myriadrf/LimeSDR-Micro/README.md

# LimeSDR Micro board M.2 (2280 B+M key) and mPCIe versions
NXP LA9310 Baseband processor + Lime Microsystems LMS7002M RF transceiver
