myriadrf/LimeSDR-Micro/hardware/M.2/1v2/PCB/LimeSDR-Micro_M.2_2280_1v2.PcbDoc.htm

Reporting Options

# File in Newer Format

Date | : | 2024-06-27
Time | : | 11:24:38
Filename | : | d:\LimePCBs\LimeSDR-Micro_M2\GIT\LimeSDR-Micro_M.2\hardware\1v0\PCB\LimeSDR-Micro_M.2_2280_1v0.PcbDoc

Version | Warning
Release 17.0 | CAUTION - Component parameters added.
Release 17.0 | CAUTION - Support of backdrilling
Release 17.1 | CAUTION - Support of waived violations
Release 17.1 | CAUTION - Support of object specific keepouts

This file was generated by a later version of the software
