myriadrf/LimeSDR-Micro/hardware/M.2/1v2/Project Outputs for LimeSDR-Micro_M.2_2280_1v2/ERC/LimeSDR-Micro_M.2_2280_1v2.html

Altium

# Electrical Rule Check Report

Date: | | 2026-03-31
Time: | | 09:28:13
Filename: | | d:\LimePCBs\LimeSDR-Micro\GIT\hardware\M.2\1v2\Project Outputs for LimeSDR-Micro_M.2_2280_1v2\ERC\LimeSDR-Micro_M.2_2280_1v2.html

Class | Document | Message

Warning

11_Power.SchDoc

GND contains IO Pin and Power Pin objects (Pin IC14-2,Pin IC18-4,Pin IC13-4,Pin IC2-4,Pin IC14-6,Pin IC4-7,Pin IC3-7,Pin IC6-B1,Pin IC6-B3,Pin IC6-B5,Pin IC6-B11,Pin IC6-B13,Pin IC6-B15,Pin IC6-C2,Pin IC6-C4,Pin IC6-C6,Pin IC6-C7,Pin IC6-C9,Pin IC6-C10,Pin IC6-C12,Pin IC6-C14,Pin IC6-D2,Pin IC6-D5,Pin IC6-D6,Pin IC6-D10,Pin IC6-D14,Pin IC6-E1,Pin IC6-E4,Pin IC6-E7,Pin IC6-E9,Pin IC6-E12,Pin IC6-E15,Pin IC4-EP,Pin IC3-EP,Pin IC6-F3,Pin IC6-F4,Pin IC6-F8,Pin IC6-F12,Pin IC6-G2,Pin IC6-G3,Pin IC6-G5,Pin IC6-G7,Pin IC6-G9,Pin IC6-G11,Pin IC6-H1,Pin IC6-H2,Pin IC6-H8,Pin IC6-H12,Pin IC6-H13,Pin IC6-H14,Pin IC6-H15,Pin IC6-J2,Pin IC6-J3,Pin IC6-J5,Pin IC6-J7,Pin IC6-J9,Pin IC6-J11,Pin IC6-J13,Pin IC6-K2,Pin IC6-K8,Pin IC6-K12,Pin IC6-L1,Pin IC6-L6,Pin IC6-L7,Pin IC6-L9,Pin IC6-L11,Pin IC6-M2,Pin X9-MOUNTING-HOLE,Pin IC6-N2,Pin IC6-N4,Pin IC6-N6,Pin X9-P1,Pin IC6-P1,Pin X9-P3,Pin IC6-P3,Pin IC6-P5,Pin X9-P21,Pin X9-P27,Pin X9-P33,Pin X9-P39,Pin X9-P45,Pin X9-P51,Pin X9-P57,Pin X9-P71,Pin X9-P73,Pin X9-P75,Pin IC13-PAD,Pin IC2-PAD)
Warning | 09_Misc.SchDoc | GNSS_FIX contains IO Pin and Output Pin objects (Pin IC14-21)
Warning | 10_Clock.SchDoc | LA_PPS_IN_LS contains IO Pin and Power Pin objects (Pin IC20-4,Pin IC6-K14)
Warning | 09_Misc.SchDoc | LA_PPS_OUT_LS contains IO Pin and Power Pin objects (Pin IC22-4,Pin IC6-M8)
Warning | 09_Misc.SchDoc | Net GNSS_ANT has no driving source (Pin ESD5-1,Pin IC11-3,Pin L1-1,Pin X5-1)
Warning | 09_Misc.SchDoc | Net GNSS_HW_R has no driving source (Pin C171-1,Pin IC11-7)
Warning | 09_Misc.SchDoc | Net GNSS_HW_S has no driving source (Pin C174-1,Pin IC11-8)
Warning | 09_Misc.SchDoc | Net LA_I2C_SCL has no driving source (Pin IC10-1,Pin IC10-4,Pin IC13-6,Pin IC14-8,Pin IC15-6,Pin IC18-5,Pin IC26-E5,Pin IC30-E5,Pin R26-1,Pin R115-2,Pin R204-2,Pin R222-2,Pin R225-2,Pin TP2-1,Pin VT1-D)
Warning | 05_LMS7002M_Misc.SchDoc | Net LMS_I2C_SCL has no driving source (Pin IC1-C27,Pin IC2-6,Pin R26-2,Pin R54-1)
Warning | 09_Misc.SchDoc | Net MCP_RESET has no driving source (Pin C178-1,Pin IC14-14,Pin R139-2)
Warning | 10_Clock.SchDoc | Net NetC185_2 has no driving source (Pin C185-2,Pin IC16-13)
Warning | 10_Clock.SchDoc | Net NetC186_2 has no driving source (Pin C186-2,Pin IC16-14)
Warning | 10_Clock.SchDoc | Net NetC192_2 has no driving source (Pin C192-2,Pin IC16-28)
Warning | 10_Clock.SchDoc | Net NetC193_2 has no driving source (Pin C193-2,Pin IC16-27)
Warning | 11_Power.SchDoc | Net NetC228_2 has no driving source (Pin C228-2,Pin FR45-2,Pin IC23-1,Pin IC23-6,Pin R194-1)
Warning | 11_Power.SchDoc | Net NetC238_2 has no driving source (Pin C238-2,Pin FR47-2,Pin IC27-1,Pin IC27-6,Pin R201-1)
Warning | 11_Power.SchDoc | Net NetC247_2 has no driving source (Pin C247-2,Pin FR48-2,Pin IC28-1,Pin IC28-6,Pin R207-1)
Warning | 11_Power.SchDoc | Net NetC254_2 has no driving source (Pin C254-2,Pin FR51-2,Pin IC29-1,Pin IC29-6,Pin R217-1)
Warning | 09_Misc.SchDoc | Net NetFR36_2 has no driving source (Pin FR36-2,Pin IC11-9)
Warning | 10_Clock.SchDoc | Net NetIC16_31 has no driving source (Pin IC16-31,Pin R156-2)
Warning | 10_Clock.SchDoc | Net NetIC18_2 has no driving source (Pin IC18-2,Pin R163-2,Pin R164-2)
Warning | 11_Power.SchDoc | Net NetIC23_5 has no driving source (Pin IC23-5,Pin R196-2,Pin R199-1)
Warning | 11_Power.SchDoc | Net NetIC27_5 has no driving source (Pin IC27-5,Pin R202-2,Pin R203-1)
Warning | 11_Power.SchDoc | Net NetIC28_5 has no driving source (Pin IC28-5,Pin R214-2,Pin R216-1)
Warning | 11_Power.SchDoc | Net NetIC29_5 has no driving source (Pin IC29-5,Pin R218-2,Pin R219-1)
Warning | 11_Power.SchDoc | Net NetIC31_4 has no driving source (Pin IC31-4,Pin R223-2,Pin R224-1)

Back to top
