myriadrf/LimeSDR-Micro/hardware/mPCIe/1v3/LimeSDR-Micro_mPCIe_1v3_DB_DFMr1/ERC/LimeSDR-Micro_mPCIe_1v3.html

Altium

# Electrical Rule Check Report

Date: | | 2026-01-09
Time: | | 19:05:35
Filename: | | D:\Aleksandr\Desktop\LimeSDR-Micro-main\LimeSDR-Micro-main\hardware\mPCIe\1v3\Project Outputs for LimeSDR-Micro_mPCIe_1v3\ERC\LimeSDR-Micro_mPCIe_1v3.html

Class | Document | Message

Warning

09_Misc.SchDoc

GND contains IO Pin and Power Pin objects (Pin IC15-3,Pin IC19-4,Pin IC14-4,Pin IC2-4,Pin IC15-6,Pin IC4-7,Pin IC3-7,Pin IC6-B1,Pin IC6-B3,Pin IC6-B5,Pin IC6-B11,Pin IC6-B13,Pin IC6-B15,Pin IC6-C2,Pin IC6-C4,Pin IC6-C6,Pin IC6-C7,Pin IC6-C9,Pin IC6-C10,Pin IC6-C12,Pin IC6-C14,Pin IC6-D2,Pin IC6-D5,Pin IC6-D6,Pin IC6-D10,Pin IC6-D14,Pin IC6-E1,Pin IC6-E4,Pin IC6-E7,Pin IC6-E9,Pin IC6-E12,Pin IC6-E15,Pin IC4-EP,Pin IC3-EP,Pin IC6-F3,Pin IC6-F4,Pin IC6-F8,Pin IC6-F12,Pin IC6-G2,Pin IC6-G3,Pin IC6-G5,Pin IC6-G7,Pin IC6-G9,Pin IC6-G11,Pin IC6-H1,Pin IC6-H2,Pin IC6-H8,Pin IC6-H12,Pin IC6-H13,Pin IC6-H14,Pin IC6-H15,Pin IC6-J2,Pin IC6-J3,Pin IC6-J5,Pin IC6-J7,Pin IC6-J9,Pin IC6-J11,Pin IC6-J13,Pin IC6-K2,Pin IC6-K8,Pin IC6-K12,Pin IC6-L1,Pin IC6-L6,Pin IC6-L7,Pin IC6-L9,Pin IC6-L11,Pin IC6-M2,Pin IC6-N2,Pin IC6-N4,Pin IC6-N6,Pin IC6-P1,Pin IC6-P3,Pin IC6-P5,Pin IC14-PAD,Pin IC2-PAD)
Warning | 09_Misc.SchDoc | GNSS_FIX contains IO Pin and Output Pin objects (Pin IC15-21)
Warning | 09_Misc.SchDoc | Net GNSS_ANT has no driving source (Pin ESD4-1,Pin IC11-3,Pin L1-1,Pin X5-1)
Warning | 09_Misc.SchDoc | Net GNSS_HW_R has no driving source (Pin C169-1,Pin IC11-7)
Warning | 09_Misc.SchDoc | Net GNSS_HW_S has no driving source (Pin C174-1,Pin IC11-8)
Warning | 10_Clock.SchDoc | Net LA_I2C_SCL has no driving source (Pin IC9-1,Pin IC9-4,Pin IC14-6,Pin IC15-8,Pin IC16-6,Pin IC19-5,Pin IC25-E5,Pin IC29-E5,Pin R26-1,Pin R132-2,Pin R140-2,Pin R175-2,Pin R197-2,Pin R215-2,Pin TP7-1,Pin VT1-D)
Warning | 05_LMS7002M_Misc.SchDoc | Net LMS_I2C_SCL has no driving source (Pin IC1-C27,Pin IC2-6,Pin R26-2,Pin R54-1)
Warning | 09_Misc.SchDoc | Net MCP_RESET has no driving source (Pin C178-1,Pin IC15-14,Pin R130-2)
Warning | 10_Clock.SchDoc | Net NetC185_2 has no driving source (Pin C185-2,Pin IC17-13)
Warning | 10_Clock.SchDoc | Net NetC186_2 has no driving source (Pin C186-2,Pin IC17-14)
Warning | 10_Clock.SchDoc | Net NetC192_2 has no driving source (Pin C192-2,Pin IC17-28)
Warning | 10_Clock.SchDoc | Net NetC193_2 has no driving source (Pin C193-2,Pin IC17-27)
Warning | 11_Power.SchDoc | Net NetC224_2 has no driving source (Pin C224-2,Pin FR44-2,Pin IC22-1,Pin IC22-6,Pin R187-1)
Warning | 11_Power.SchDoc | Net NetC234_2 has no driving source (Pin C234-2,Pin FR46-2,Pin IC26-1,Pin IC26-6,Pin R194-1)
Warning | 11_Power.SchDoc | Net NetC243_2 has no driving source (Pin C243-2,Pin FR47-2,Pin IC27-1,Pin IC27-6,Pin R200-1)
Warning | 11_Power.SchDoc | Net NetC250_2 has no driving source (Pin C250-2,Pin FR50-2,Pin IC28-1,Pin IC28-6,Pin R210-1)
Warning | 09_Misc.SchDoc | Net NetFR35_2 has no driving source (Pin FR35-2,Pin IC11-9)
Warning | 10_Clock.SchDoc | Net NetIC17_31 has no driving source (Pin IC17-31,Pin R152-2)
Warning | 10_Clock.SchDoc | Net NetIC19_2 has no driving source (Pin IC19-2,Pin R158-2,Pin R159-2)
Warning | 11_Power.SchDoc | Net NetIC22_5 has no driving source (Pin IC22-5,Pin R189-2,Pin R192-1)
Warning | 11_Power.SchDoc | Net NetIC26_5 has no driving source (Pin IC26-5,Pin R195-2,Pin R196-1)
Warning | 11_Power.SchDoc | Net NetIC27_5 has no driving source (Pin IC27-5,Pin R207-2,Pin R209-1)
Warning | 11_Power.SchDoc | Net NetIC28_5 has no driving source (Pin IC28-5,Pin R211-2,Pin R212-1)
Warning | 11_Power.SchDoc | Net NetIC30_4 has no driving source (Pin IC30-4,Pin R216-2,Pin R217-1)

Back to top
