myriadrf/LimeSDR-Micro/hardware/M.2/1v1/LimeSDR-Micro_M.2_2280_1v1_DB_DFMr0/DRC/LimeSDR-Micro_M.2_2280_1v1.html

Altium

# Design Rule Verification Report

Date: | | 2025-12-19
Time: | | 09:36:21
Elapsed Time: | | 00:00:29
Filename: | | d:\LimePCBs\LimeSDR-Micro\GIT\hardware\M.2\1v1\PCB\LimeSDR-Micro_M.2_2280_1v1.PcbDoc

Warnings: | | 0
Rule Violations: | | 0

## Summary

Warnings | Count
Total | 0

Rule Violations | Count
Clearance Constraint (Gap=0.1mm) (All),(All) | 0
Short-Circuit Constraint (Allowed=No) (All),(All) | 0
Un-Routed Net Constraint ( (All) ) | 0
Modified Polygon (Allow modified: No), (Allow shelved: No) | 0
Width Constraint (Min=0.1mm) (Max=5mm) (Preferred=0.2mm) (All) | 0
Width Constraint (Min=0.1mm) (Max=7mm) (Preferred=0.2mm) (All) | 0
Routing Layers(All) | 0
Routing Via (MinHoleWidth=0.15mm) (MaxHoleWidth=4.5mm) (PreferredHoleWidth=0.2mm) (MinWidth=0.3mm) (MaxWidth=5mm) (PreferedWidth=0.4mm) (All) | 0
Differential Pairs Uncoupled Length using the Gap Constraints (Min=0.1mm) (Max=0.2mm) (Prefered=0.1mm) and Width Constraints (Min=0.1mm) (Max=0.4mm) (Prefered=0.1mm) (InNet('FX3_XTAL_N') or InNet('FX3_XTAL_P')) | 0
Differential Pairs Uncoupled Length using the Gap Constraints (Min=0.1mm) (Max=0.14mm) (Prefered=0.1mm) and Width Constraints (Min=0.1mm) (Max=0.2mm) (Prefered=0.1mm) (InNetClass('TX_RF')) | 0
Differential Pairs Uncoupled Length using the Gap Constraints (Min=0.1mm) (Max=0.3mm) (Prefered=0.1mm) and Width Constraints (Min=0.1mm) (Max=0.3mm) (Prefered=0.1mm) (InNetClass('RX_RF')) | 0
Differential Pairs Uncoupled Length using the Gap Constraints (Min=0.1mm) (Max=0.3mm) (Prefered=0.1mm) and Width Constraints (Min=0.1mm) (Max=0.5mm) (Prefered=0.2mm) (All) | 0
Differential Pairs Uncoupled Length using the Gap Constraints (Min=0.1mm) (Max=0.3mm) (Prefered=0.14mm) and Width Constraints (Min=0.2mm) (Max=0.2mm) (Prefered=0.2mm) (InNetClass('FX3_DATA')) | 0
Power Plane Connect Rule(Relief Connect )(Expansion=0.508mm) (Conductor Width=0.254mm) (Air Gap=0.254mm) (Entries=4) (All) | 0
Hole Size Constraint (Min=0.15mm) (Max=10mm) (All) | 0
Pads and Vias to follow the Drill pairs settings | 0
Hole To Hole Clearance (Gap=0.15mm) (All),(All) | 0
Minimum Solder Mask Sliver (Gap=0.05mm) (All),(All) | 0
Net Antennae (Tolerance=0mm) (All) | 0
Matched Lengths(Tolerance=7mm) (InNetClass('LMS_PORT1')) | 0
Matched Lengths(Tolerance=5mm) (InNetClass('FT_FIFO')) | 0
Matched Lengths(Tolerance=7.5mm) (InNetClass('LMS_PORT2')) | 0
Component Clearance Constraint ( Horizontal Gap = -2mm, Vertical Gap = Infinite ) (HasFootprint('RAKON_RPT7050A')),(HasFootprint('RAKON_TXCO')) | 0
Component Clearance Constraint ( Horizontal Gap = 0.01mm, Vertical Gap = 0.254mm ) (All),(All) | 0
Component Clearance Constraint ( Horizontal Gap = -10mm, Vertical Gap = Infinite ) (InComponent('MECH*') or InComponent('J3')),(All) | 0
Component Clearance Constraint ( Horizontal Gap = -1mm, Vertical Gap = Infinite ) (InComponent('IC7')),(InComponent('R75') or InComponent('R74') or InComponent('R84')or InComponent('C131')) | 0
Component Clearance Constraint ( Horizontal Gap = -1mm, Vertical Gap = Infinite ) (HasFootprint('PCIE_M.2_2280_B+M_KEY')),(All) | 0
Height Constraint (Min=0mm) (Max=20mm) (Prefered=1.5mm) (OnTop) | 0
Height Constraint (Min=0mm) (Max=10mm) (Prefered=1.35mm) (OnBottom) | 0
Total | 0
