myriadrf/LimeSDR-Micro/hardware/M.2/1v0/LimeSDR-Micro_M.2_2280_1v0_DB_DFMr3/ERC/LimeSDR-Micro_M.2_2280_1v0.html

Altium

# Electrical Rule Check Report

Date: | | 2024-11-27
Time: | | 14:28:39
Filename: | | d:\LimePCBs\LimeSDR-Micro_M2\GIT\LimeSDR-Micro_M.2\hardware\1v0\Project Outputs for LimeSDR-Micro_M.2_2280_1v0\ERC\LimeSDR-Micro_M.2_2280_1v0.html

Class | Document | Message

Warning

11_Power.SchDoc

GND contains IO Pin and Power Pin objects (Pin IC14-2,Pin IC14-3,Pin IC18-4,Pin IC13-4,Pin IC2-4,Pin IC14-6,Pin IC4-7,Pin IC3-7,Pin IC6-B1,Pin IC6-B3,Pin IC6-B5,Pin IC6-B11,Pin IC6-B13,Pin IC6-B15,Pin IC6-C2,Pin IC6-C4,Pin IC6-C6,Pin IC6-C7,Pin IC6-C9,Pin IC6-C10,Pin IC6-C12,Pin IC6-C14,Pin IC6-D2,Pin IC6-D5,Pin IC6-D6,Pin IC6-D10,Pin IC6-D14,Pin IC6-E1,Pin IC6-E4,Pin IC6-E7,Pin IC6-E9,Pin IC6-E12,Pin IC6-E15,Pin IC4-EP,Pin IC3-EP,Pin IC6-F3,Pin IC6-F4,Pin IC6-F8,Pin IC6-F12,Pin IC6-G2,Pin IC6-G3,Pin IC6-G5,Pin IC6-G7,Pin IC6-G9,Pin IC6-G11,Pin IC6-H1,Pin IC6-H2,Pin IC6-H8,Pin IC6-H12,Pin IC6-H13,Pin IC6-H14,Pin IC6-H15,Pin IC6-J2,Pin IC6-J3,Pin IC6-J5,Pin IC6-J7,Pin IC6-J9,Pin IC6-J11,Pin IC6-J13,Pin IC6-K2,Pin IC6-K8,Pin IC6-K12,Pin IC6-L1,Pin IC6-L6,Pin IC6-L7,Pin IC6-L9,Pin IC6-L11,Pin IC6-M2,Pin X9-MOUNTING-HOLE,Pin IC6-N2,Pin IC6-N4,Pin IC6-N6,Pin X9-P1,Pin IC6-P1,Pin X9-P3,Pin IC6-P3,Pin IC6-P5,Pin X9-P21,Pin X9-P27,Pin X9-P33,Pin X9-P39,Pin X9-P45,Pin X9-P51,Pin X9-P57,Pin X9-P71,Pin X9-P73,Pin X9-P75,Pin IC13-PAD,Pin IC2-PAD)
Warning | 09_Misc.SchDoc | GNSS_FIX contains IO Pin and Output Pin objects (Pin IC14-21)
Warning | 10_Clock.SchDoc | LA_PPS_IN_LS contains IO Pin and Power Pin objects (Pin IC19-4,Pin IC6-K14)
Warning | 09_Misc.SchDoc | LA_PPS_OUT_LS contains IO Pin and Power Pin objects (Pin IC21-4,Pin IC6-M8)
Warning | 09_Misc.SchDoc | Net GNSS_ANT has no driving source (Pin ESD5-1,Pin IC11-3,Pin L1-1,Pin X5-1)
Warning | 09_Misc.SchDoc | Net GNSS_HW_R has no driving source (Pin C171-1,Pin IC11-7)
Warning | 09_Misc.SchDoc | Net GNSS_HW_S has no driving source (Pin C174-1,Pin IC11-8)
Warning | 09_Misc.SchDoc | Net LA_I2C_SCL has no driving source (Pin IC10-1,Pin IC10-4,Pin IC13-6,Pin IC14-8,Pin IC18-5,Pin IC25-E5,Pin IC29-E5,Pin R26-1,Pin R143-2,Pin R203-2,Pin R221-2,Pin TP4-1,Pin VT1-D)
Warning | 05_LMS7002M_Misc.SchDoc | Net LMS_I2C_SCL has no driving source (Pin IC1-C27,Pin IC2-6,Pin R26-2,Pin R54-1)
Warning | 09_Misc.SchDoc | Net MCP_RESET has no driving source (Pin C178-1,Pin IC14-14,Pin R135-2)
Warning | 11_Power.SchDoc | Net NetC225_2 has no driving source (Pin C225-2,Pin FR45-2,Pin IC22-1,Pin IC22-6,Pin R193-1)
Warning | 11_Power.SchDoc | Net NetC235_2 has no driving source (Pin C235-2,Pin FR47-2,Pin IC26-1,Pin IC26-6,Pin R200-1)
Warning | 11_Power.SchDoc | Net NetC244_2 has no driving source (Pin C244-2,Pin FR48-2,Pin IC27-1,Pin IC27-6,Pin R206-1)
Warning | 11_Power.SchDoc | Net NetC251_2 has no driving source (Pin C251-2,Pin FR51-2,Pin IC28-1,Pin IC28-6,Pin R216-1)
Warning | 09_Misc.SchDoc | Net NetFR36_2 has no driving source (Pin FR36-2,Pin IC11-9)
Warning | 10_Clock.SchDoc | Net NetIC18_2 has no driving source (Pin IC18-2,Pin R164-2,Pin R165-2)
Warning | 11_Power.SchDoc | Net NetIC22_5 has no driving source (Pin IC22-5,Pin R195-2,Pin R198-1)
Warning | 11_Power.SchDoc | Net NetIC26_5 has no driving source (Pin IC26-5,Pin R201-2,Pin R202-1)
Warning | 11_Power.SchDoc | Net NetIC27_5 has no driving source (Pin IC27-5,Pin R213-2,Pin R215-1)
Warning | 11_Power.SchDoc | Net NetIC28_5 has no driving source (Pin IC28-5,Pin R217-2,Pin R218-1)
Warning | 11_Power.SchDoc | Net NetIC30_4 has no driving source (Pin IC30-4,Pin R222-2,Pin R223-1)

Back to top
