myriadrf/LimeSDR-Micro/hardware/mPCIe/1v2/Project Outputs for LimeSDR-Micro_1v2/ERC/LimeSDR-Micro_1v2.html

Altium

# Electrical Rule Check Report

Date: | | 2024-11-27
Time: | | 17:11:42
Filename: | | d:\LimePCBs\LimeSDR-Micro\GIT\hardware\1v2\Project Outputs for LimeSDR-Micro_1v2\ERC\LimeSDR-Micro_1v2.html

Class | Document | Message

Warning

09_Misc.SchDoc

GND contains IO Pin and Power Pin objects (Pin IC15-2,Pin IC15-3,Pin IC19-4,Pin IC14-4,Pin IC2-4,Pin IC15-6,Pin IC4-7,Pin IC3-7,Pin IC6-B1,Pin IC6-B3,Pin IC6-B5,Pin IC6-B11,Pin IC6-B13,Pin IC6-B15,Pin IC6-C2,Pin IC6-C4,Pin IC6-C6,Pin IC6-C7,Pin IC6-C9,Pin IC6-C10,Pin IC6-C12,Pin IC6-C14,Pin IC6-D2,Pin IC6-D5,Pin IC6-D6,Pin IC6-D10,Pin IC6-D14,Pin IC6-E1,Pin IC6-E4,Pin IC6-E7,Pin IC6-E9,Pin IC6-E12,Pin IC6-E15,Pin IC4-EP,Pin IC3-EP,Pin IC6-F3,Pin IC6-F4,Pin IC6-F8,Pin IC6-F12,Pin IC6-G2,Pin IC6-G3,Pin IC6-G5,Pin IC6-G7,Pin IC6-G9,Pin IC6-G11,Pin IC6-H1,Pin IC6-H2,Pin IC6-H8,Pin IC6-H12,Pin IC6-H13,Pin IC6-H14,Pin IC6-H15,Pin IC6-J2,Pin IC6-J3,Pin IC6-J5,Pin IC6-J7,Pin IC6-J9,Pin IC6-J11,Pin IC6-J13,Pin IC6-K2,Pin IC6-K8,Pin IC6-K12,Pin IC6-L1,Pin IC6-L6,Pin IC6-L7,Pin IC6-L9,Pin IC6-L11,Pin IC6-M2,Pin IC6-N2,Pin IC6-N4,Pin IC6-N6,Pin IC6-P1,Pin IC6-P3,Pin IC6-P5,Pin IC14-PAD,Pin IC2-PAD)
Warning | 09_Misc.SchDoc | GNSS_FIX contains IO Pin and Output Pin objects (Pin IC15-21)
Warning | 09_Misc.SchDoc | Net GNSS_ANT has no driving source (Pin ESD5-1,Pin IC11-3,Pin L1-1,Pin X5-1)
Warning | 09_Misc.SchDoc | Net GNSS_HW_R has no driving source (Pin C171-1,Pin IC11-7)
Warning | 09_Misc.SchDoc | Net GNSS_HW_S has no driving source (Pin C176-1,Pin IC11-8)
Warning | 09_Misc.SchDoc | Net LA_I2C_SCL has no driving source (Pin IC9-1,Pin IC9-4,Pin IC14-6,Pin IC15-8,Pin IC19-5,Pin IC24-E5,Pin IC28-E5,Pin R26-1,Pin R138-2,Pin R140-2,Pin R194-2,Pin R212-2,Pin VT1-D)
Warning | 05_LMS7002M_Misc.SchDoc | Net LMS_I2C_SCL has no driving source (Pin IC1-C27,Pin IC2-6,Pin R26-2,Pin R54-1)
Warning | 09_Misc.SchDoc | Net MCP_RESET has no driving source (Pin C180-1,Pin IC15-14,Pin R130-2)
Warning | 11_Power.SchDoc | Net NetC223_2 has no driving source (Pin C223-2,Pin FR45-2,Pin IC21-1,Pin IC21-6,Pin R184-1)
Warning | 11_Power.SchDoc | Net NetC233_2 has no driving source (Pin C233-2,Pin FR47-2,Pin IC25-1,Pin IC25-6,Pin R191-1)
Warning | 11_Power.SchDoc | Net NetC242_2 has no driving source (Pin C242-2,Pin FR48-2,Pin IC26-1,Pin IC26-6,Pin R197-1)
Warning | 11_Power.SchDoc | Net NetC249_2 has no driving source (Pin C249-2,Pin FR51-2,Pin IC27-1,Pin IC27-6,Pin R207-1)
Warning | 09_Misc.SchDoc | Net NetFR36_2 has no driving source (Pin FR36-2,Pin IC11-9)
Warning | 10_Clock.SchDoc | Net NetIC19_2 has no driving source (Pin IC19-2,Pin R161-2,Pin R162-2)
Warning | 11_Power.SchDoc | Net NetIC21_5 has no driving source (Pin IC21-5,Pin R186-2,Pin R189-1)
Warning | 11_Power.SchDoc | Net NetIC25_5 has no driving source (Pin IC25-5,Pin R192-2,Pin R193-1)
Warning | 11_Power.SchDoc | Net NetIC26_5 has no driving source (Pin IC26-5,Pin R204-2,Pin R206-1)
Warning | 11_Power.SchDoc | Net NetIC27_5 has no driving source (Pin IC27-5,Pin R208-2,Pin R209-1)
Warning | 11_Power.SchDoc | Net NetIC29_4 has no driving source (Pin IC29-4,Pin R213-2,Pin R214-1)

Back to top
