myriadrf/LimeSDR-Micro/hardware/mPCIe/1v1/Project Outputs for LimeSDR-Micro_1v1/ERC/LimeSDR-Micro_1v1.html

Altium

# Electrical Rule Check Report

Date: | | 2024-06-27
Time: | | 14:33:22
Filename: | | d:\LimePCBs\LimeSDR-Micro\GIT\hardware\1v1\Project Outputs for LimeSDR-Micro_1v1\ERC\LimeSDR-Micro_1v1.html

Class | Document | Message

Warning

09_Misc.SchDoc

GND contains IO Pin and Power Pin objects (Pin IC15-2,Pin IC15-3,Pin IC21-4,Pin IC14-4,Pin IC2-4,Pin IC15-6,Pin IC4-7,Pin IC3-7,Pin IC6-B1,Pin IC6-B3,Pin IC6-B5,Pin IC6-B11,Pin IC6-B13,Pin IC6-B15,Pin IC6-C2,Pin IC6-C4,Pin IC6-C6,Pin IC6-C7,Pin IC6-C9,Pin IC6-C10,Pin IC6-C12,Pin IC6-C14,Pin IC6-D2,Pin IC6-D5,Pin IC6-D6,Pin IC6-D10,Pin IC6-D14,Pin IC6-E1,Pin IC6-E4,Pin IC6-E7,Pin IC6-E9,Pin IC6-E12,Pin IC6-E15,Pin IC4-EP,Pin IC3-EP,Pin IC6-F3,Pin IC6-F4,Pin IC6-F8,Pin IC6-F12,Pin IC6-G2,Pin IC6-G3,Pin IC6-G5,Pin IC6-G7,Pin IC6-G9,Pin IC6-G11,Pin IC6-H1,Pin IC6-H2,Pin IC6-H8,Pin IC6-H12,Pin IC6-H13,Pin IC6-H14,Pin IC6-H15,Pin IC6-J2,Pin IC6-J3,Pin IC6-J5,Pin IC6-J7,Pin IC6-J9,Pin IC6-J11,Pin IC6-J13,Pin IC6-K2,Pin IC6-K8,Pin IC6-K12,Pin IC6-L1,Pin IC6-L6,Pin IC6-L7,Pin IC6-L9,Pin IC6-L11,Pin IC6-M2,Pin IC6-N2,Pin IC6-N4,Pin IC6-N6,Pin IC6-P1,Pin IC6-P3,Pin IC6-P5,Pin IC14-PAD,Pin IC2-PAD)
Warning | 09_Misc.SchDoc | GNSS_FIX contains IO Pin and Output Pin objects (Pin IC15-21)
Warning | 09_Misc.SchDoc | Net GNSS_ANT has no driving source (Pin ESD5-1,Pin IC11-3,Pin L1-1,Pin X5-1)
Warning | 09_Misc.SchDoc | Net GNSS_HW_R has no driving source (Pin C171-1,Pin IC11-7)
Warning | 09_Misc.SchDoc | Net GNSS_HW_S has no driving source (Pin C176-1,Pin IC11-8)
Warning | 09_Misc.SchDoc | Net LA_I2C_SCL has no driving source (Pin IC9-1,Pin IC9-4,Pin IC14-6,Pin IC15-8,Pin IC21-5,Pin IC26-E5,Pin IC30-E5,Pin R26-1,Pin R140-2,Pin R142-2,Pin R197-2,Pin R211-2,Pin VT1-D,Pin X6-1)
Warning | 05_LMS7002M_Misc.SchDoc | Net LMS_I2C_SCL has no driving source (Pin IC1-C27,Pin IC2-6,Pin R26-2,Pin R54-1)
Warning | 09_Misc.SchDoc | Net MCP_RESET has no driving source (Pin C180-1,Pin IC15-14,Pin R128-2)
Warning | 11_Power.SchDoc | Net NetC216_2 has no driving source (Pin C216-2,Pin FR42-2,Pin IC24-1,Pin IC24-6,Pin R188-1)
Warning | 11_Power.SchDoc | Net NetC225_2 has no driving source (Pin C225-2,Pin FR44-2,Pin IC27-1,Pin IC27-6,Pin R194-1)
Warning | 11_Power.SchDoc | Net NetC234_2 has no driving source (Pin C234-2,Pin FR45-2,Pin IC28-1,Pin IC28-6,Pin R200-1)
Warning | 11_Power.SchDoc | Net NetC243_2 has no driving source (Pin C243-2,Pin FR50-2,Pin IC29-1,Pin IC29-6,Pin R204-1)
Warning | 09_Misc.SchDoc | Net NetFR36_2 has no driving source (Pin FR36-2,Pin IC11-9)
Warning | 10_Clock.SchDoc | Net NetIC21_2 has no driving source (Pin IC21-2,Pin R160-2,Pin R161-2)
Warning | 11_Power.SchDoc | Net NetIC24_5 has no driving source (Pin IC24-5,Pin R189-2,Pin R192-1)
Warning | 11_Power.SchDoc | Net NetIC27_5 has no driving source (Pin IC27-5,Pin R195-2,Pin R196-1)
Warning | 11_Power.SchDoc | Net NetIC28_5 has no driving source (Pin IC28-5,Pin R201-2,Pin R203-1)
Warning | 11_Power.SchDoc | Net NetIC29_5 has no driving source (Pin IC29-5,Pin R206-2,Pin R208-1)
Warning | 11_Power.SchDoc | Net NetIC31_4 has no driving source (Pin IC31-4,Pin R212-2,Pin R213-1)

Back to top
