myriadrf/LimeSDR-Micro/hardware/M.2/1v2/Project Outputs for LimeSDR-Micro_M.2_2280_1v2/BOM/LimeSDR-Micro_M.2_2280_1v2_BOMr0.xls

Item # | Comment | Quantity | Designator | Footprint | Manufacturer | Manufacturer Part Number 1 | Supplier 1 | Supplier Part Number 1 | Part Description
1 | 4.7pF, 25V | 14 | C1, C2, C3, C4, C5, C6, C9, C11, C14, C16, C19, C21, C24, C26 | CAP01005 | Murata | GRM0225C1E4R7BA03L | Digi-Key | 490-13585-1-ND | CAP CER 4.7PF 25V C0G/NP0 01005
2 | 22pF, 50V | 9 | C7, C169, C170, C171, C174, C222, C223, C224, C225 | CAP0201 | Murata | GRM0335C1H220JA01D | Digi-Key | 490-6123-1-ND | 22 pF ±5% 50V Ceramic Capacitor C0G, NP0 0201 (0603 Metric)
3 | 1uF, 6.3V | 60 | C28, C52, C54, C55, C56, C57, C58, C59, C61, C63, C65, C66, C67, C68, C70, C71, C72, C73, C74, C75, C76, C77, C78, C79, C80, C81, C82, C84, C85, C86, C87, C88, C89, C91, C93, C95, C97, C99, C100, C101, C102, C103, C104, C105, C106, C107, C108, C109, C110, C111, C115, C128, C150, C181, C187, C195, C198, C252, C265, C266 | CAP0201 | TDK Corporation | JMK063ABJ105MP-F | Digi-Key | 587-5864-2-ND | 1µF ±20% 6.3V X5R Ceramic Capacitor -55°C ~ 85°C Surface Mount, MLCC 0201 (0603 Metric) 0.024" L x 0.012" W (0.60mm x 0.30mm)
4 | 100pF, 50V | 20 | C29, C30, C33, C34, C133, C175, C182, C188, C189, C199, C200, C207, C208, C209, C211, C212, C213, C214, C215, C221 | CAP0201 | TDK | C0603C0G1H101J030BA | Digi-Key | 445-1786-1-ND | 100 pF ±5% 50V Ceramic Capacitor C0G, NP0 0201 (0603 Metric)
5 | 100nF, 6.3V | 44 | C31, C32, C35, C36, C45, C50, C51, C126, C132, C134, C151, C163, C164, C165, C166, C168, C172, C173, C177, C178, C179, C180, C183, C184, C185, C186, C190, C191, C192, C193, C194, C201, C202, C204, C205, C210, C216, C217, C218, C226, C227, C232, C244, C262 | CAP0201 | Samsung | CL03A104MP3NNNC | Digi-Key | 1276-1321-1-ND | 0.1 µF ±20% 10V Ceramic Capacitor X5R 0201 (0603 Metric)
6 | 1nF, 25V | 23 | C37, C38, C43, C46, C47, C48, C49, C53, C60, C62, C64, C69, C83, C90, C92, C94, C96, C98, C167, C203, C206, C219, C220 | CAP0201 | TDK Corporation | C0603X7R1E102K030BA | Digi-Key | 445-7275-1-ND | 1000pF ±10% 25V X7R Ceramic Capacitor -55°C ~ 125°C Surface Mount, MLCC 0201 (0603 Metric) 0.024" L x 0.012" W (0.60mm x 0.30mm)
7 | 510pF, 50V | 3 | C39, C40, C41 | CAP0402 | Murata Electronics North America | GRM1555C1H511JA01D | Digi-Key | 490-3237-1-ND | 510pF ±5% 50V C0G, NP0 Ceramic Capacitor -55°C ~ 125°C Surface Mount, MLCC 0402 (1005 Metric) 0.039" L x 0.020" W (1.00mm x 0.50mm)
8 | 220nF, 10V | 7 | C112, C113, C114, C116, C118, C125, C129 | CAP0201 | Murata | GRM033R61A224ME90D | Digi-Key | 490-9984-1-ND | 0.22 µF ±20% 10V Ceramic Capacitor X5R 0201 (0603 Metric)
9 | 1uF, 6.3V | 5 | C117, C135, C144, C148, C156 | CAP0603_FEEDTHROUGH | TDK | YFF18PH0J105MT000N | Digi-Key | 445-3029-1-ND | 1 µF Feed Through Capacitor 6.3V 4 A 12mOhm 0603 (1608 Metric), 4 PC Pad
10 | 47uF, 6.3V | 9 | C119, C236, C241, C245, C246, C256, C259, C263, C264 | CAP0603 | Murata | GRM188R60J476ME15D | Digi-Key | 490-13247-1-ND | 47 µF ±20% 6.3V Ceramic Capacitor X5R 0603 (1608 Metric)
11 | 4.7uF, 6.3V | 19 | C120, C122, C123, C130, C131, C138, C139, C140, C141, C142, C143, C146, C147, C154, C155, C159, C160, C161, C162 | CAP0201 | Murata | GRM035R60J475ME15J | Digi-Key | 490-GRM035R60J475ME15JCT-ND | 4.7 µF ±20% 6.3V Ceramic Capacitor X5R 0201 (0603 Metric)
12 | 2.2uF, 6.3V | 5 | C121, C136, C145, C152, C157 | CAP0201 | Murata | GRM033R60J225ME47D | Digi-Key | 490-13225-1-ND | CAP CER 2.2UF 6.3V X5R 0201
13 | 3.3nF, 16V | 1 | C124 | CAP0201 | Murata | GRM033R71C332KA88D | Digikey | 490-3191-1-ND | 3300 pF ±10% 16V Ceramic Capacitor X7R 0201 (0603 Metric)
14 | 10uF, 10V | 5 | C127, C137, C149, C153, C158 | CAP0402 | Murata | GRM155R61A106ME11D | Digi-Key | 490-GRM155R61A106ME11DCT-ND | 10 µF ±20% 10V Ceramic Capacitor X5R 0402 (1005 Metric)
15 | 4.7uF, 6.3V | 10 | C176, C228, C229, C238, C239, C247, C248, C250, C254, C255 | CAP0402 | Murata Electronics North America | GRM155R60J475ME87D | Digi-Key | 490-5408-1-ND | 4.7µF ±20% 6.3V X5R Ceramic Capacitor -55°C ~ 85°C Surface Mount, MLCC 0402 (1005 Metric) 0.039" L x 0.020" W (1.00mm x 0.50mm)
16 | 1uF, 10V | 1 | C230 | CAP0402 | TDK | C1005X5R1E105K050BC | Digi-Key | 445-9066-1-ND | 1µF ±10% 10V X5R Ceramic Capacitor -55°C ~ 85°C Surface Mount, MLCC 0402 (1005 Metric) 0.039" L x 0.020" W (1.00mm x 0.50mm)
17 | 10uF, 10V | 10 | C231, C235, C237, C240, C242, C251, C253, C257, C258, C261 | CAP0603 | Murata | GRM188R61A106ME69D | Digi-Key | 490-10475-1-ND | 10 µF ±20% 10V Ceramic Capacitor X5R 0603 (1608 Metric)
18 | RB521S-30L2-TP | 3 | D1, D2, D3 | RB521S-30L2-TP_DFN1006 | MCC | RB521S-30L2-TP | Digi-Key | RB521S-30L2-TPMSCT-ND | DIODE SCHOTTKY 30V 100MA 2TDFN
19 | ESD8472 | 9 | ESD1, ESD2, ESD3, ESD5, ESD6, ESD7, ESD8, ESD9, ESD10 | ESD8472_X3DFN2 | ON Semiconductor | ESD8472MUT5G | Digi-Key | ESD8472MUT5GOSCT-ND | TVS DIODE 5.3VWM 14VC X3DFN2
20 | Fiducial | 8 | F1, F2, F3, F4, F5, F6, F7, F8 | Fiducial
21 | Fiducial | 2 | FL1, FL2 | Fiducial_local
22 | 600R, 0.27A | 41 | FR2, FR3, FR4, FR5, FR6, FR7, FR8, FR9, FR10, FR11, FR12, FR13, FR14, FR15, FR16, FR17, FR18, FR19, FR20, FR21, FR22, FR23, FR24, FR25, FR26, FR27, FR28, FR29, FR30, FR31, FR32, FR33, FR34, FR35, FR36, FR37, FR39, FR40, FR42, FR43, FR44 | RES0201 | Taiyo Yuden | BK0603TS601-T | Digi-Key | 587-3277-1-ND | FERRITE BEAD 600 OHM 0201 1LN
23 | 220R, 0.9A | 8 | FR38, FR41, FR45, FR47, FR48, FR49, FR50, FR51 | RES0402 | TDK Corporation | MPZ1005S221ET000 | Digi-Key | 445-9329-2-ND | FERRITE BEAD 220 OHM 0402 1LN
24 | 600R, 2A | 1 | FR46 | RES0805 | TDK Corporation | MPZ2012S601AT000 | Digi-Key | 445-2206-2-ND | FERRITE BEAD 600 OHM 0805 1LN
25 | LMS7002M | 1 | IC1 | LMS7002M_v5_LESS_SILK | Lime Microsystems | LMS7002M | Lime Microsystems | LMS7002M | IC FPRF Transceiver LMS7002M; 261 pin aQFN
26 | SKY13414-485LF | 2 | IC3, IC4 | SKY13414-485LF_RF_SW_QFN14 | Skyworks Solutions | SKY13414-485LF | Digi-Key | 863-1582-1-ND | RF Switch IC General Purpose SP4T 3 GHz 50Ohm 14-QFN (2x2)
27 | SKY13330-397LF | 1 | IC5 | SKY13330-397LF_RF_SW_QFN12 | Skyworks Solutions | SKY13330-397LF | Digi-Key | 863-1643-1-ND | RF Switch IC W-CDMA SPDT 6 GHz 50Ohm 12-QFN (2x2)
28 | LA9310X7S11AA | 1 | IC6 | LA9310X7S11AA | NXP Semiconductors | LA9310X7S11AA | NXP Semiconductors | LA9310X7S11AA | LFBGA157, low profile, fine-pitch ball grid array package, 157 terminals, 0.5 mm pitch, 8 mm x 8 mm x 1.25 mm body.
29 | SN65LVDS1 | 1 | IC7 | SOT23-5_NO_SILK | TEXAS INSTRUMENTS | SN65LVDS1DBVR | Newark | 76C0715 | DIFFERENTIAL LINE DRIVER/RECEIVER SIGNAL SOT23-5
30 | SN74AVC4T774 | 3 | IC8, IC9, IC12 | SN74AVC4T774_v1 | Texas Instruments | SN74AVC4T774RSVR | Digi-Key | 296-24741-6-ND | Voltage Level Translator Bidirectional 1 Circuit 4 Channel 380Mbps 16-UQFN (2.6x1.8)
31 | TMP1075NDRLR | 1 | IC10 | TMP1075NDRLR_temperature_sensor_SOT563 | Texas Instruments | TMP1075NDRLR | Digi-Key | 296-TMP1075NDRLRCT-ND | Temperature Sensor Digital, Local -40°C ~ 125°C 12 b SOT-563
32 | GNSS M10578-A3 | 1 | IC11 | M10578-A3_v2 | Antenova | M10578-A3 | Digi-Key | 627-1074-1-ND | RADIONOVA RF Receiver GPS 1.575GHz -165dBm Module
33 | M24512 | 1 | IC13 | M24128-DFMC6TG | STMicroelectronics | M24512-DFMC6TG | Digi-Key | 497-15745-1-ND | IC EEPROM 512KBIT I2C 8UFDFPN
34 | MCP23017-E/ML | 1 | IC14 | MCP23017-E/ML_QFN28 | Microchip | MCP23017-E/ML | Digi-Key | MCP23017-E/ML-ND | I/O Expander 16 I²C 1.7 MHz 28-QFN (6x6)
35 | LMK00101 | 1 | IC16 | LMK00101_WQFN32 | Texas Instruments | LMK00101SQE/NOPB | Digi-Key | 296-39036-1-ND | Clock Fanout Buffer (Distribution), Multiplexer, Translator IC 200MHz 32-WFQFN Exposed Pad
36 | 74LVC1G3157FZ4 | 3 | IC17, IC19, IC24 | 74LVC1G3157FZ4_SPDT_SW_DFN1410-6 | Diodes | 74LVC1G3157FZ4-7 | Digi-Key | 74LVC1G3157FZ4-7DICT-ND | 1 Circuit IC Switch 2:1 10Ohm X2-DFN1410-6
37 | AD5693BCPZ-RL7 | 1 | IC18 | AD5693RACPZ-1RL7_DAC_8LFCSP | Analog Devices | AD5693BCPZ-RL7 | Digikey | 505-AD5693BCPZ-RL7CT-ND | 16 Bit Digital to Analog Converter 1 8-LFCSP-UD (2x2)
38 | SN74AVC1T45DRLR | 2 | IC20, IC22 | SN74AVC1T45DRLR_SOT-5X3 | Texas Instruments | SN74AVC1T45DRLR | Digi-Key | 296-21022-1-ND | Voltage Level Translator Bidirectional 1 Circuit 1 Channel 500Mbps SOT-5X3
39 | ADF4002 | 1 | IC21 | ADF4002 | Analog Devices Inc | ADF4002BCPZ-RL7 | Digi-Key | ADF4002BCPZ-RL7CT-ND | IC PLL FREQUENCY SYNTH 20-LFCSP
40 | LD39100PUR | 3 | IC23, IC27, IC28 | LD39100PUR | STMicroelectronics | LD39100PUR | Digi-Key | 497-11013-1-ND | Linear Voltage Regulator IC Positive Adjustable Output 0.8 V ~ 4.5 V 1A 6-DFN (3x3)
41 | AS431 | 1 | IC25 | SOT23-3_v3 | Diodes | AS431ANTR-G1 | Digikey | AS431ANTR-G1DICT-ND | Shunt Voltage Reference IC Adjustable 2.5V 36 VV ±0.5% 100 mA SOT-23-3
42 | LP8758A2E3YFFR | 2 | IC26, IC30 | LP8758A1E0YFFR_QUAD_DC-DC_35DSBGA | Texas Instruments | LP8758A2E3YFFR | Digi-Key | 296-LP8758A2E3YFFRCT-ND | Buck Switching Regulator IC Positive Programmable 0.5V 4 Output 4A 35-UFBGA, DSBGA, Switching Voltage Regulators Four-phase, four 4A output DC-DC step-down converters 35-DSBGA -40 to 85
43 | AP7330 | 1 | IC31 | AP7330-W5-7_SOT25 | Diodes | AP7330-W5-7 | Digi-Key | AP7330-W5-7DICT-ND | Linear Voltage Regulator IC Positive Adjustable 1 Output 300mA SOT-25
44 | MHF4 | 9 | J2, J3, J4, J5, J6, X1, X2, X4, X5 | IPEX_MHF4_conn | TE Connectivity / Linx Technologies | CONMHF4-SMD-G-T | Digikey | 343-CONMHF4-SMD-G-TCT-ND | IPEX MHF4 Connector Jack, Male Pin 50 Ohms Surface Mount Solder
45 | 47nH | 1 | L1 | RES0402 | COILCRAFT | 0402HP-47NXJLU | Farnell | 2285856 | INDUCTOR, RF, 47NH, 5%, 2.4GHZ, SMD; Product Range:0402HP Series; Inductance:47nH; Inductance Tolerance:± 5%; High Frequency Inductor Case:0402 [1005 Metric]; Self Resonant Frequency Min:2.4GHz; DC Resistance Max:0.58ohm; DC Current Rating:420mA
46 | 0.47uH, 4A | 8 | L2, L3, L4, L5, L6, L7, L8, L9 | IND0806 | TDK | VLS201610HBX-R47M-1 | Digi-Key | 445-172395-1-ND | 470 nH Shielded Drum Core, Wirewound Inductor 2.81 A 41mOhm Max 0806 (2016 Metric)
47 | LED_green | 2 | LED1, LED2 | LED0201 | Kingbright | APG0603CGC-TT | Digi-Key | 754-2021-1-ND | Green 571nm LED Indication - Discrete 1.97V 2-SMD, 0201
48 | BMI-S-202-C | 1 | MECH1 | BMI-S-202-C_RF_SHIELD_COVER | Laird | BMI-S-202-C | Digi-Key | 903-1014-ND | RF Shield Cover 0.668" (16.96mm) X 0.668" (16.96mm) Vent Holes in Pattern Snap Fit
49 | BMI-S-202-F | 1 | MECH2 | BMI-S-202-F_RF_SHIELD_FRAME_v3 | Laird | BMI-S-202-F | Digi-Key | 903-1051-1-ND | RF Shield Frame 0.650" (16.50mm) X 0.650" (16.50mm) Surface Mount
50 | 10 nH, 5% | 4 | MN1, MN2, MN33, MN34 | RES0402 | Murata | LQW15AN10NJ00D | Digi-Key | 490-1146-6-ND | RF Inductors - SMD 10 NH 5%
51 | 10 pF, 50V | 6 | MN3, MN6, MN23, MN24, MN29, MN30 | CAP0402 | Walsin Technologies | 0402N100D500CT | Digi-Key | 1292-0402N100D500CT-ND | 10 pF ±0.5pF 50V Ceramic Capacitor C0G, NP0 0402 (1005 Metric)
52 | 100uH | 2 | MN7, MN8 | RES0805 | TDK Corporation | MLF2012C101KT000 | Digi-Key | 445-1071-1-ND | FIXED IND 100UH 2MA 3.1 OHM SMD
53 | 0R | 7 | MN9, MN10, R15, R65, R69, R211, R212 | RES0402 | Yageo | RC0402JR-070RL | Digi-Key | 311-0.0JRTR-ND | RES SMD 0.0OHM JUMPER 1/16W 0402
54 | 100nF, 16V | 2 | MN11, MN14 | CAP0402 | Murata Electronics | GRM155R71C104KA88D | Mouser | 81-GRM155R71C104KA88 | 0.10µF ±10% 16V X7R Ceramic Capacitor -55°C ~ 125°C Surface Mount, MLCC 0402 (1005 Metric) 0.039" L x 0.020" W (1.00mm x 0.50mm)
55 | 2pF, 50V | 1 | MN13 | CAP0402 | AVX | 04025U2R0BAT2A | Farnell | 2332536 | SMD Multilayer Ceramic Capacitor, U Series, 2 pF, ± 0.1pF, C0G / NP0, 50 V, 0402 [1005 Metric]
56 | 470pF, 50V | 4 | MN15, MN16, MN21, MN22 | CAP0402 | TDK Corporation | C1005C0G1H471J050BA | Digi-Key | 445-2656-6-ND | 470pF ±5% 50V Ceramic Capacitor C0G, NP0 0402 (1005 Metric)
57 | 100pF, 50V | 4 | MN31, MN32, MN37, MN38 | CAP0402 | Yageo | CC0402JRNPO9BN101 | Digi-Key | 311-1024-1-ND | 100pF ±5% 50V C0G, NP0 Ceramic Capacitor -55°C ~ 125°C Surface Mount, MLCC 0402 (1005 Metric) 0.039" L x 0.020" W (1.00mm x 0.50mm)
58 | 0.8pF | 2 | MN35, MN36 | CAP0402 | Murata Electronics North America | GRM1555C1HR80BA01D | Digi-Key | 490-6269-1-ND | 0.80pF ±0.1pF 50V C0G, NP0 Ceramic Capacitor -55°C ~ 125°C Surface Mount, MLCC 0402 (1005 Metric) 0.039" L x 0.020" W (1.00mm x 0.50mm)
59 | 243R, 1% | 4 | R1, R5, R14, R19 | RES01005 | Yageo | RC0100FR-07243RL | Digi-Key | YAG6284CT-ND | RES 243 OHM 1% 1/32W 01005
60 | 220R, 1% | 12 | R2, R4, R16, R18, R27, R33, R36, R41, R43, R48, R50, R57 | RES01005 | Yageo | RC0100FR-07220RL | Digi-Key | YAG6275CT-ND | 220 Ohms ±1% 0.03W, 1/32W Chip Resistor 01005 (0402 Metric) Moisture Resistant Thick Film
61 | 82R, 1% | 2 | R3, R17 | RES01005 | Cyntec | PFR02S-820-FNH | DigiKey | 2037-PFR02S-820-FNHCT-ND | RES SMD 82 OHM 1% 1/32W 01005
62 | 100R, 1% | 3 | R6, R9, R161 | RES0201 | Yageo | RC0201FR-07100RL | Digi-Key | 311-100MCT-ND | 100 Ohms ±1% 0.05W, 1/20W Chip Resistor 0201 (0603 Metric) Moisture Resistant Thick Film
63 | 0R | 29 | R7, R24, R68, R76, R84, R95, R114, R129, R138, R140, R141, R146, R153, R154, R156, R157, R160, R163, R168, R174, R176, R187, R192, R198, R213, R217, R225, R226, R229 | RES0201 | Yageo | RC0201JR-070RL | Digi-Key | 311-0.0NCT-ND | 0 Ohms Jumper Chip Resistor 0201 (0603 Metric) Moisture Resistant Thick Film
64 | 10k, 1% | 28 | R8, R10, R11, R12, R25, R35, R72, R73, R89, R115, R116, R117, R118, R119, R120, R122, R123, R124, R125, R128, R139, R159, R184, R186, R195, R199, R203, R216 | RES0201 | Yageo | RC0201FR-0710KL | Digi-Key | 311-10.0KMCT-ND | 10 kOhms ±1% 0.05W, 1/20W Chip Resistor 0201 (0603 Metric) Moisture Resistant Thick Film
65 | 47R, 1% | 17 | R20, R21, R22, R23, R79, R91, R92, R93, R94, R150, R152, R172, R178, R181, R188, R190, R191 | RES0201 | Yageo | RC0201FR-0747RL | Digi-Key | YAG2694CT-ND | 47 Ohms ±1% 0.05W, 1/20W Chip Resistor 0201 (0603 Metric) Moisture Resistant Thick Film
66 | 0R | 16 | R28, R34, R37, R42, R44, R49, R51, R58, R105, R106, R107, R108, R109, R110, R111, R112 | RES01005 | Panasonic | ERJ-XGN0R00Y | Digi-Key | P0.0AWCT-ND | RES SMD 0 OHM JUMP 1/32W 01005
67 | 1k, 1% | 8 | R29, R32, R38, R40, R45, R47, R52, R56 | RES01005 | Cyntec | PFR02S-102-FNH | Digi-Key | 2037-PFR02S-102-FNHCT-ND | RES SMD 1K OHM 1% 1/32W 01005
68 | 3k3, 1% | 7 | R53, R54, R130, R135, R136, R220, R223 | RES0201 | Yageo | RC0201FR-073K3L | Digi-Key | YAG2285CT-ND | 3.3 kOhms ±1% 0.05W, 1/20W Chip Resistor 0201 (0603 Metric) Moisture Resistant Thick Film
69 | 1k, 1% | 5 | R59, R60, R61, R87, R177 | RES0201 | Yageo | RC0201FR-071KL | Digi-Key | 311-1KMDKR-ND | 1 kOhms ±1% 0.05W, 1/20W Chip Resistor 0201 (0603 Metric) Moisture Resistant Thick Film
70 | 4.7k, 1% | 4 | R62, R63, R64, R224 | RES0201 | Yageo | RC0201FR-074K7L | Digi-Key | 311-4.70KMCT-ND | 4.7 kOhms ±1% 0.05W, 1/20W Chip Resistor 0201 (0603 Metric) Moisture Resistant Thick Film
71 | 10R, 1% | 6 | R66, R67, R70, R71, R90, R175 | RES0201 | Panasonic Electronic Components | ERJ-1GEF10R0C | Digi-Key | P10.0ABCT-ND | RES SMD 10 OHM 1% 1/20W 0201
72 | 0R33, 1% | 1 | R75 | RES0201 | Ohmite | KDV02FR330ET | Digi-Key | 273-KDV02FR330ETCT-ND | 330 mOhms ±1% 0.1W, 1/10W Chip Resistor 0201 (0603 Metric) Current Sense Metal Film
73 | 698R, 1% | 1 | R80 | RES0201 | Yageo | RC0201FR-07698RL | Digi-Key | YAG2775CT-ND | 698 Ohms ±1% 0.05W, 1/20W Chip Resistor 0201 (0603 Metric) Moisture Resistant Thick Film
74 | 200R, 1% | 1 | R81 | RES0201 | Yageo | AC0201FR-07200RL | Digi-Key | YAG5171CT-ND | RES SMD 200 OHM 1% 1/20W 0201
75 | 6.8R, 1% | 2 | R82, R86 | RES0201 | Yageo | RC0201FR-076R8L | Digi-Key | 13-RC0201FR-076R8LCT-ND | RES 6.8 OHM 1% 1/20W 0201
76 | 5R1, 1% | 1 | R83 | RES0201 | Yageo | RC0201FR-075R1L | Digi-Key | 13-RC0201FR-075R1LCT-ND | 5.1 Ohms ±1% 0.05W, 1/20W Chip Resistor 0201 (0603 Metric) Moisture Resistant Thick Film
77 | 47R, 1% | 8 | R96, R97, R98, R99, R100, R101, R102, R103 | RES01005 | Yageo | RC0100FR-0747RL | Digi-Key | YAG6360CT-ND | RES 47 OHM 1% 1/32W 01005
78 | 2.67k, 1% | 1 | R104 | RES0201 | Stackpole Electronics | RMCF0201FT2K67 | Digi-Key | RMCF0201FT2K67CT-ND | RES 2.67K OHM 1% 1/20W 0201
79 | 15R, 1% | 1 | R113 | RES0201 | Yageo | RC0201FR-0715RL | Digi-Key | 311-15.0MCT-ND | 15 Ohms ±1% 0.05W, 1/20W Chip Resistor 0201 (0603 Metric) Moisture Resistant Thick Film
80 | 330R, 1% | 5 | R143, R145, R148, R185, R197 | RES0201 | Vishay Dale | CRCW0201330RFKED | Digi-Key | 541-330AABCT-ND | 330 Ohms ±1% 0.05W, 1/20W Chip Resistor 0201 (0603 Metric) Thick Film
81 | 100k, 1% | 4 | R147, R149, R206, R221 | RES0201 | Yageo | RC0201FR-07100KL | Digi-Key | 311-100KMCT-ND | 100 kOhms ±1% 0.05W, 1/20W Chip Resistor 0201 (0603 Metric) Moisture Resistant Thick Film
82 | 470, 1% | 1 | R180 | RES0201 | Yageo | RC0201FR-07470RL | Digi-Key | YAG2689CT-ND | 470 Ohms ±1% 0.05W, 1/20W Chip Resistor 0201 (0603 Metric) Moisture Resistant Thick Film
83 | 5.6k, 1% | 1 | R196 | RES0201 | Yageo | RC0201FR-075K6L | Digi-Key | YAG2346CT-ND | 5.6 kOhms ±1% 0.05W, 1/20W Chip Resistor 0201 (0603 Metric) Moisture Resistant Thick Film
84 | 7.5k, 1% | 1 | R202 | RES0201 | Stackpole Electronics | RMCF0201FT7K50 | Digi-Key | RMCF0201FT7K50CT-ND | 7.5 kOhms ±1% 0.05W, 1/20W Chip Resistor 0201 (0603 Metric) Thick Film
85 | 47k, 1% | 1 | R205 | RES0201 | Yageo | RC0201FR-0747KL | Digi-Key | 311-47KMCT-ND | 47 kOhms ±1% 0.05W, 1/20W Chip Resistor 0201 (0603 Metric) Moisture Resistant Thick Film
86 | 12.7k, 1% | 1 | R214 | RES0201 | Yageo | RC0201FR-0712K7L | Digi-Key | 311-12.7KMCT-ND | 12.7 kOhms ±1% 0.05W, 1/20W Chip Resistor 0201 (0603 Metric) Moisture Resistant Thick Film
87 | 3600BL14M050 | 3 | T1, T5, T6 | 3600BL14M050_balun_0603 | Johanson | 3600BL14M050T | Digi-Key | 712-1048-1-ND | Signal Conditioning 3.6GHz 1:1 BALUN
88 | TC1-1-13M-45+ | 3 | T2, T7, T8 | TC1-1-13MA+_JA4220-AL_ | Minicircuits | TC1-1-13M-45+ | Minicircuits | TC1-1-13M-45+ | RF balun; 1:1 ratio; 3 dB bandwidth: 0.3 MHz to 3.5 GHz; 3.8mm x 3.8mm
89 | B0322J5050AHF | 2 | T3, T4 | Anaren_0805_balun_B0322J5050AHF | Anaren | B0322J5050AHF | Mouser | 620-B0322J5050AHF | Signal Conditioning 300-2200MHz 50 Ohm IL=1.6dB
90 | DMG1012T | 2 | VT1, VT2 | SOT523 | Diodes Incorporated | DMG1012TQ-7 | Digi-Key | DMG1012TQ-7DICT-ND | N-Channel 20V 630mA (Ta) 280mW (Ta) Surface Mount SOT-523
91 | 5025981593 | 2 | X6, X7 | 5025981593_FPC_connector | Molex | 5025981593 | Digi-Key | 900-5025981593CT-ND | 15 Position FPC Connector Contacts, Top and Bottom 0.012" (0.30mm) Surface Mount, Right Angle
92 | 8-pin FPC connector | 1 | X8 | 503480-0800_8PIN_FPC_CONN | Molex | 503480-0800 | Digi-Key | WM1388CT-ND | 8 Position FFC, FPC Connector Contacts, Top and Bottom 0.020" (0.50mm) Surface Mount, Right Angle
93 | E6245LF 30.72 MHz | 1 | XO1 | RAKON_RPT7050A | Rakon | E6245LF | Rakon | E6245LF | TCXO 30.72MHz, E6245LF
