myriadrf/LimeSDR-Micro/hardware/mPCIe/1v4/Project Outputs for LimeSDR-Micro_mPCIe_1v4/LimeSDR-Micro_mPCIe_1v4_Schematic_(Default)_r0.PDF

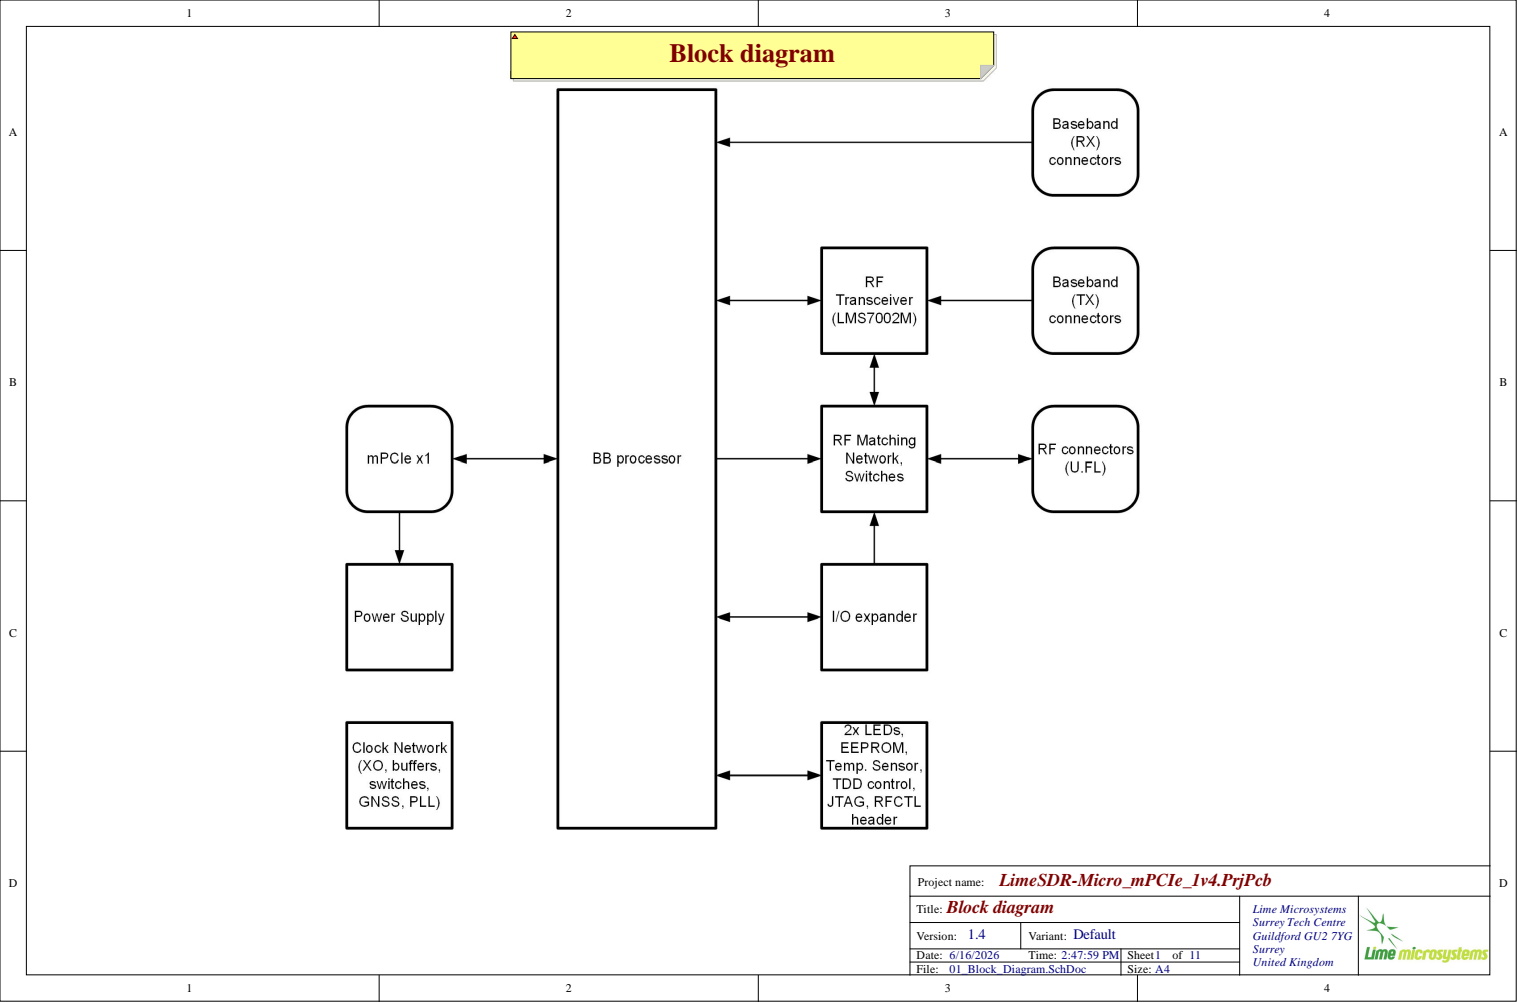
[picture p1: page 1]

Block diagram Title: | Lime Microsystems Surrey Tech Centre Guildford GU2 7YG Surrey

Version: 1.4 | Variant: Default

Date: 6/16/2026 Time: 2:47:59 PM | Sheet of | United Kingdom 11
File: 01_Block_Diagram.SchDoc | Size: A4

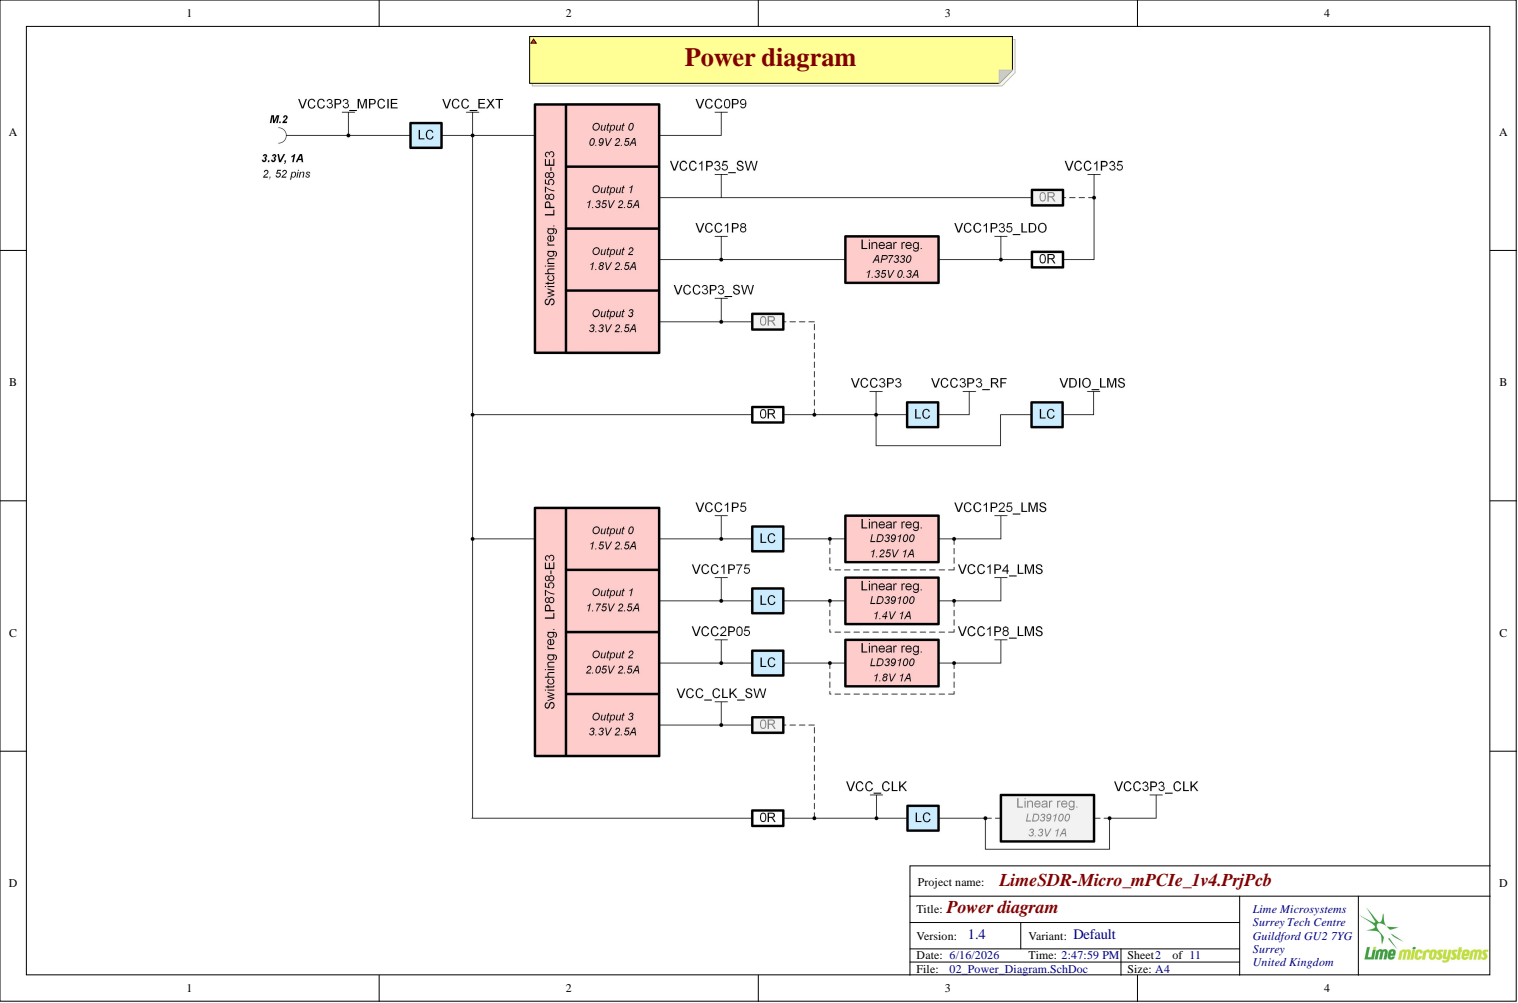
[picture p2: page 2]

6/16/2026 2:47:59 PM
02_Power_Diagram.SchDoc

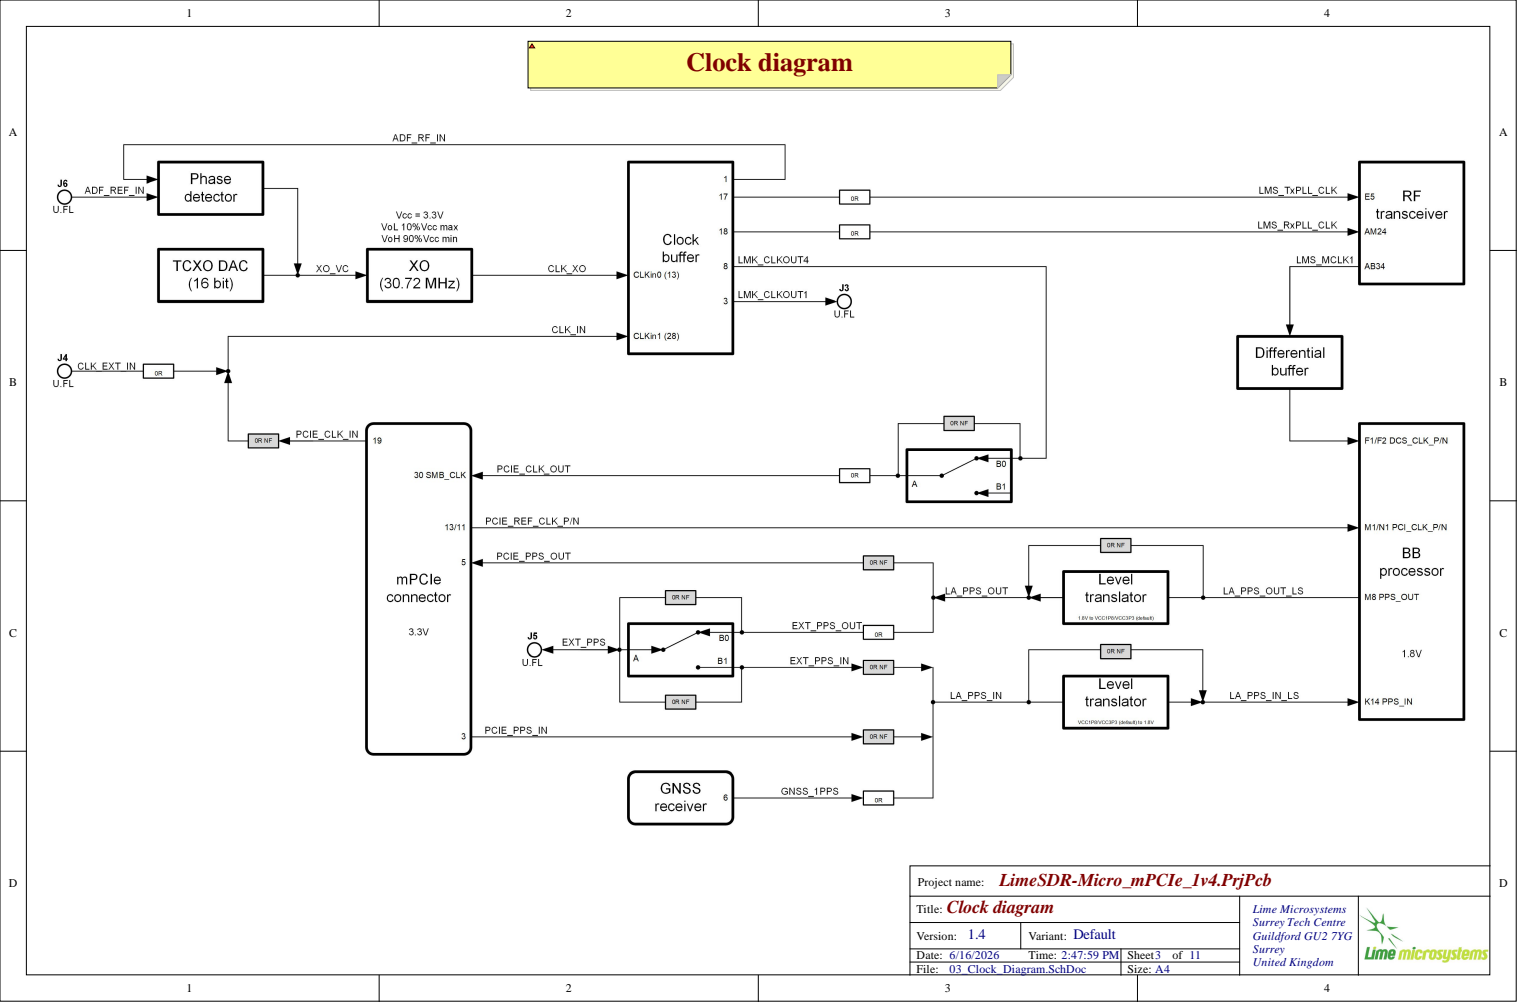
[picture p3: page 3]

6/16/2026 2:47:59 PM
03_Clock_Diagram.SchDoc

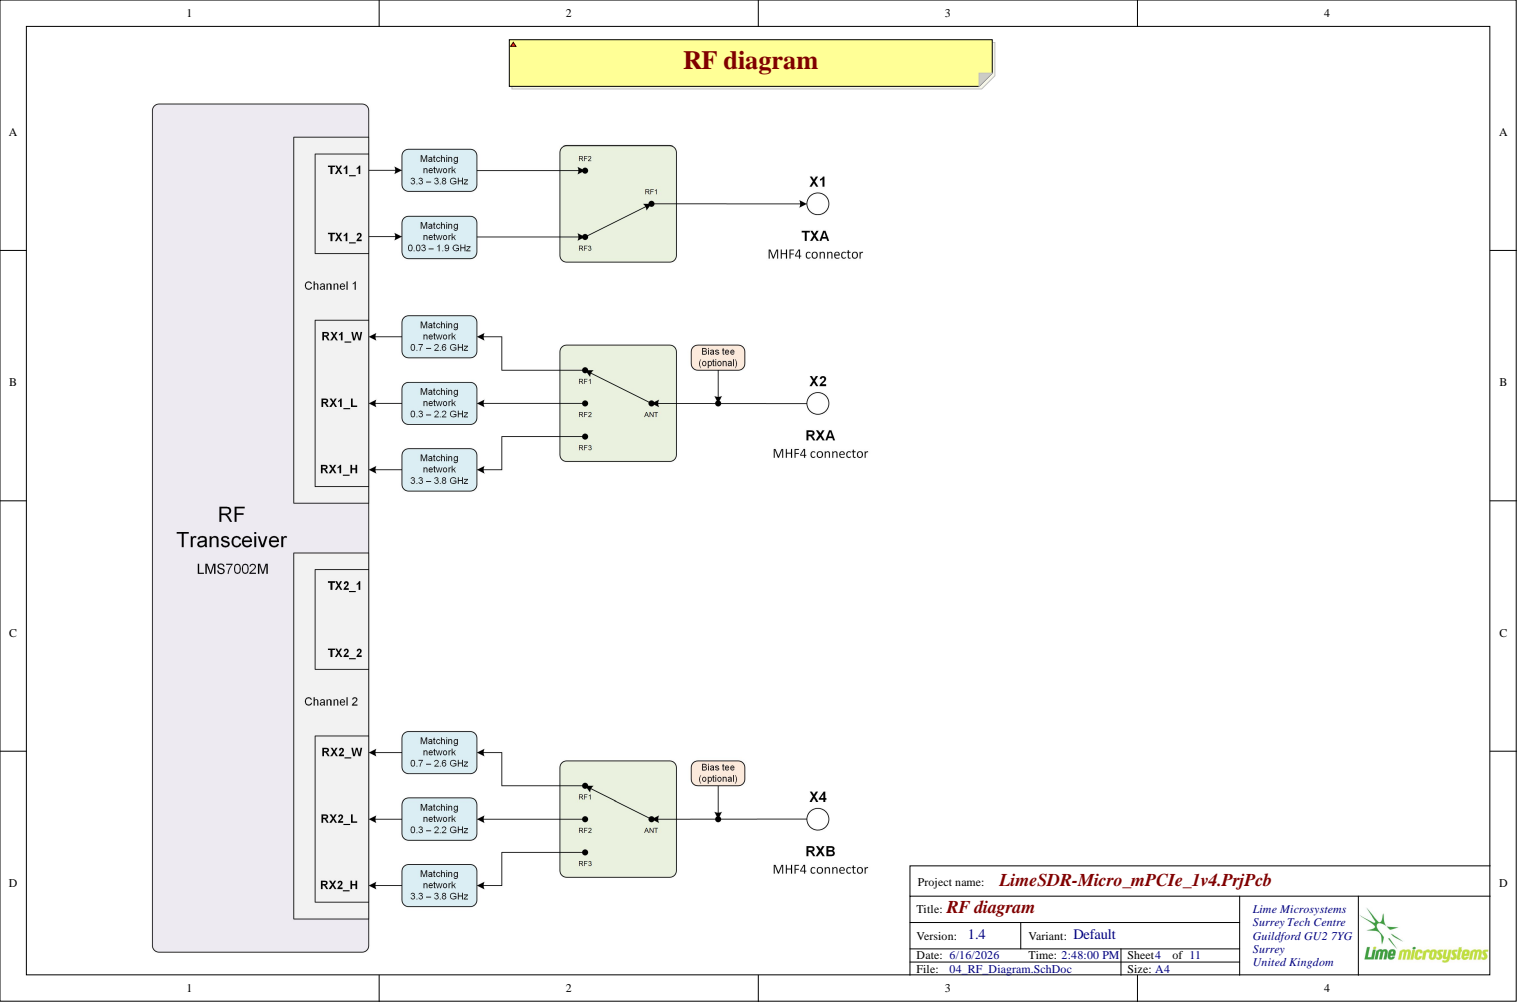
[picture p4: page 4]

6/16/2026 2:48:00 PM
04_RF_Diagram.SchDoc

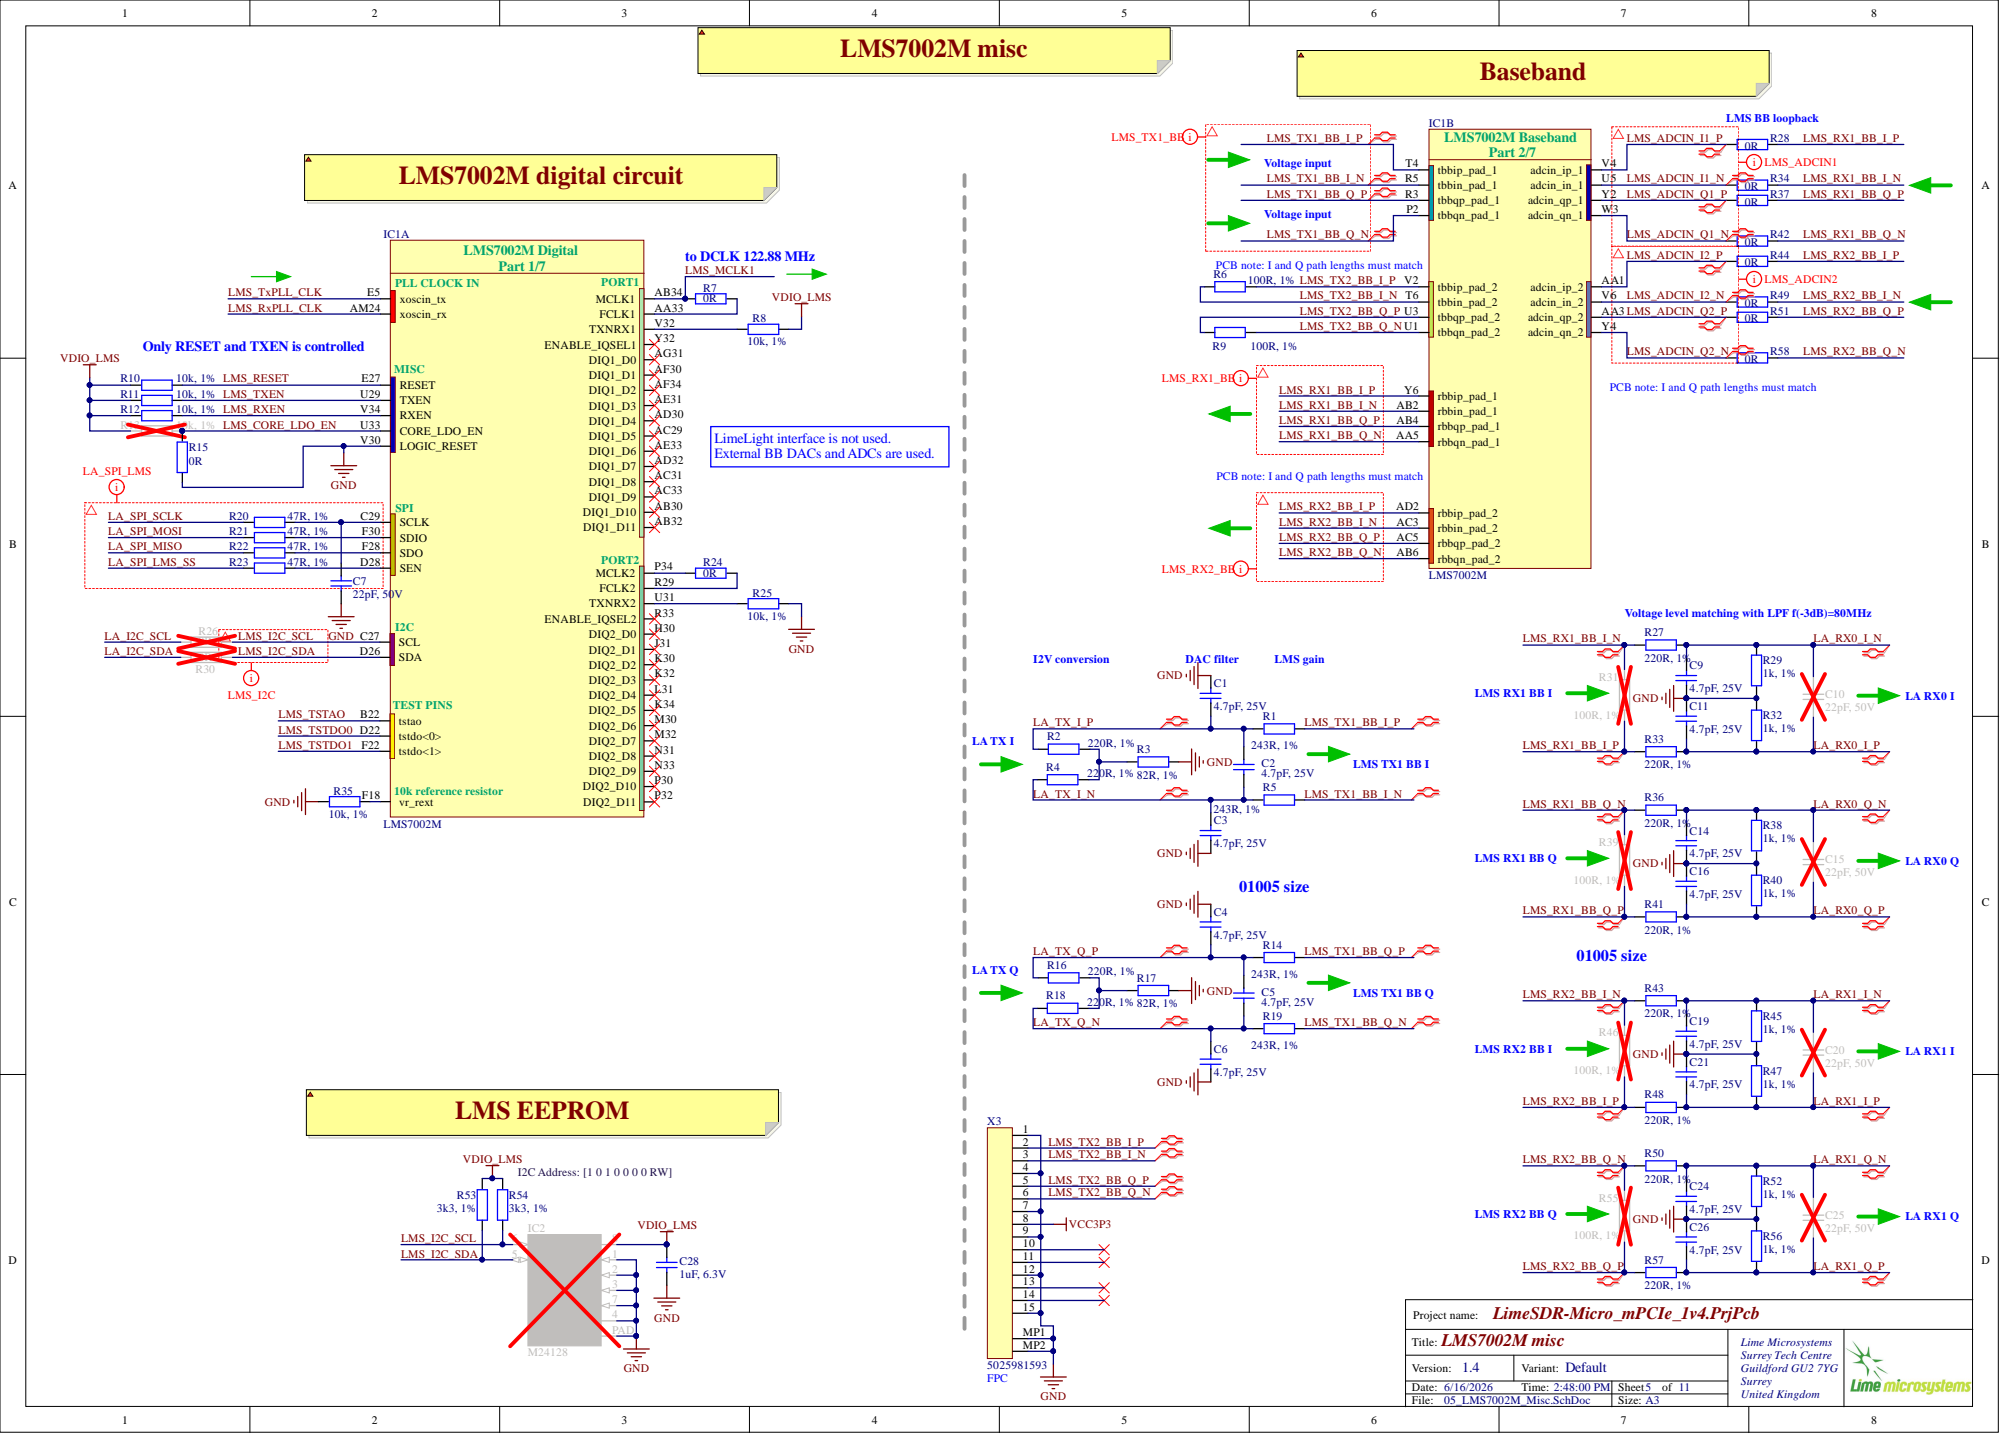
[picture p5: page 5]

MP1
MP2

LMS70 02 M misc T t le: | Li me M icro sys tem s S u r rey Tech Cen t re G u i l dfo rd G U2 7YG S u r rey Un ted Ki n g d o m

Vers o n : 1.4 | Varian t : D efa ult

/ / T ime: : : 0 PM | Sheet o f

Fi le: _ LMS7 2M_Mi sc.Sch D o c | Size: A

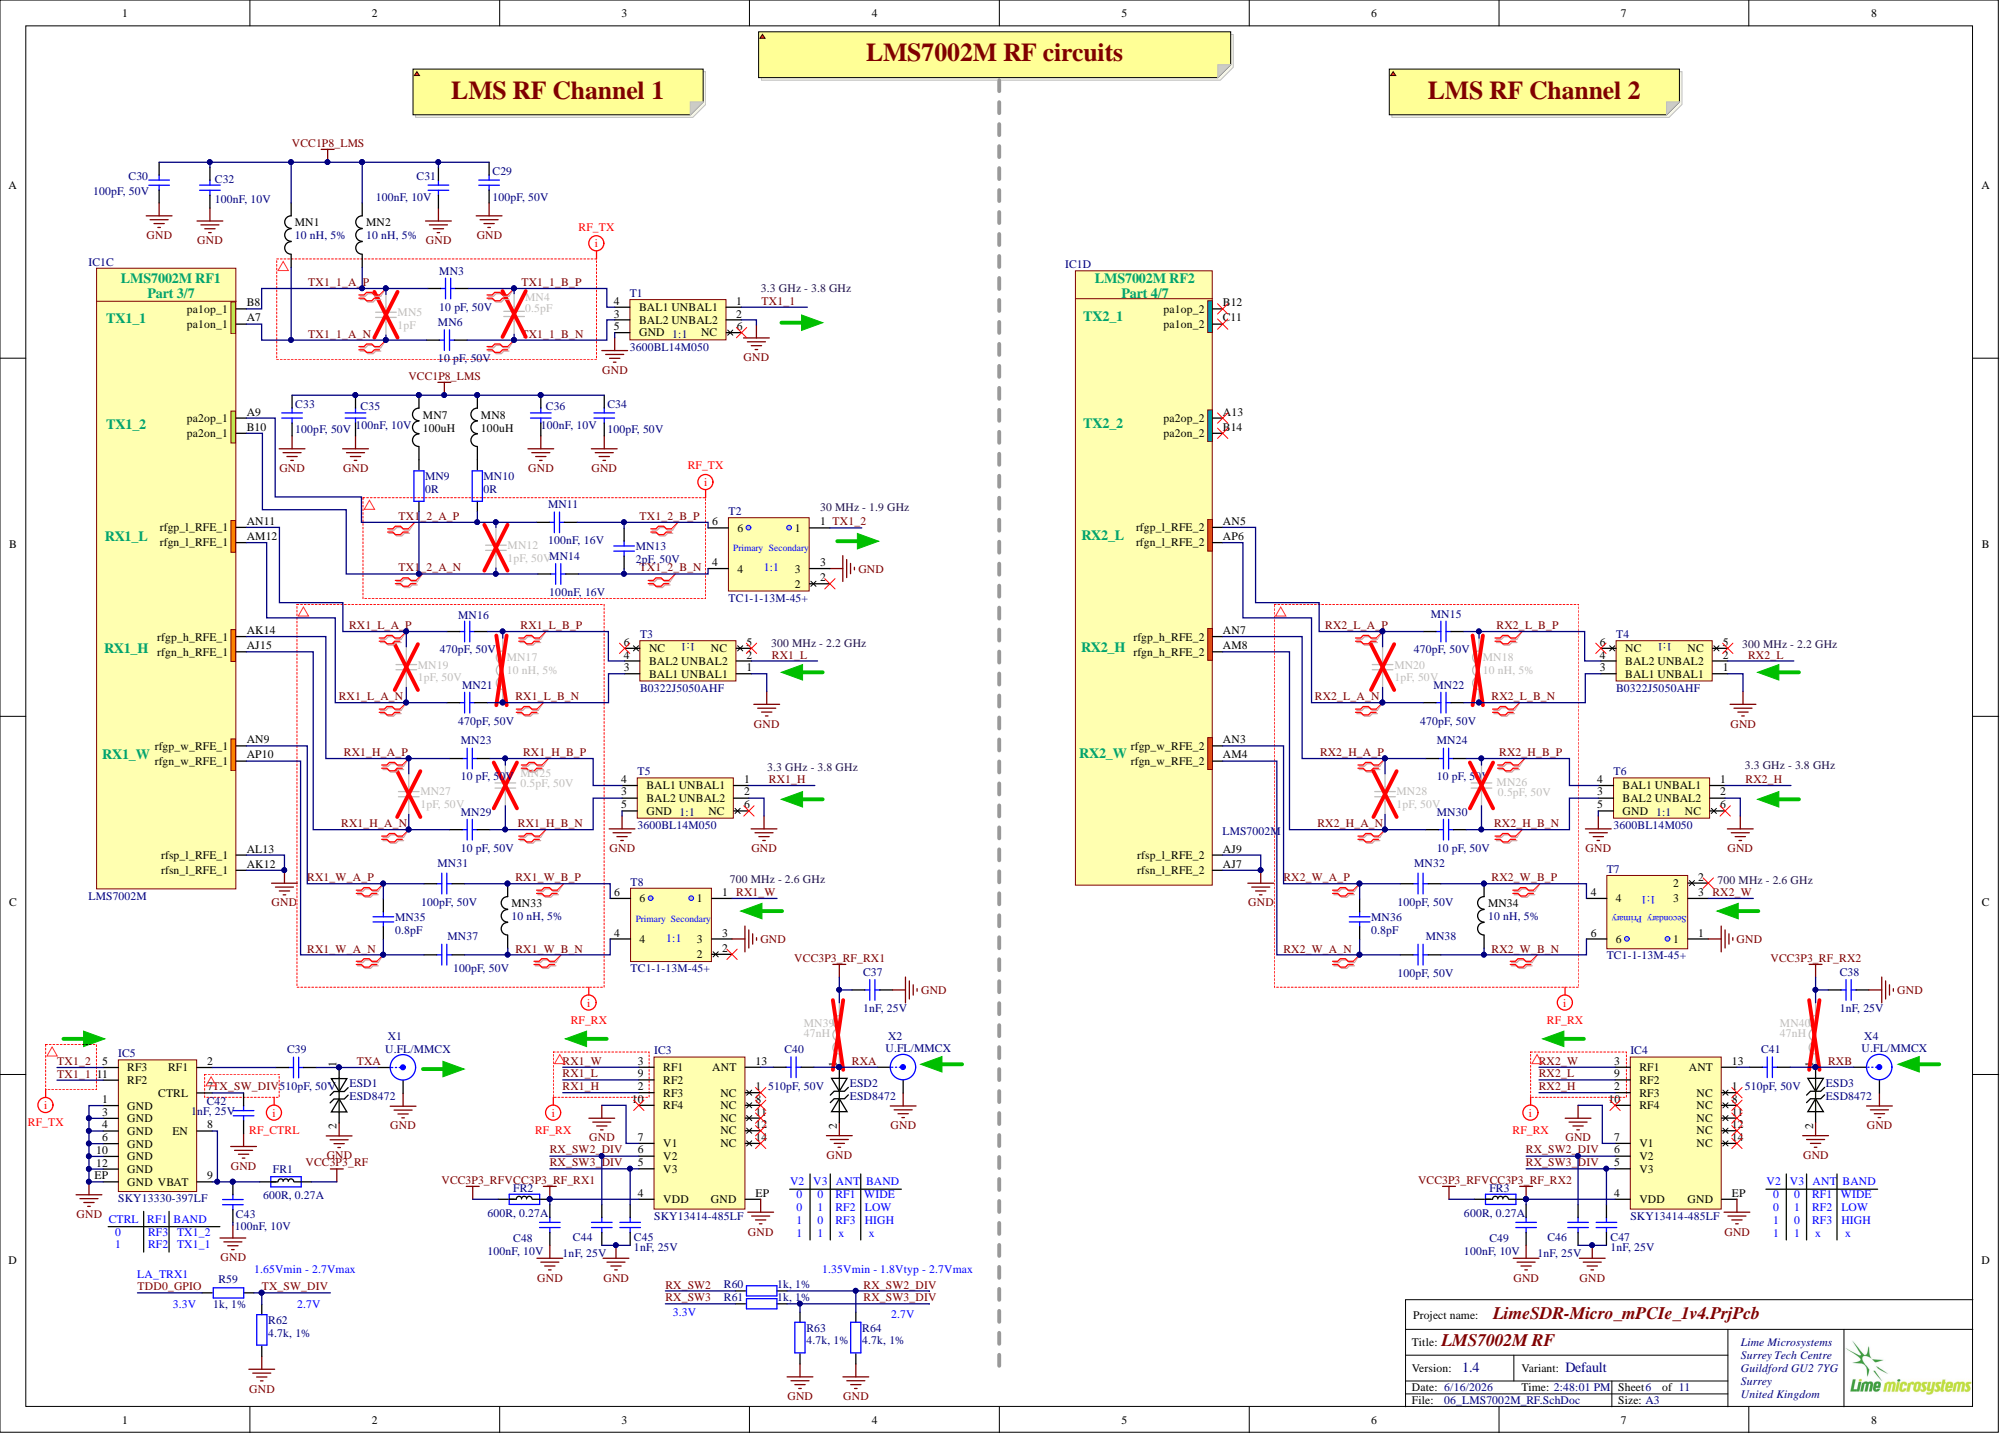
[picture p6: page 6]

6/16/2026 2:48:01 PM
06_LMS7002M_RF.SchDoc

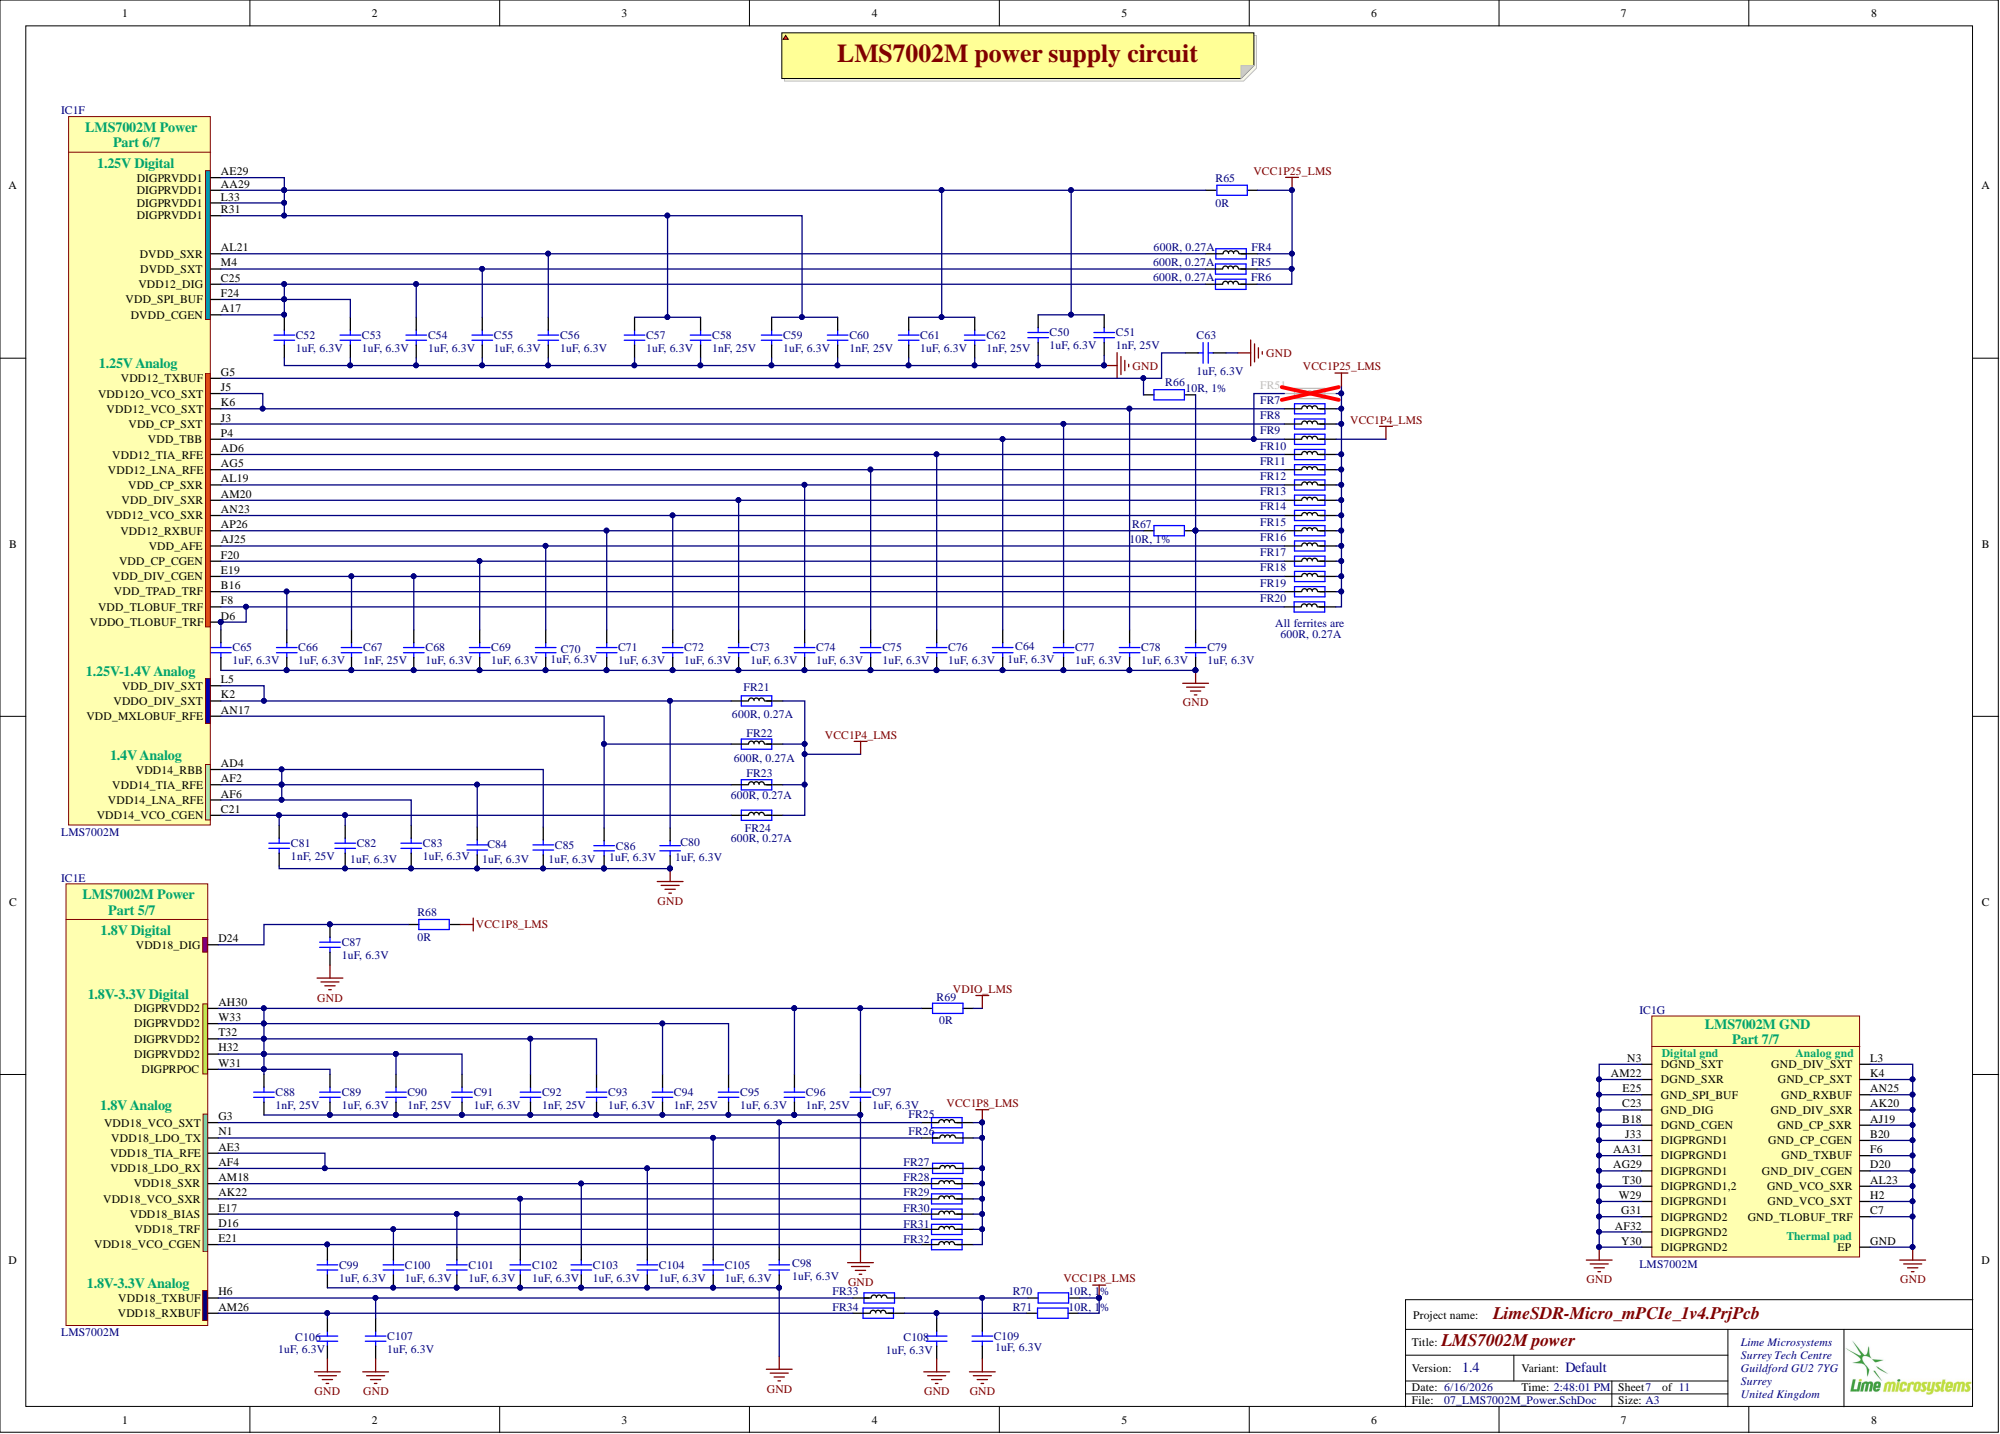
[picture p7: page 7]

A A 2 9
L 3 3

A 1 7

A D 6 | | FR1 0
A G 5 | | | FR1 1
A L 1 9 | | | | FR1 2
AM2 0 | | | | | FR1 3
A N 2 3 | | | | | | FR1 4
AP2 6 | | | | | | | FR1 5
A J 2 5 | | | | | | | 1 0R, 1 | FR1 6
0 | | | | | | | | | FR1 7
E 1 9 | | | | | | | | | | FR1 8
6 | | | | | | | | | | | FR1 9

K 2
A N 1 7 | 6 0 0R, 0.2 7 A FR2 2

A D 4
AF2
AF6 | 6 7 A

W 3 3
T 3 2
H 3 2
W 3 1

LMS70 02 M p ower T t le: | Li me M icro sys tem s S u r rey Tech Cen t re G u l dfo rd G U2 7YG S u r rey Un ted Ki n g d o m

Vers o n : 1.4 | Varian t : D efa ult

/ / T ime: : : 1 PM | Sheet o f

Fi le: _ LMS7 2M_Po wer.Sch D o c | Size: A

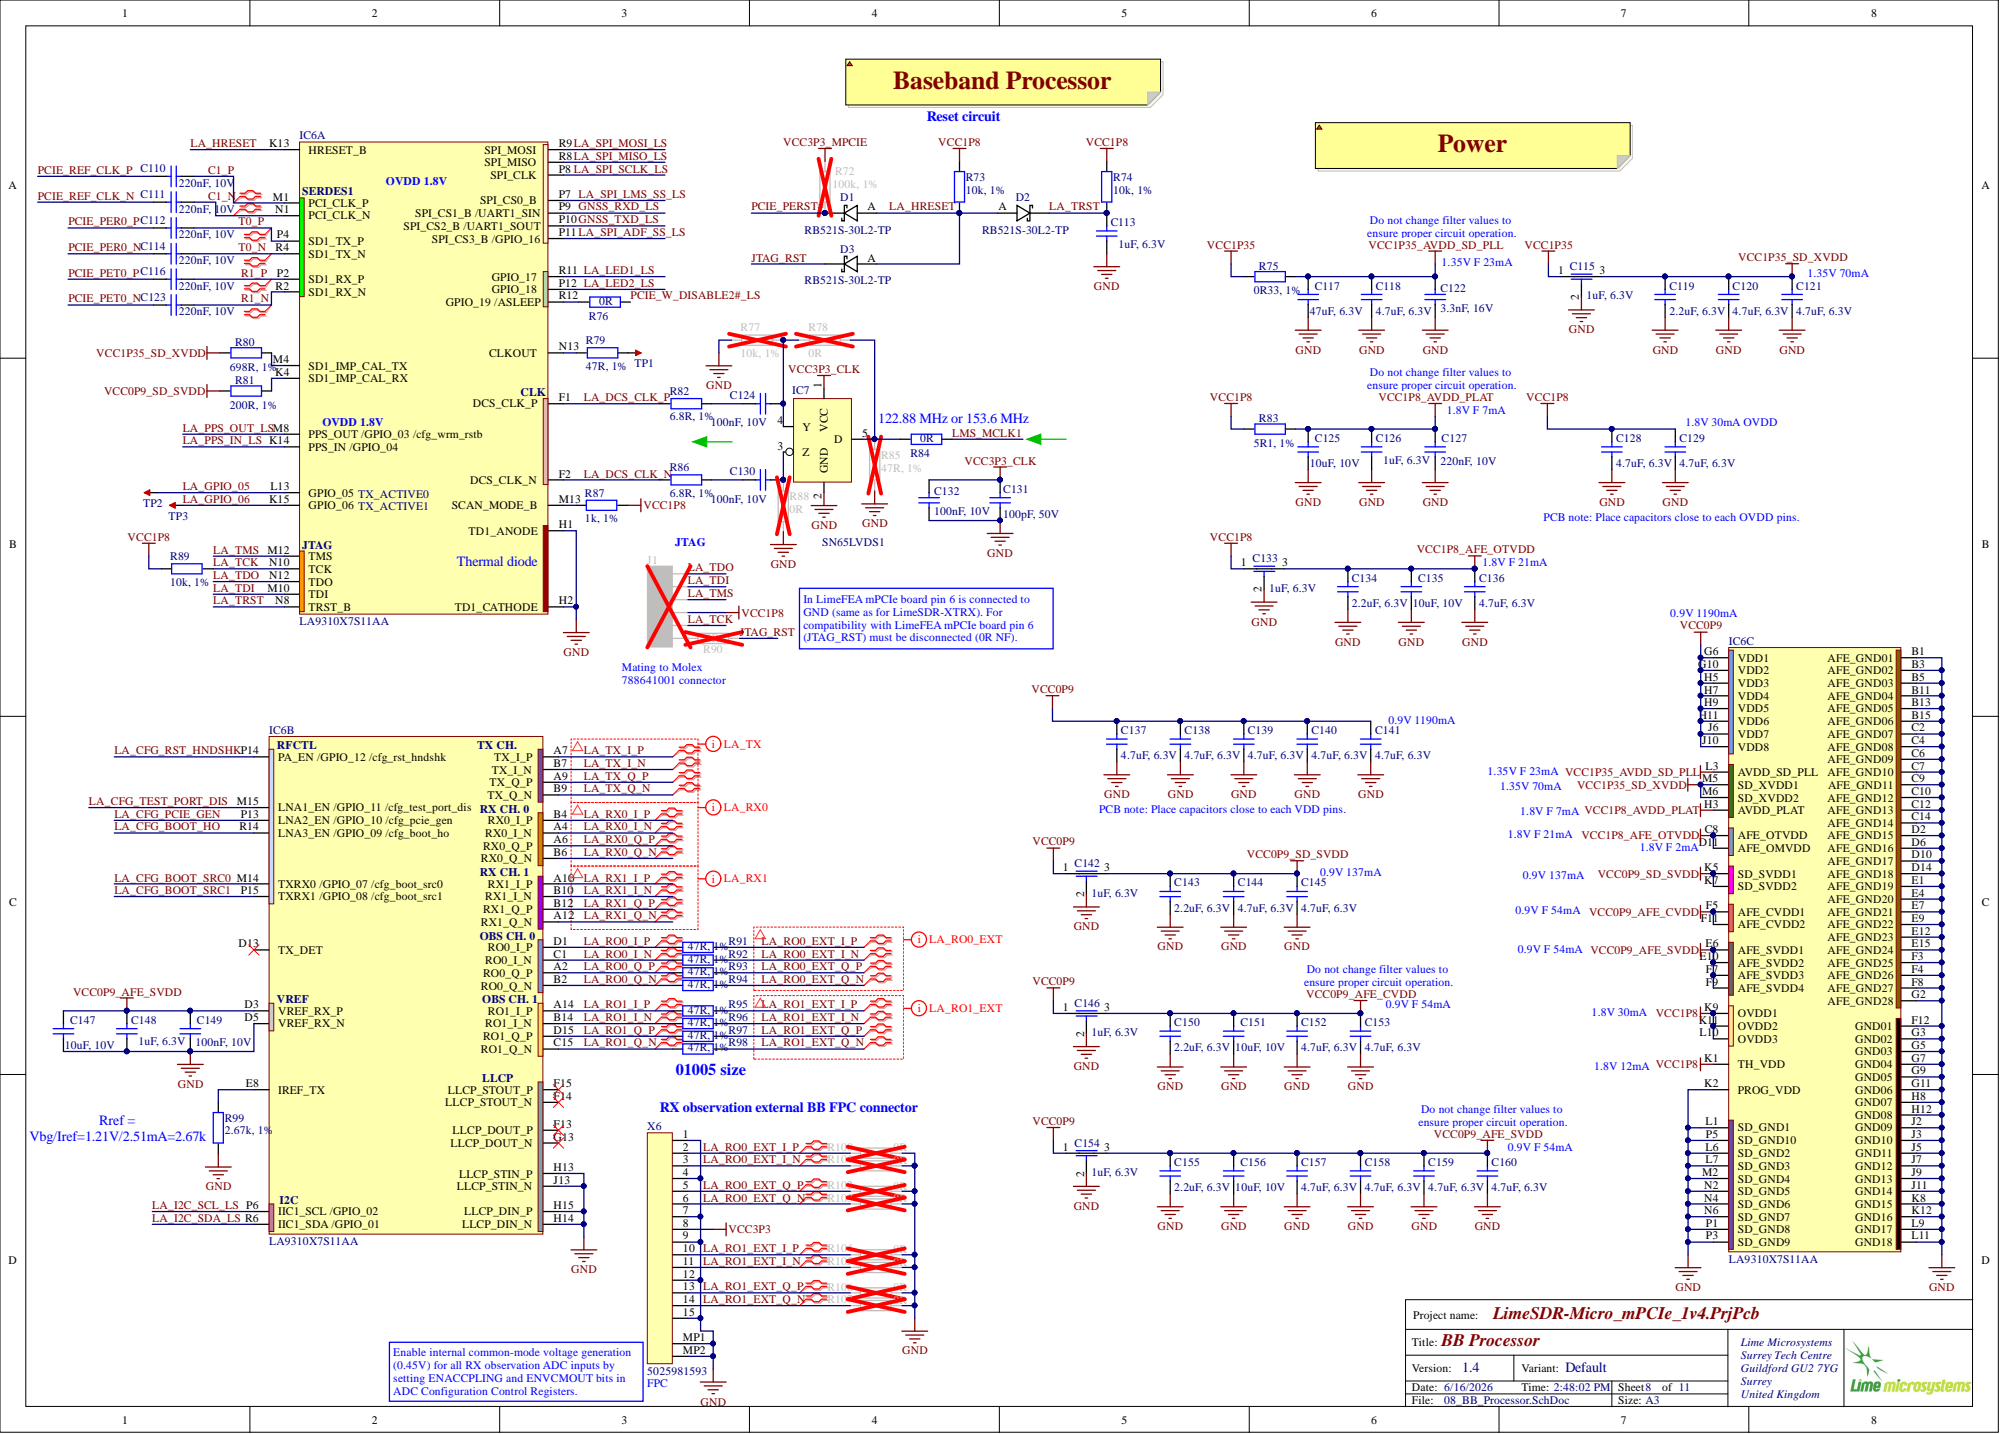
[picture p8: page 8]

H 7 | 1
H 9 | 3
H 1 1 | 5

L A _RO 0 _I_ N | %R9 2 | L A _RO 0 _ E X T _I_ N
L A _RO 0 _ Q _ P | %R9 3 | L A _RO 0 _ E X T _ Q _ P

1 1 | L A _RO 1 _ E X T _I_ N R1 0 5 | 0 | R
1 2 | | | R

BB Processo r T t le: | Li me M icro sys tem s S u r rey Tech Cen t re G u l dfo rd G U2 7YG S u r rey Un ted Ki n g d o m

Vers o n : 1.4 | Varian t : D efa ult

/ / T ime: : : 2 PM | Sheet o f

Fi le: _BB_Proces s o r.Sch D o c | Size: A

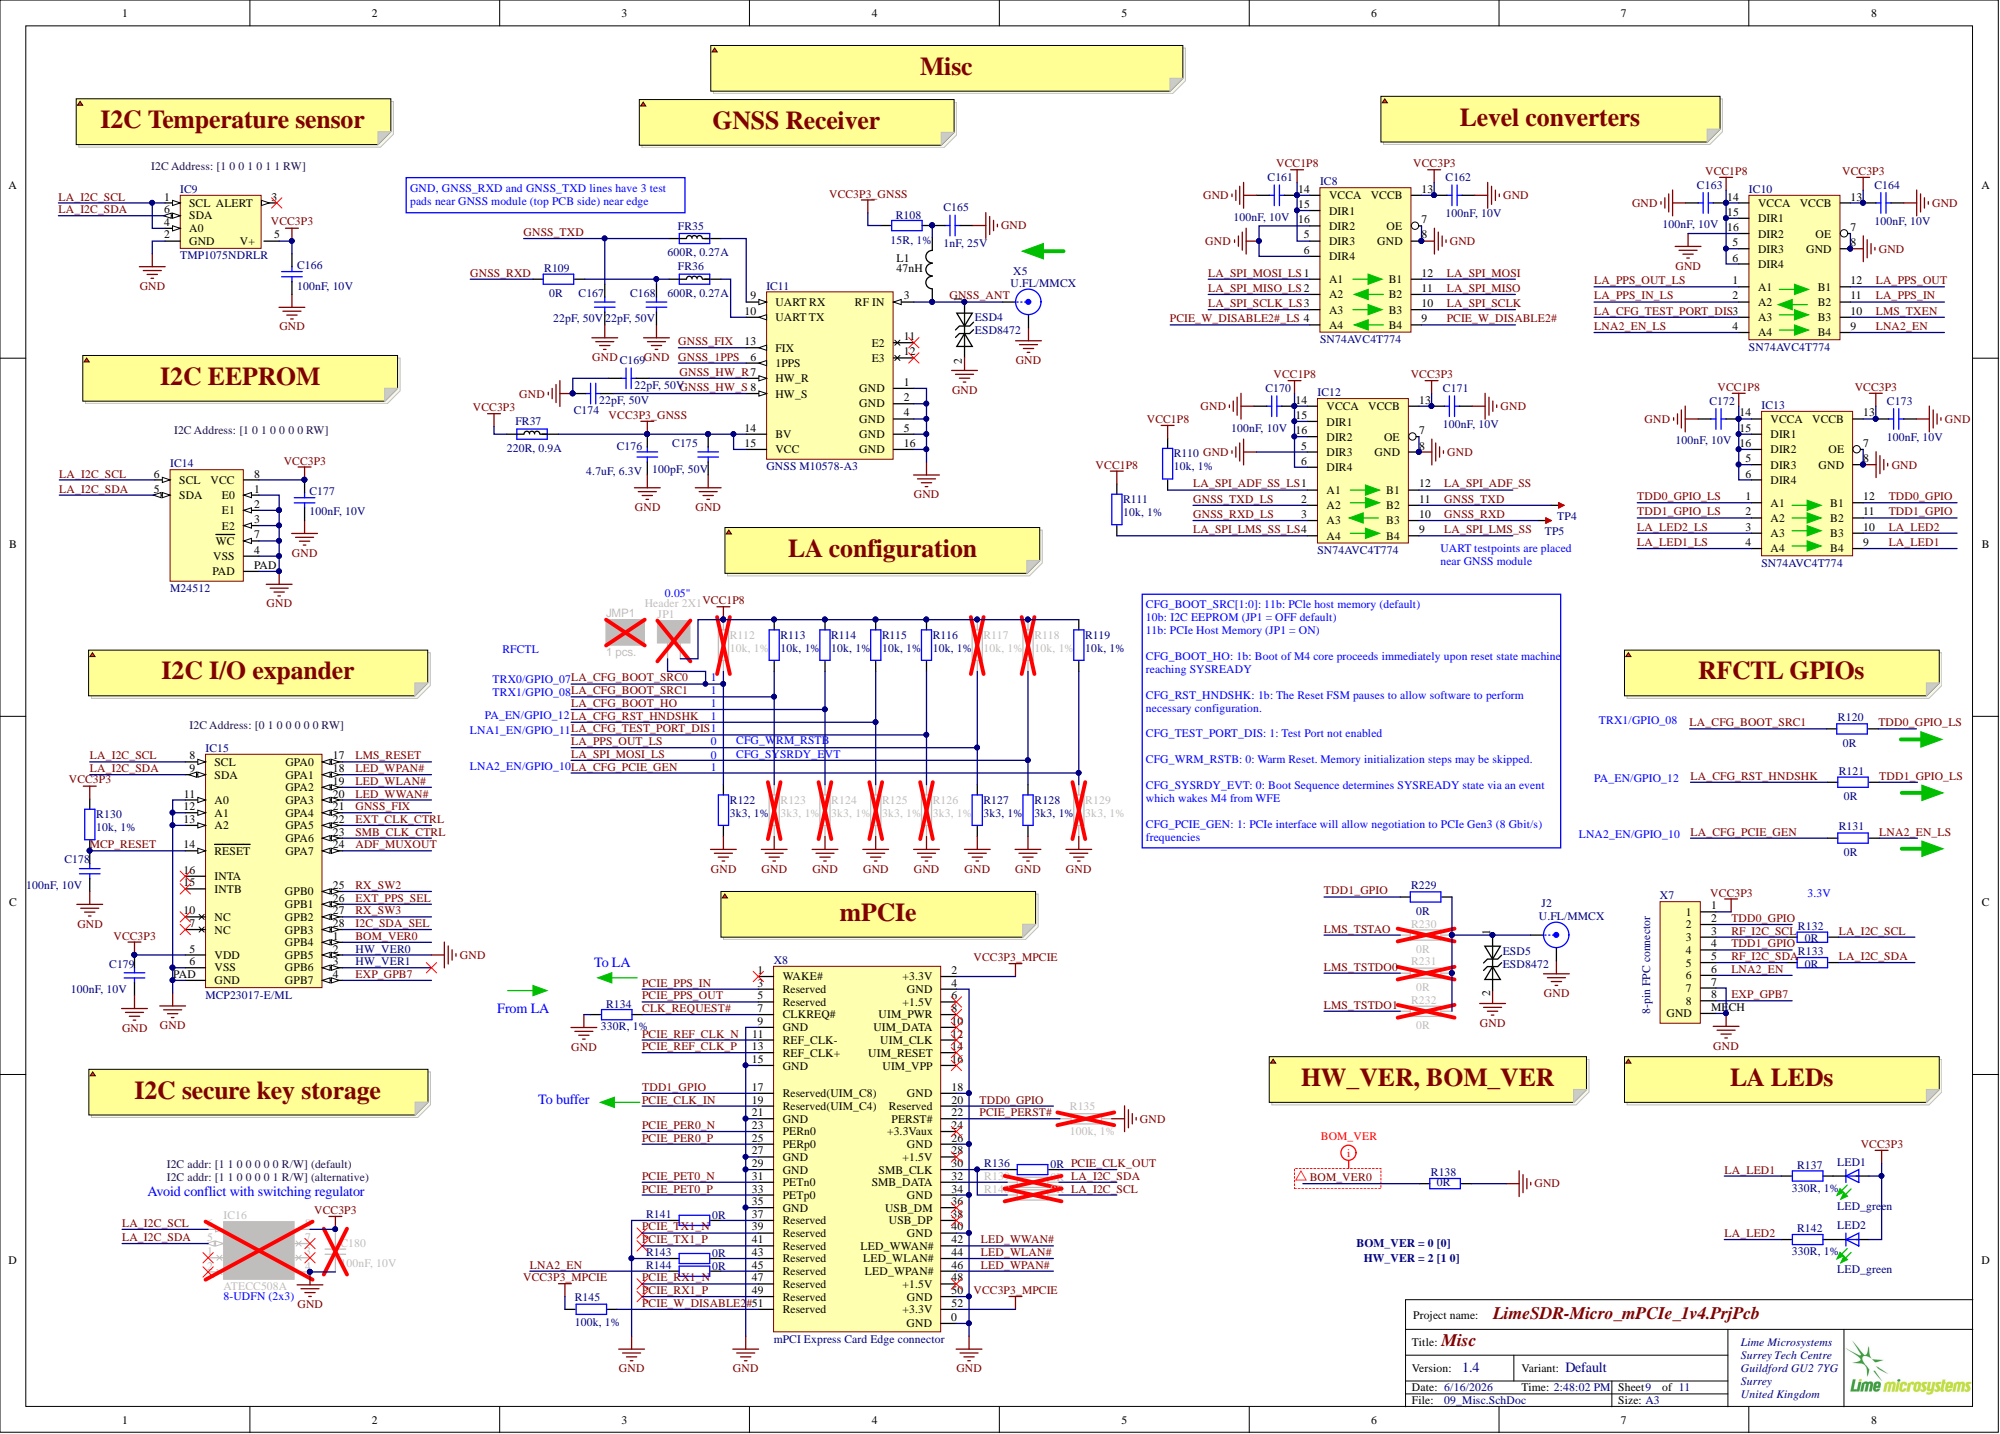
[picture p9: page 9]

GND, GNSS_RXD and GNSS_TXD lines have 3 test
pads near GNSS module (top PCB side) near edge

DIR1 15
DIR2 16
DIR3 5

UART testpoints are placed
near GNSS module

CFG_BOOT_SRC[1:0]: 11b: PCle host memory (default)
10b: I2C EEPROM (JP1 = OFF default)
11b: PCIe Host Memory (JP1 = ON)

CFG_BOOT_HO: 1b: Boot of M4 core proceeds immediately upon reset state machine
reaching SYSREADY

CFG_RST_HNDSHK: 1b: The Reset FSM pauses to allow software to perform
necessary configuration.

CFG_TEST_PORT_DIS: 1: Test Port not enabled

CFG_WRM_RSTB: 0: Warm Reset. Memory initialization steps may be skipped.

CFG_SYSRDY_EVT: 0: Boot Sequence determines SYSREADY state via an event
which wakes M4 from WFE

A1 12
A2 13

CFG_PCIE_GEN: 1: PCIe interface will allow negotiation to PCIe Gen3 (8 Gbit/s)
frequencies

RESET 14

INTB 15 INTA 16

I2C addr: [1 1 0 0 0 0 0 R/W] (default)
I2C addr: [1 1 0 0 0 0 1 R/W] (alternative)
Avoid conflict with switching regulator

mPCI Express Card Edge connector

6/16/2026 2:48:02 PM
09_Misc.SchDoc

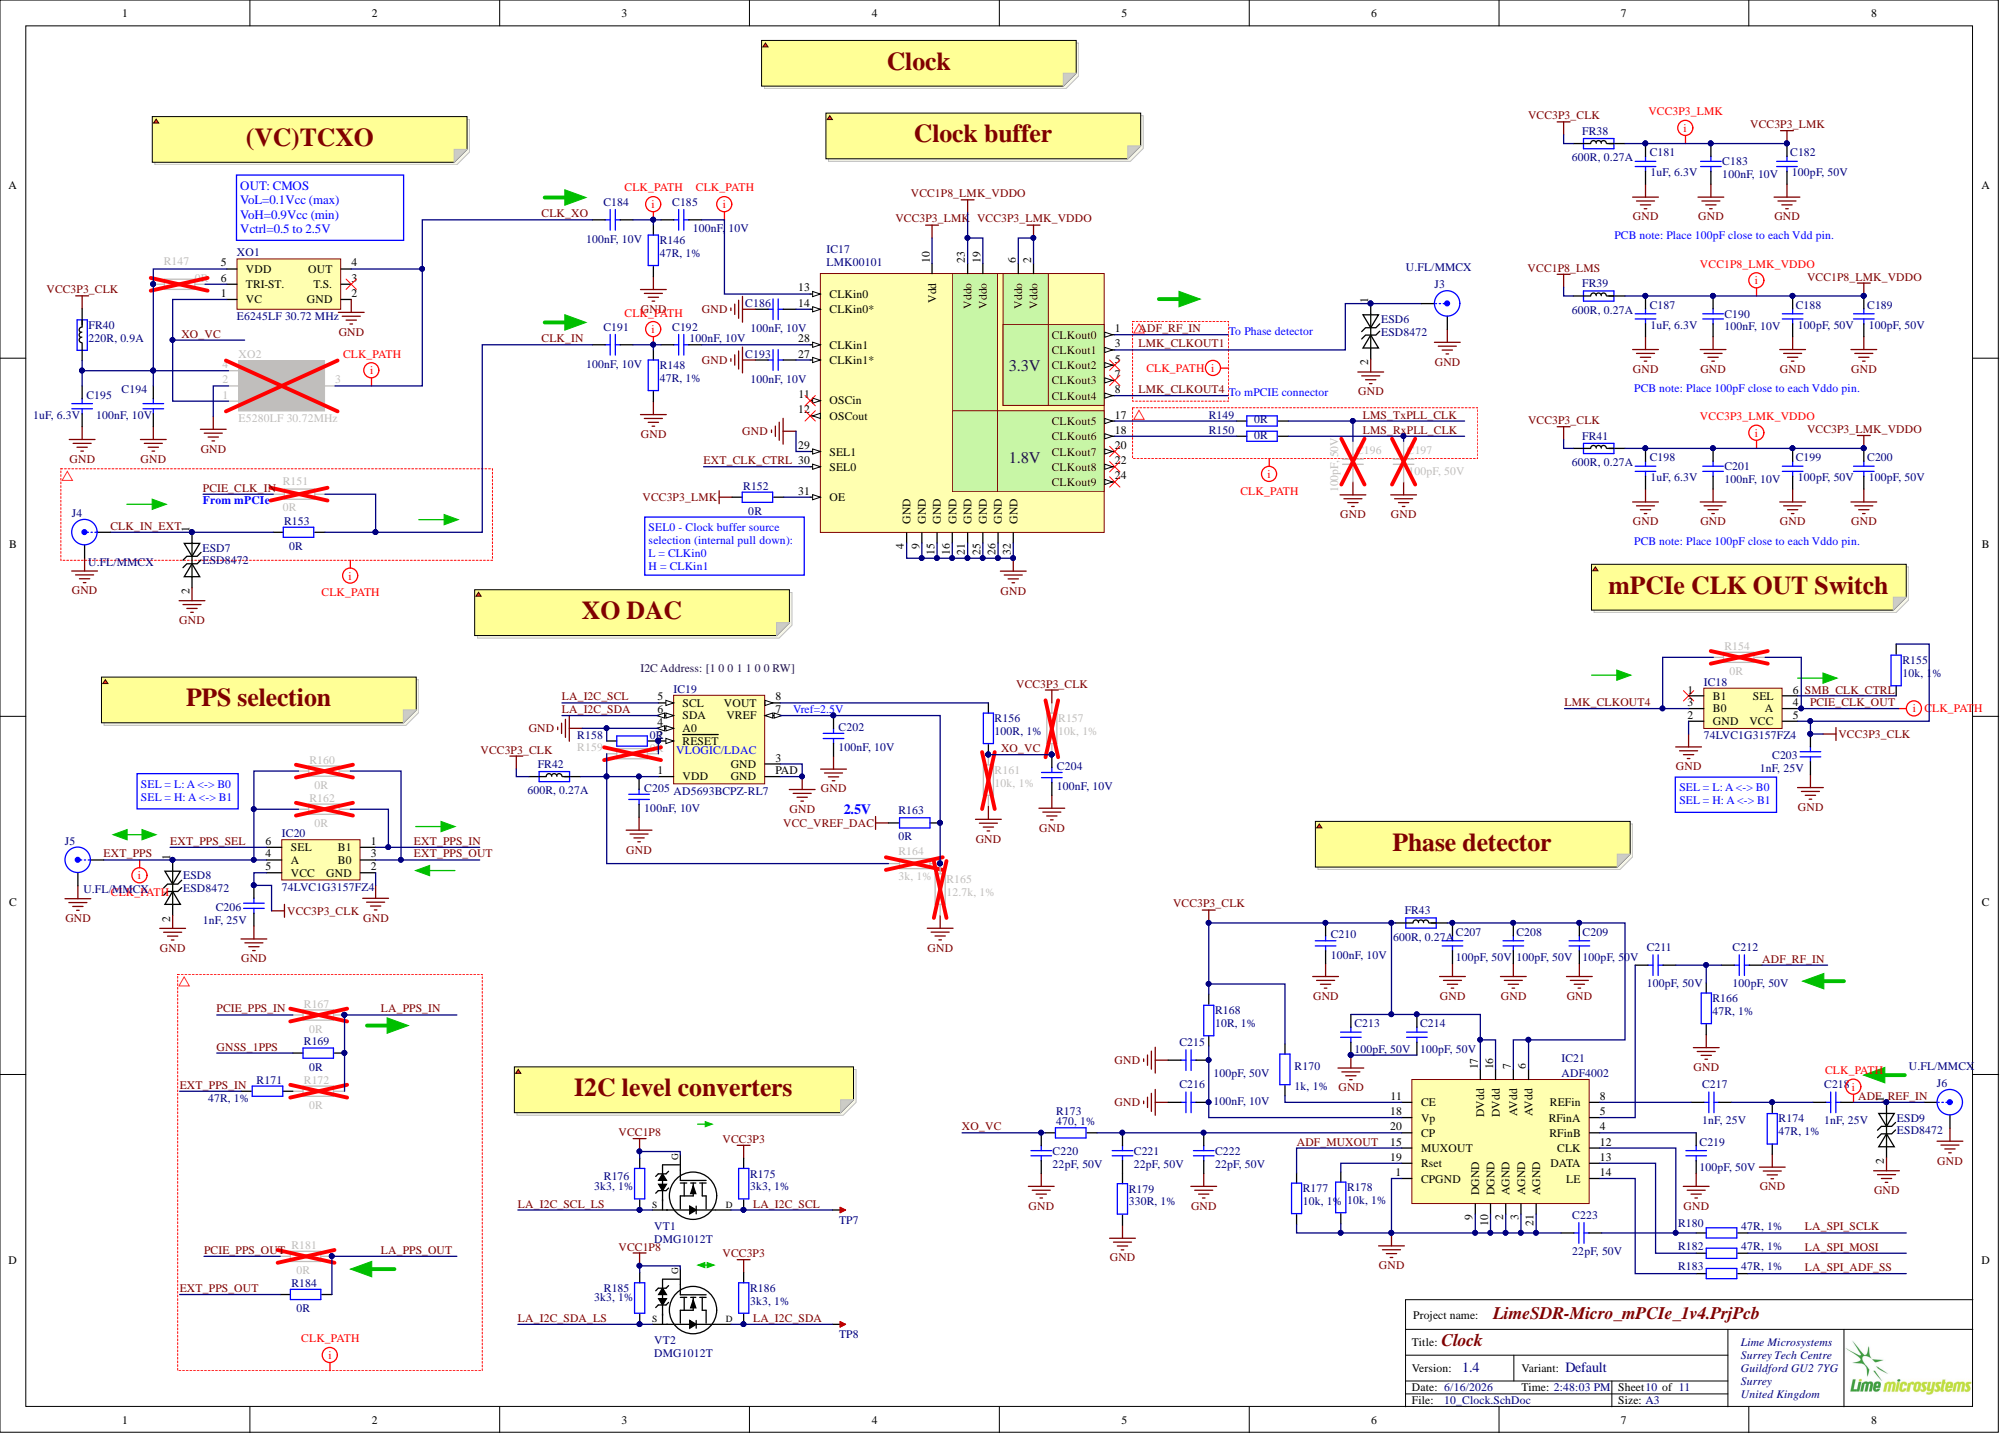
[picture p10: page 10]

PCB note: Place 100pF close to each Vdd pin.

C193 | CLKin1* 27

LMK_CLKOUT1

3.3V | CLKout2 CLKout3

5 7 | CLK_PATH i

PCB note: Place 100pF close to each Vddo pin.

mPCIe CLK OUT Switch

AVdd 6 AVdd 7 DVdd 16 DVdd 17

6/16/2026 2:48:03 PM
10_Clock.SchDoc

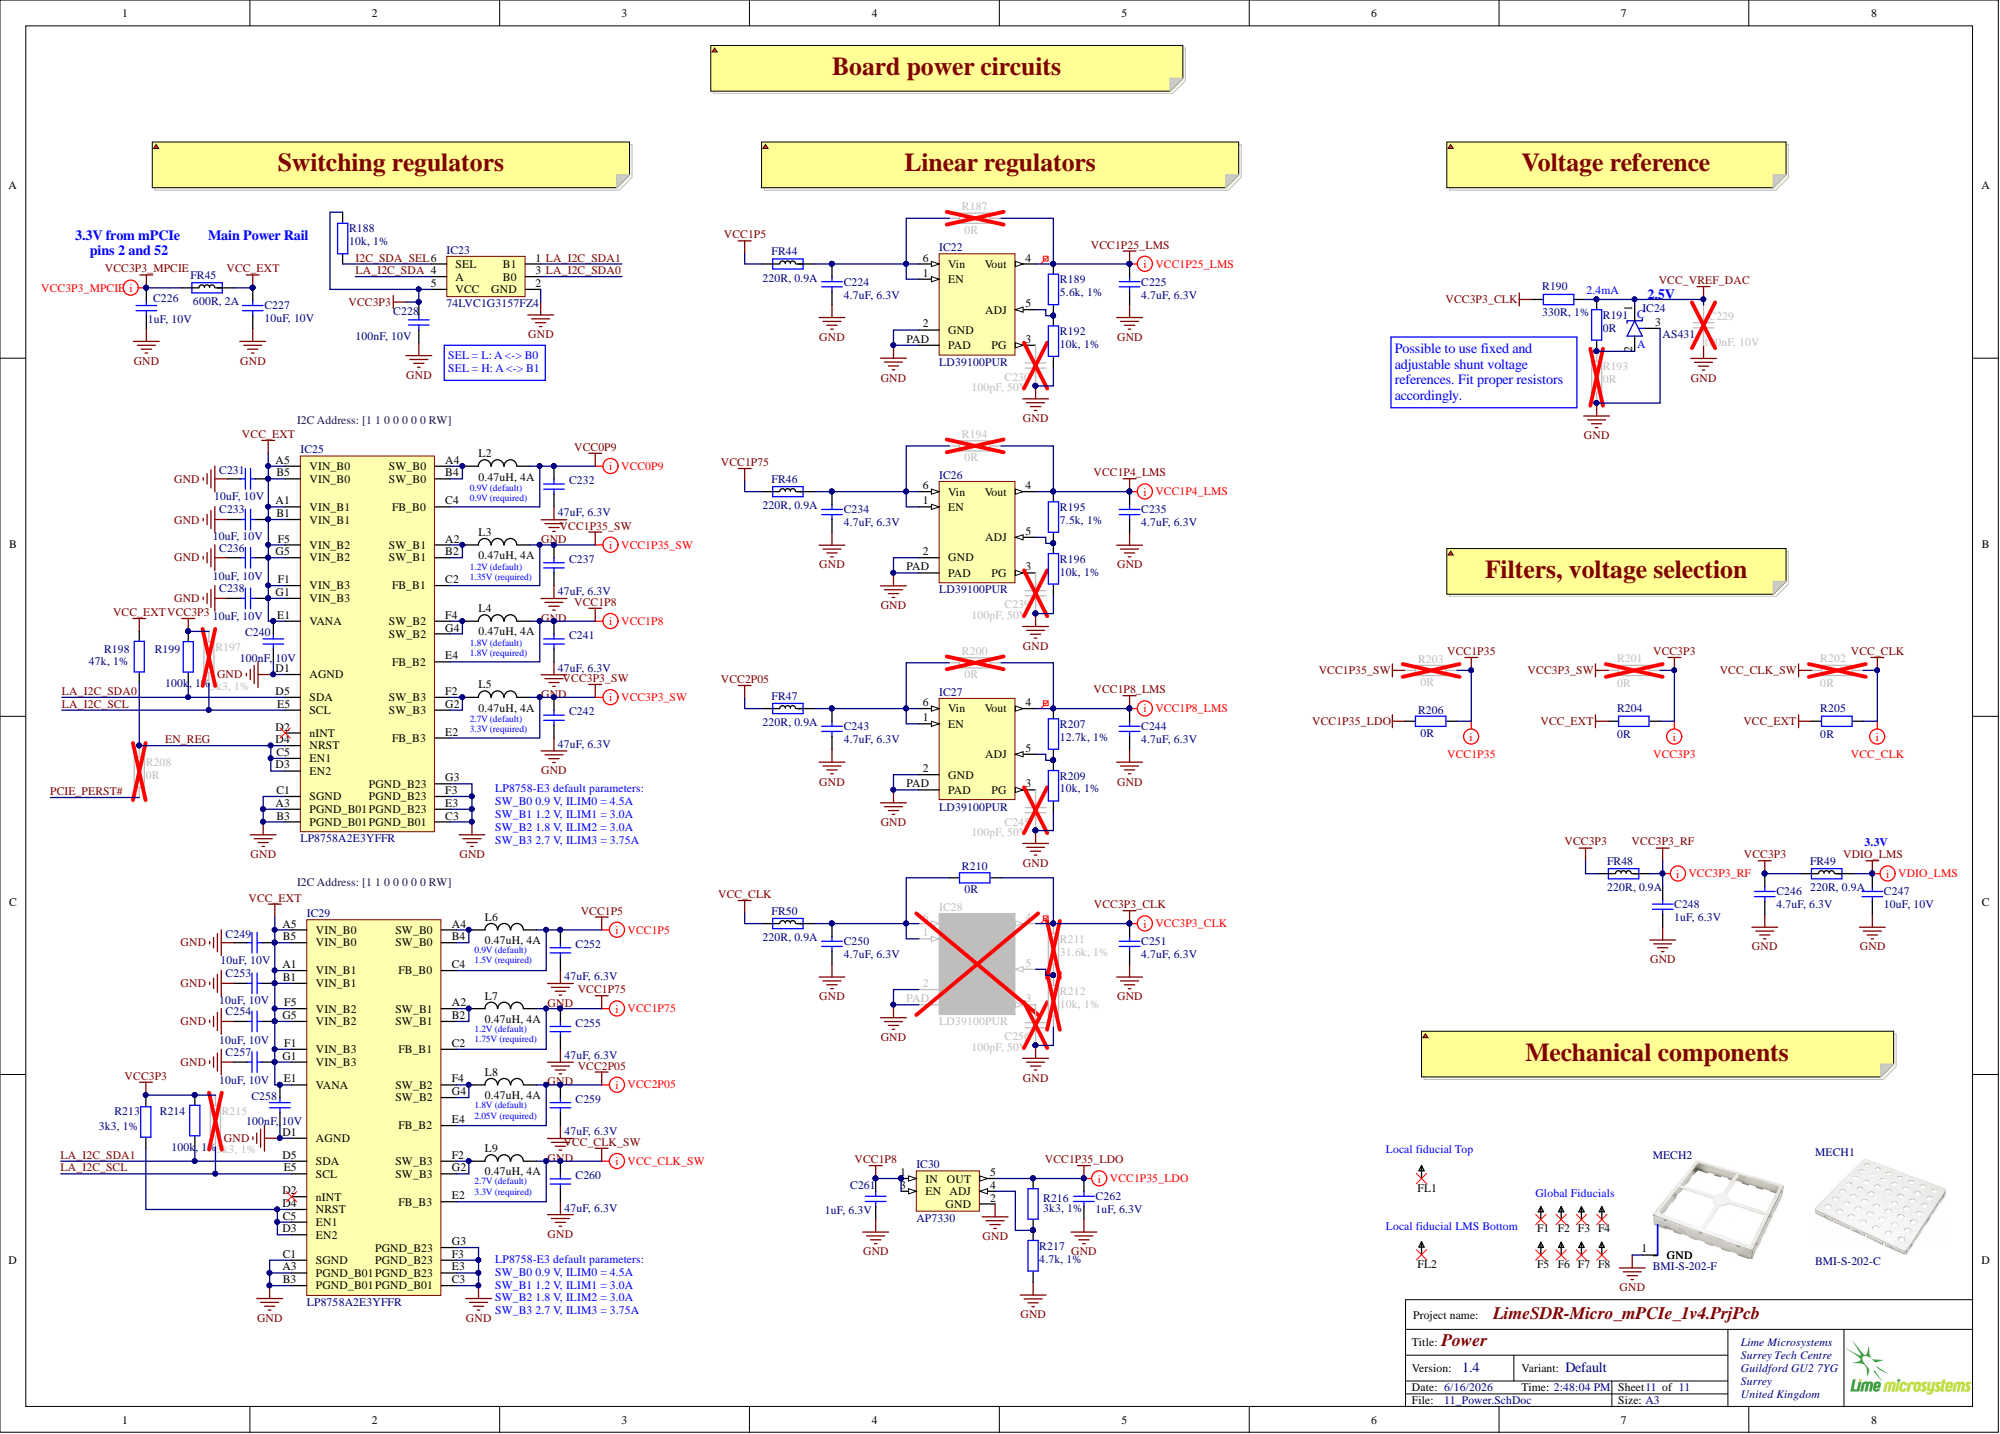
[picture p11: page 11]

ossible to use fix
djustable sh

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

Vers o n : 1.4 | Varian t : D efa ult

T ime: : : 4 PM | Sheet o f

Fi le: _Po wer.Sch D o c | Size: A
