myriadrf/LimeSDR-Micro/hardware/M.2/1v2/Project Outputs for LimeSDR-Micro_M.2_2280_1v2/LimeSDR-Micro_M.2_2280_1v2_Assembly_Drawings_r0.PDF

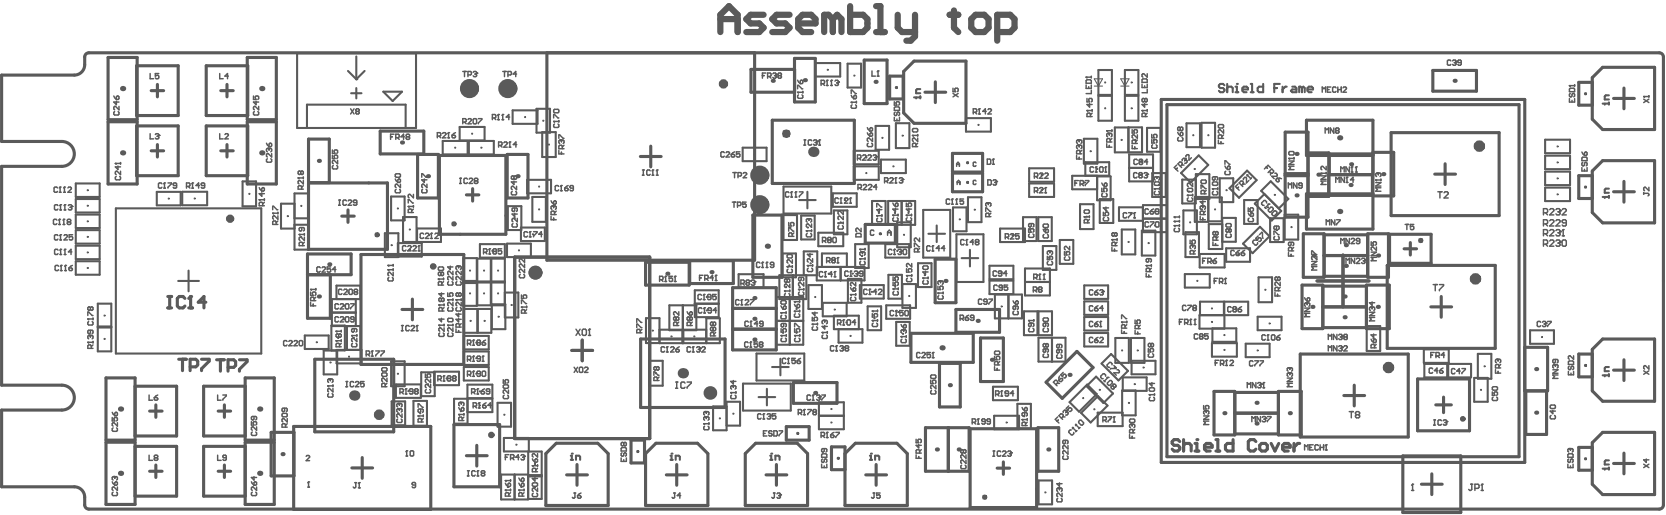
[picture p12: page 1]

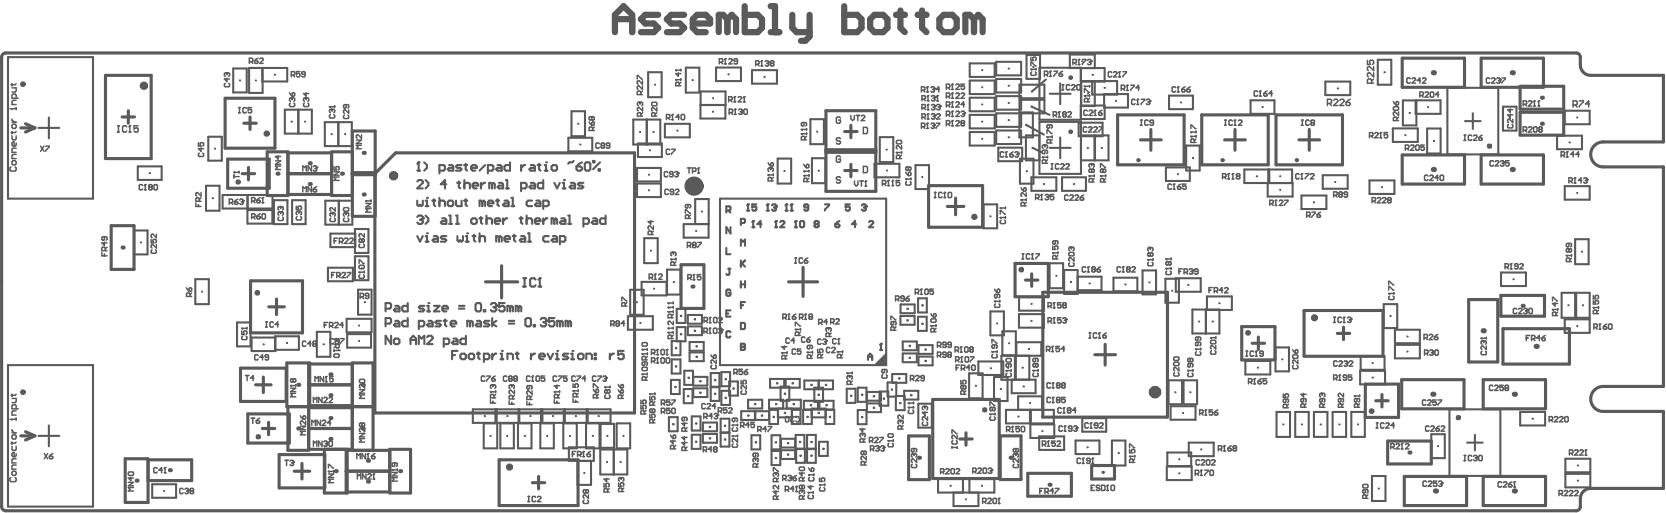
[picture p13: page 2]
