myriadrf/LimeSDR-Micro/hardware/mPCIe/1v3/LimeSDR-Micro_mPCIe_1v3_DB_DFMr1/LimeSDR-Micro_mPCIe_1v3_Assembly_Drawings_r1.PDF

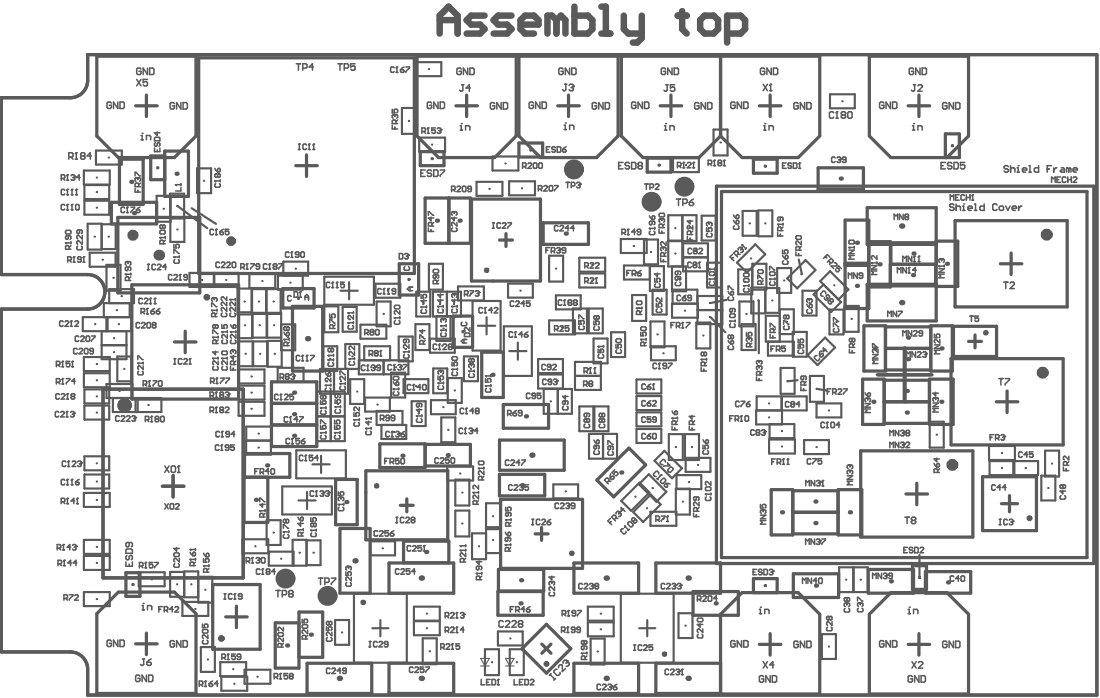
[picture p14: page 1]

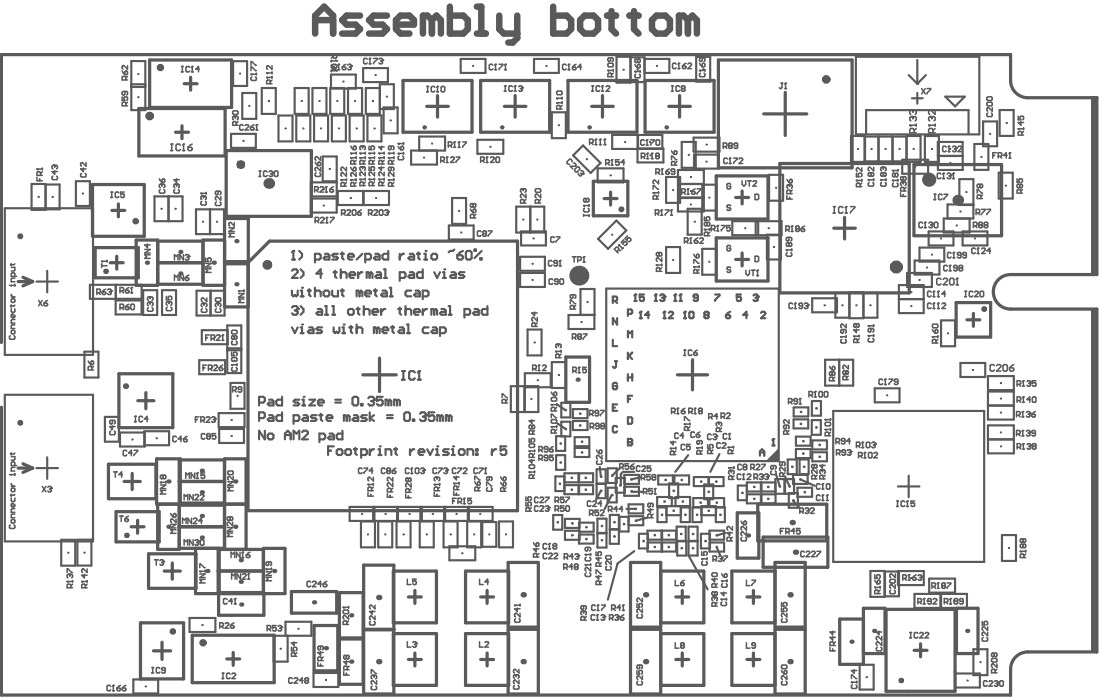
[picture p15: page 2]
