myriadrf/LimeSDR-Micro/hardware/M.2/1v0/LimeSDR-Micro_M.2_2280_1v0_DB_DFMr3/LimeSDR-Micro_M.2_2280_1v0_Assembly_Drawings_r3.PDF

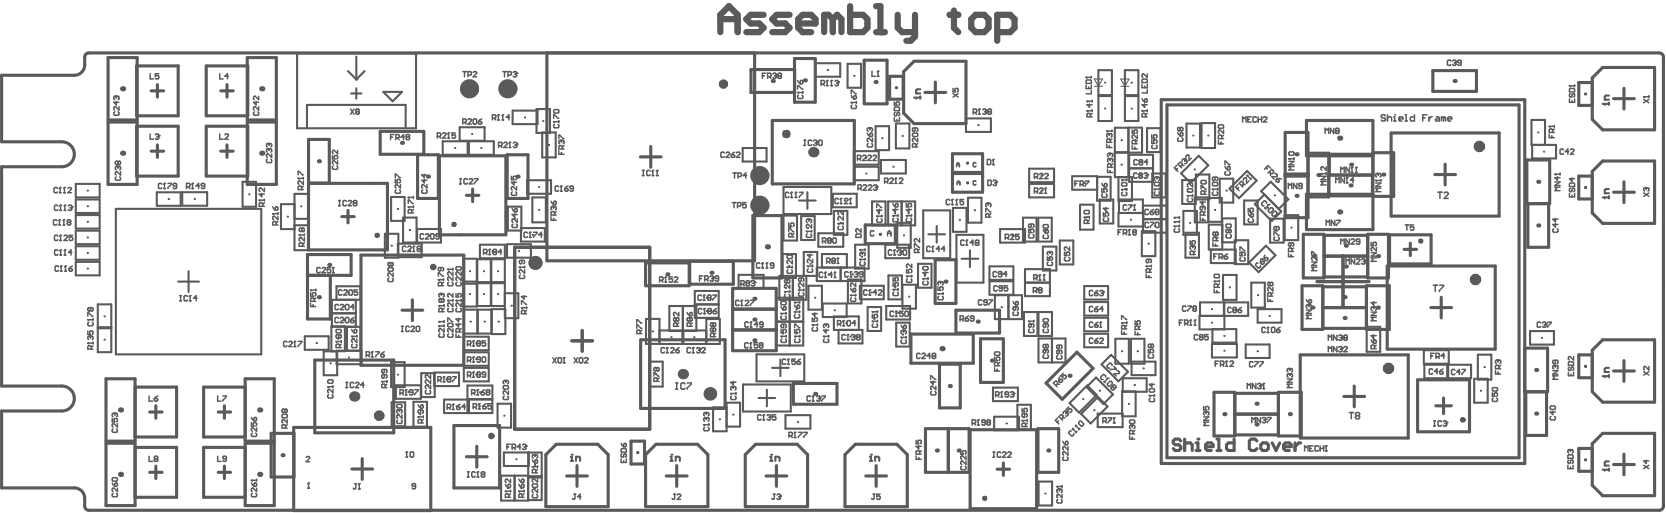
[picture p16: page 1]

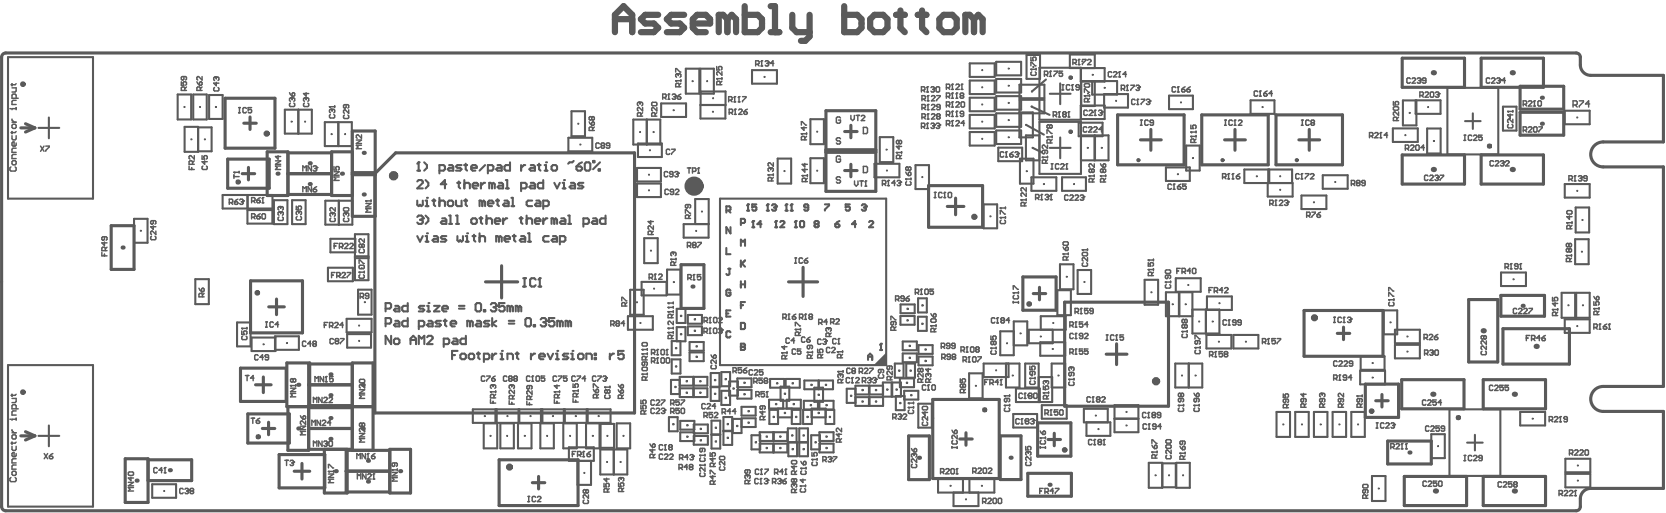
[picture p17: page 2]
