myriadrf/LimeSDR-Micro/hardware/mPCIe/1v2/Project Outputs for LimeSDR-Micro_1v2/LimeSDR-Micro_1v2_Assembly_Drawings_r0.PDF

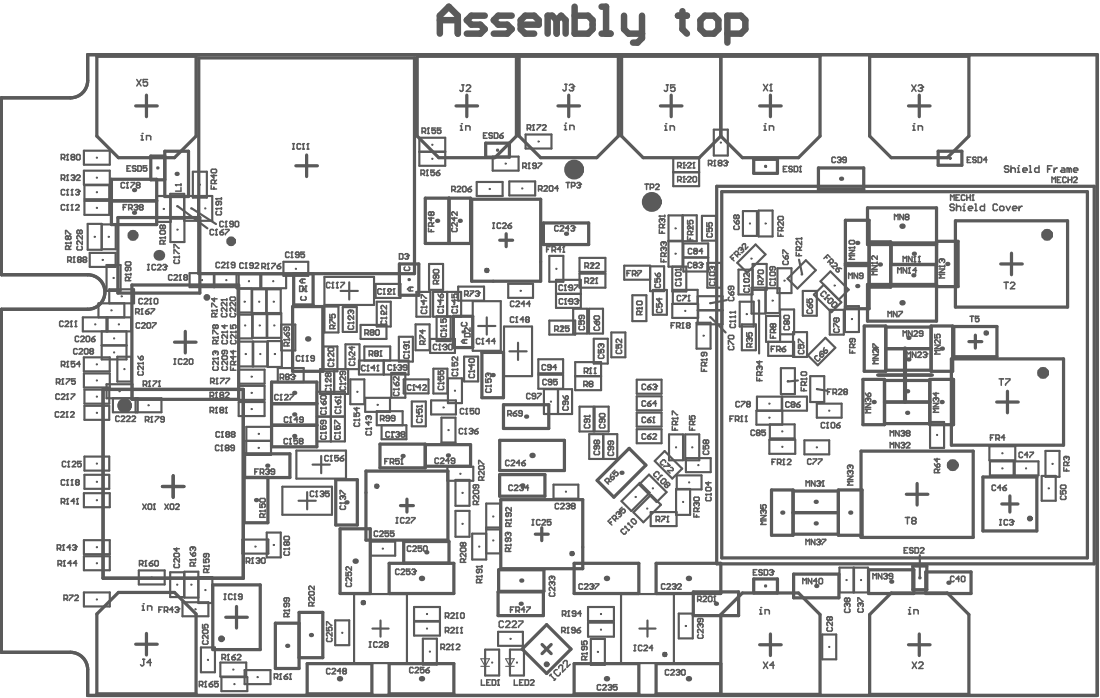
[picture p18: page 1]

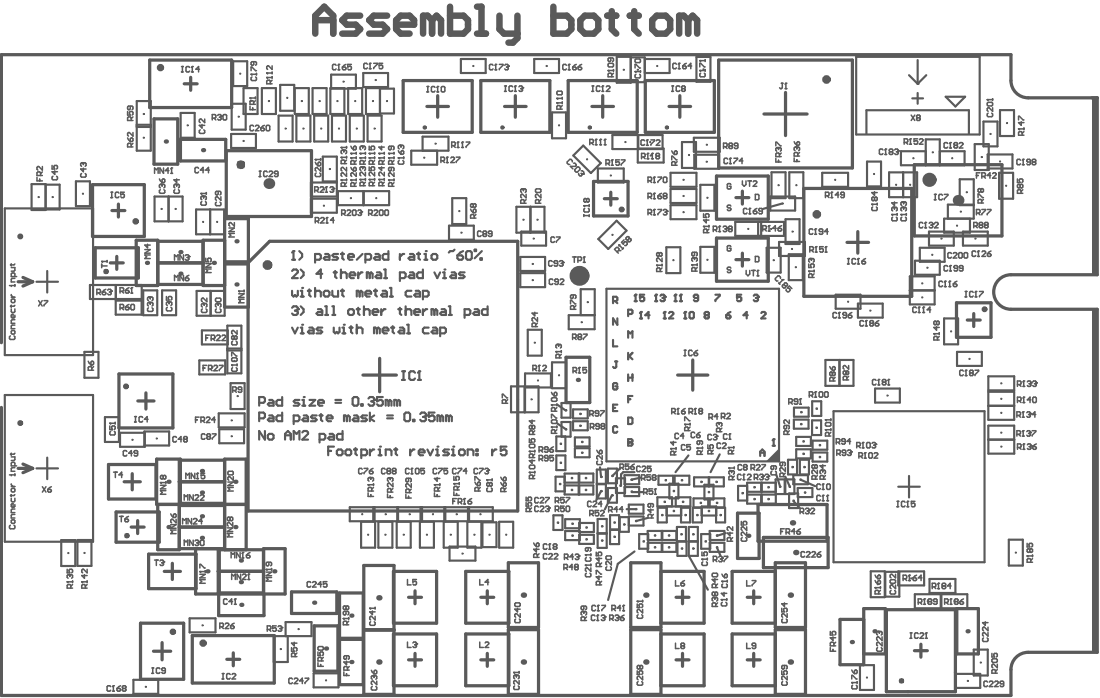
[picture p19: page 2]
