myriadrf/LimeSDR-Micro/hardware/mPCIe/1v1/Project Outputs for LimeSDR-Micro_1v1/LimeSDR-Micro_1v1_Assembly_Drawings_r0.PDF

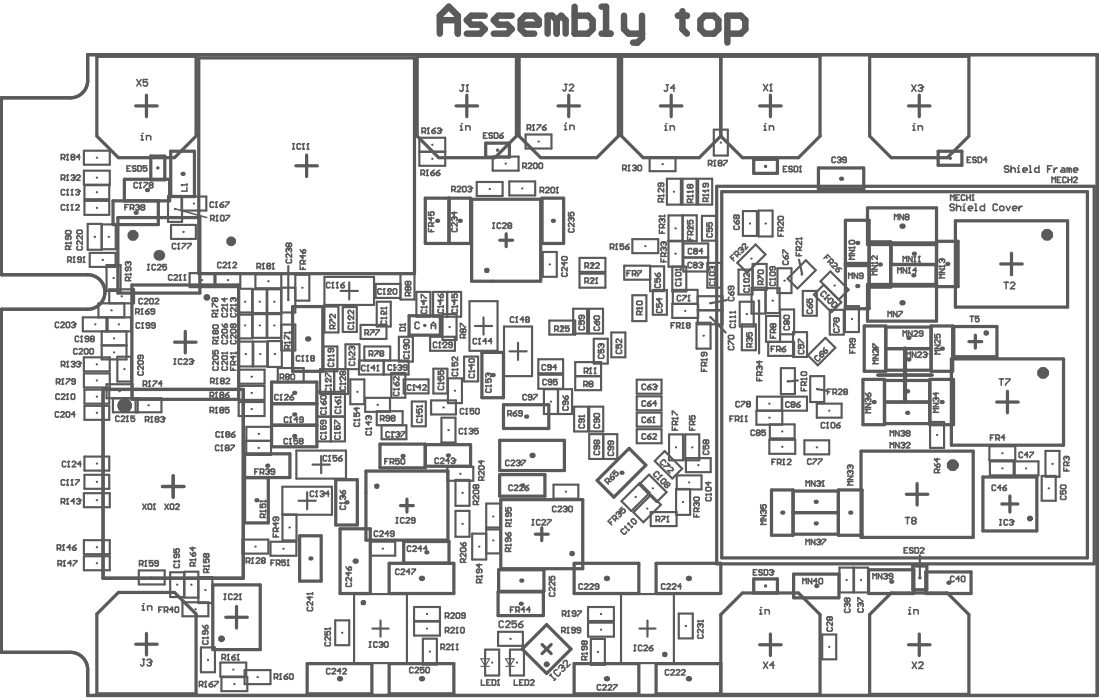
[picture p20: page 1]

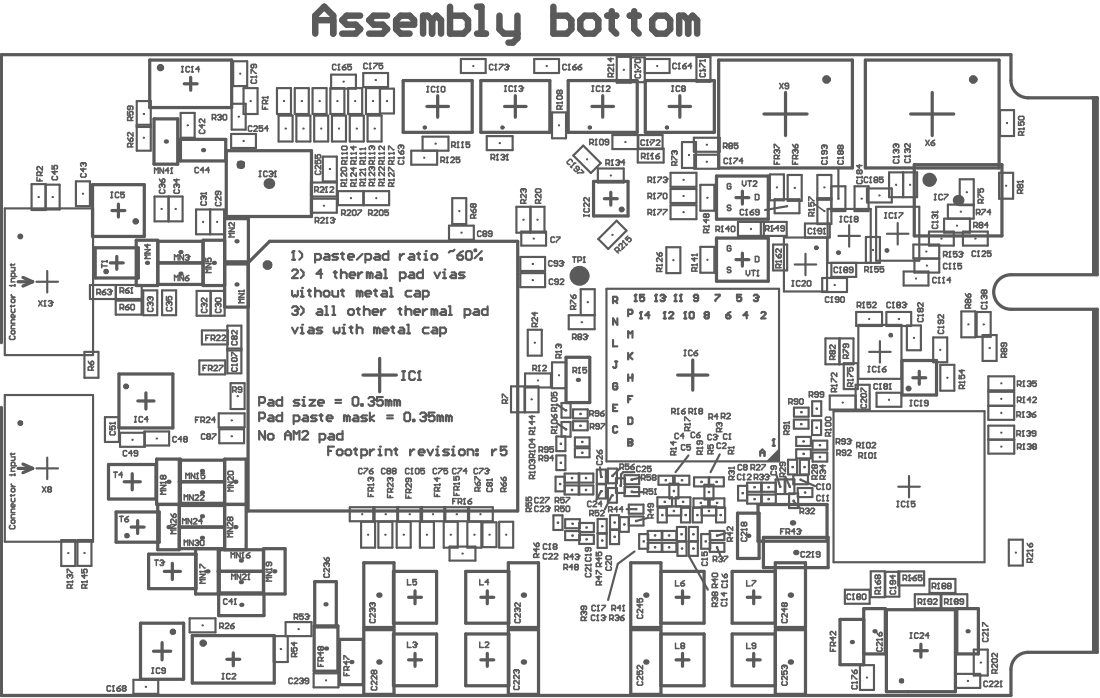
[picture p21: page 2]
