myriadrf/LimeSDR-Micro/hardware/mPCIe/1v1/Project Outputs for LimeSDR-Micro_1v1/LimeSDR-Micro_1v1_PCB3D_flat_r0.PDF

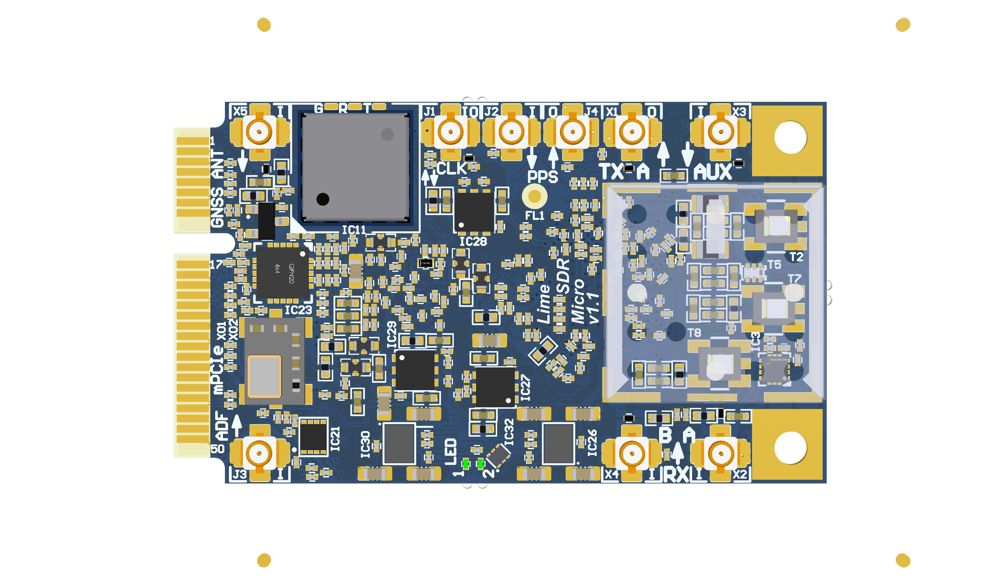
[picture p22: page 1]

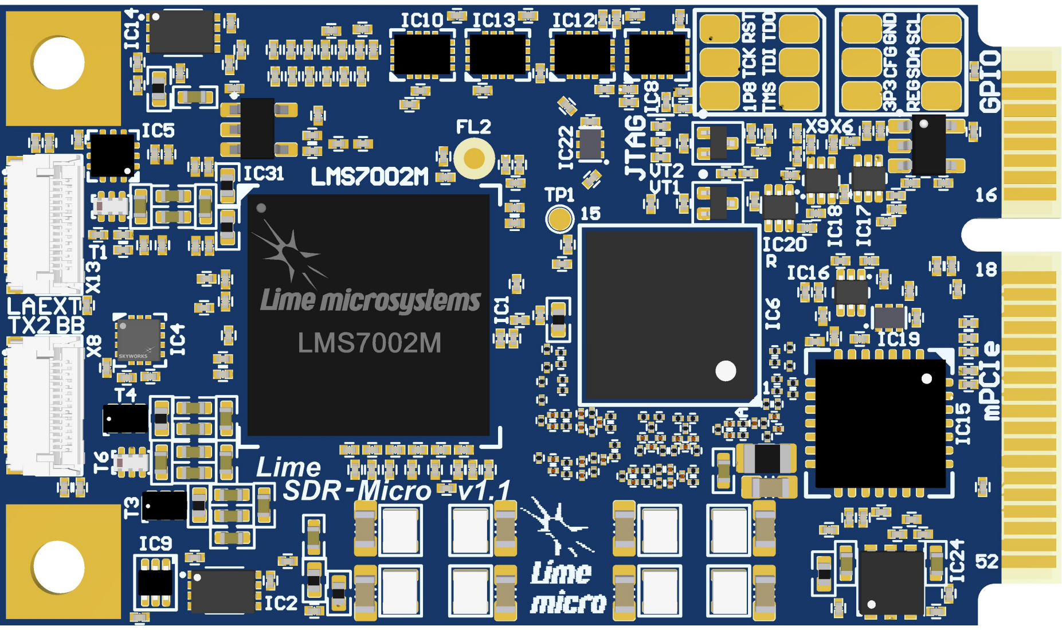
[picture p23: page 2]
