myriadrf/LimeSDR-Micro/hardware/mPCIe/1v0/LimeSDR-Micro_1v0_DB_DFMr1/LimeSDR-Micro_1v0_Assembly_Drawings_r1.PDF

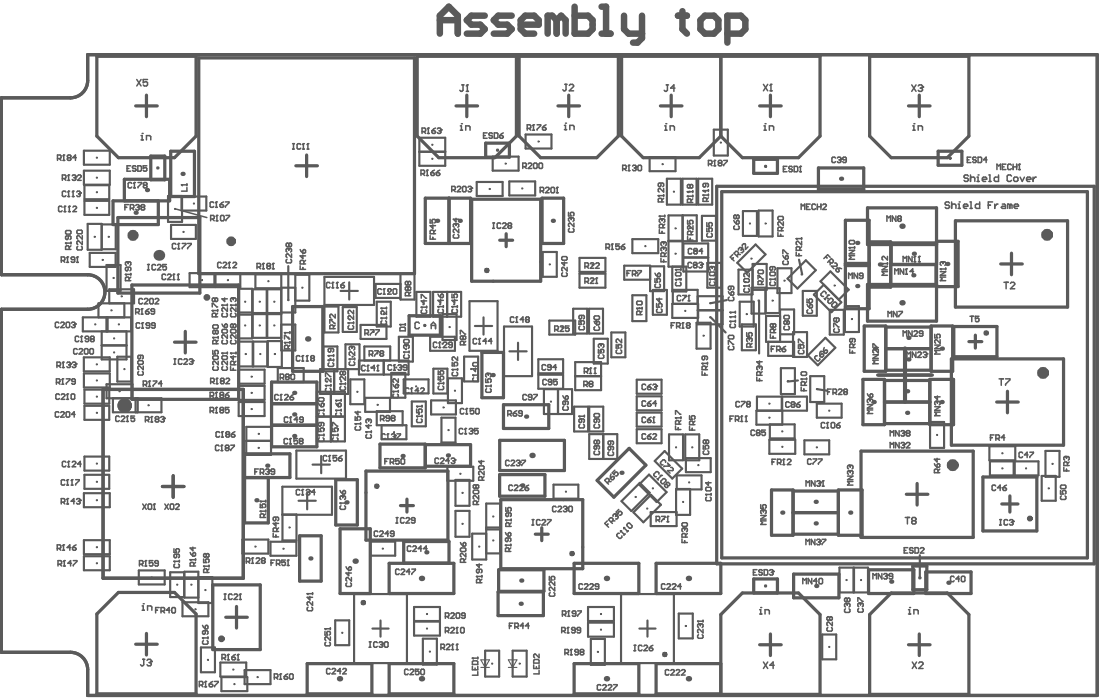
[picture p24: page 1]

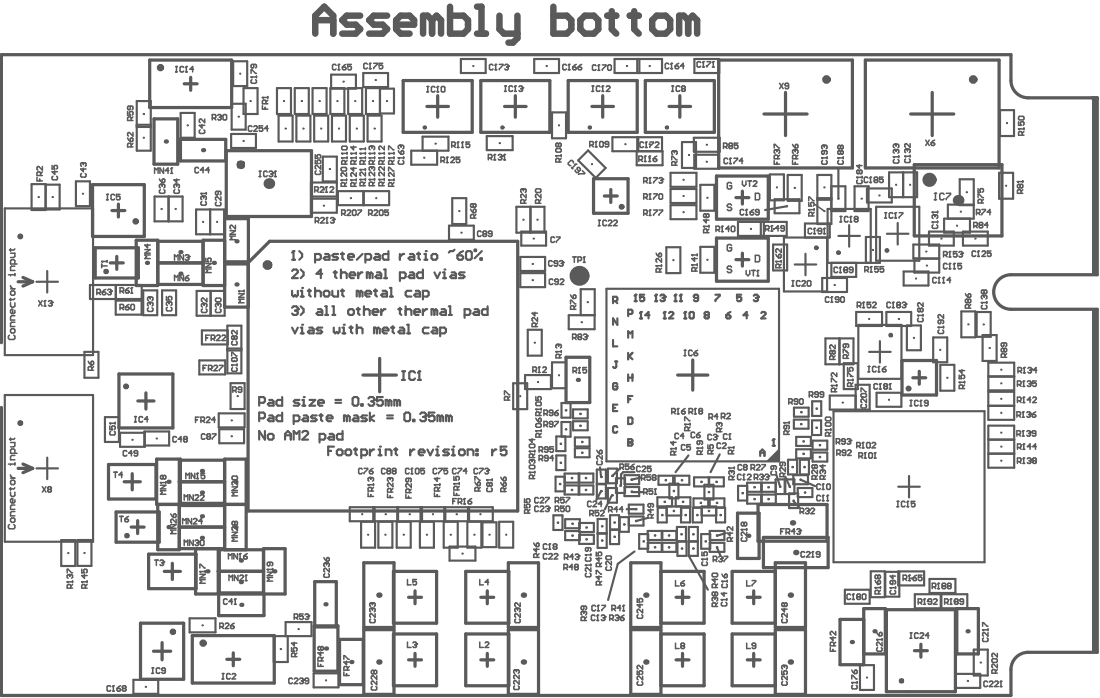
[picture p25: page 2]
