myriadrf/LimeSDR-Micro/(list of files, drawings)

Other design files:
hardware/1v0/Schematics/10_Misc.SchDoc
hardware/M.2/1v0/LimeSDR-Micro_M.2_2280_1v0.PrjPcb
hardware/M.2/1v1/LimeSDR-Micro_M.2_2280_1v1.PrjPcb
hardware/M.2/1v2/LimeSDR-Micro_M.2_2280_1v2.PrjPcb
hardware/M.2/1v2/Schematics/01_Block_Diagram.SchDoc
hardware/M.2/1v2/Schematics/02_Power_Diagram.SchDoc
hardware/M.2/1v2/Schematics/03_Clock_Diagram.SchDoc
hardware/M.2/1v2/Schematics/04_RF_Diagram.SchDoc
hardware/M.2/1v2/Schematics/05_LMS7002M_Misc.SchDoc
hardware/M.2/1v2/Schematics/06_LMS7002M_RF.SchDoc
hardware/M.2/1v2/Schematics/07_LMS7002M_Power.SchDoc
hardware/M.2/1v2/Schematics/08_BB_Processor.SchDoc
hardware/M.2/1v2/Schematics/09_Misc.SchDoc
hardware/M.2/1v2/Schematics/10_Clock.SchDoc
hardware/M.2/1v2/Schematics/11_Power.SchDoc
hardware/mPCIe/1v0/LimeSDR-Micro_1v0.PrjPcb
hardware/mPCIe/1v0/Schematics/01_Block_Diagram.SchDoc
hardware/mPCIe/1v0/Schematics/02_Power_Diagram.SchDoc
hardware/mPCIe/1v0/Schematics/03_Clock_Diagram.SchDoc
hardware/mPCIe/1v0/Schematics/04_RF_Diagram.SchDoc
hardware/mPCIe/1v0/Schematics/05_LMS7002M_Misc.SchDoc
hardware/mPCIe/1v0/Schematics/06_LMS7002M_RF.SchDoc
hardware/mPCIe/1v0/Schematics/07_LMS7002M_Power.SchDoc
hardware/mPCIe/1v0/Schematics/08_BB_Processor.SchDoc
hardware/mPCIe/1v0/Schematics/09_Misc.SchDoc
hardware/mPCIe/1v0/Schematics/10_Clock.SchDoc
hardware/mPCIe/1v0/Schematics/11_Power.SchDoc
hardware/mPCIe/1v1/LimeSDR-Micro_1v1.PrjPcb
hardware/mPCIe/1v1/Schematics/01_Block_Diagram.SchDoc
hardware/mPCIe/1v1/Schematics/02_Power_Diagram.SchDoc
hardware/mPCIe/1v1/Schematics/03_Clock_Diagram.SchDoc
hardware/mPCIe/1v1/Schematics/04_RF_Diagram.SchDoc
hardware/mPCIe/1v1/Schematics/05_LMS7002M_Misc.SchDoc
hardware/mPCIe/1v1/Schematics/06_LMS7002M_RF.SchDoc
hardware/mPCIe/1v1/Schematics/07_LMS7002M_Power.SchDoc
hardware/mPCIe/1v1/Schematics/08_BB_Processor.SchDoc
hardware/mPCIe/1v1/Schematics/09_Misc.SchDoc
hardware/mPCIe/1v1/Schematics/10_Clock.SchDoc
hardware/mPCIe/1v1/Schematics/11_Power.SchDoc
hardware/mPCIe/1v2/LimeSDR-Micro_1v2.PrjPcb
hardware/mPCIe/1v3/LimeSDR-Micro_mPCIe_1v3.PrjPcb
hardware/mPCIe/1v4/LimeSDR-Micro_mPCIe_1v4.PrjPcb
hardware/mPCIe/1v4/PCB/LimeSDR-Micro_mPCIe_1v4.PcbDoc
hardware/mPCIe/1v4/Schematics/01_Block_Diagram.SchDoc
hardware/mPCIe/1v4/Schematics/02_Power_Diagram.SchDoc
hardware/mPCIe/1v4/Schematics/03_Clock_Diagram.SchDoc
hardware/mPCIe/1v4/Schematics/04_RF_Diagram.SchDoc
hardware/mPCIe/1v4/Schematics/05_LMS7002M_Misc.SchDoc
hardware/mPCIe/1v4/Schematics/06_LMS7002M_RF.SchDoc
hardware/mPCIe/1v4/Schematics/07_LMS7002M_Power.SchDoc
hardware/mPCIe/1v4/Schematics/08_BB_Processor.SchDoc
hardware/mPCIe/1v4/Schematics/09_Misc.SchDoc
hardware/mPCIe/1v4/Schematics/10_Clock.SchDoc
hardware/mPCIe/1v4/Schematics/11_Power.SchDoc
