myriadrf/LimeSDR-Micro/(commit log)

2023-09-11 Initial Altium project commit (based on LimeSDR-XTRX 1v1)
    [01_Block_Diagram.SchDoc, 02_Power_Diagram.SchDoc, 03_Clock_Diagram.SchDoc, 04_RF_Diagram.SchDoc, 05_LMS7002M_Misc.SchDoc, 06_LMS7002M_RF.SchDoc, 07_LMS7002M_Power.SchDoc, 08_FPGA.SchDoc]
2023-09-12 Diagrams that do not match the schematic are marked
    [01_Block_Diagram.SchDoc, 02_Power_Diagram.SchDoc, 03_Clock_Diagram.SchDoc, 04_RF_Diagram.SchDoc]
2023-09-12 Added temporary schematic files
    [11_Temp1.SchDoc, 12_Temp2.SchDoc, LimeSDR-Micro_1v0.PrjPcb]
2023-09-12 Added LA9310
    [11_Temp1.SchDoc, LimeSDR-Micro_1v0.PrjPcb]
2023-09-13 Connected GNDs
    [11_Temp1.SchDoc]
2023-09-13 Disconnected LMS LimeLight interface
    [05_LMS7002M_Misc.SchDoc]
2023-09-13 Marked questionable blocks
    [06_LMS7002M_RF.SchDoc]
2023-09-13 Added supply pins voltages, currents information
    [11_Temp1.SchDoc]
2023-09-13 Connecting LA power
    [11_Temp1.SchDoc]
2023-09-14 Added NC symbols
    [05_LMS7002M_Misc.SchDoc]
2023-09-18 MISO note
    [04_RF_Diagram.SchDoc]
2023-09-18 Added PCB file
    [LimeSDR-Micro_1v0.PrjPcb]
2023-09-18 Connected PCIe
    [11_Temp1.SchDoc]
2023-09-18 Connected pcie calibration resistors
    [11_Temp1.SchDoc]
2023-09-19 Added XOs, ADF and LVDS driver
    [12_Temp2.SchDoc]
2023-09-19 Added MCLK1 note
    [05_LMS7002M_Misc.SchDoc]
2023-09-19 DCLK info
    [11_Temp1.SchDoc]
2023-09-19 Connected LMS_MCLK1 to LA_DCLK
    [05_LMS7002M_Misc.SchDoc, 11_Temp1.SchDoc, 12_Temp2.SchDoc]
2023-09-21 Connecting clok
    [12_Temp2.SchDoc]
2023-09-21 Added libraries
    [LimeSDR-Micro_1v0.PrjPcb]
2023-09-21 Connected LA_PPS_IN and LA_PPS_OUT
    [11_Temp1.SchDoc]
2023-09-21 Connected PCIE_PPS_IN and PCIE_PPS_OUT
    [09_Misc.SchDoc]
2023-09-21 Connected PPS_IN ans PPS_OUT to other circuits
    [12_Temp2.SchDoc]
2023-09-25 Removed sim card interface
    [09_Misc.SchDoc]
2023-09-25 NC for mPCIe SIM card pins
    [09_Misc.SchDoc]
2023-09-25 Marked questionable areas
    [09_Misc.SchDoc]
2023-09-25 Connected LA I2C and added EEPROM
    [11_Temp1.SchDoc]
2023-09-26 Removed USB tranceiver
    [09_Misc.SchDoc]
2023-09-26 Moved USB connector
    [09_Misc.SchDoc]
2023-09-26 Connected LMS SPI
    [05_LMS7002M_Misc.SchDoc]
2023-09-26 Connected LA SPI
    [11_Temp1.SchDoc]
2023-09-26 Connecting LA pins
    [11_Temp1.SchDoc]
2023-09-27 Connected ADF SPI
    [11_Temp1.SchDoc, 12_Temp2.SchDoc]
2023-09-27 Connected LMS BB
    [05_LMS7002M_Misc.SchDoc]
2023-09-27 Connected LMS BB TX to LA DAC
    [05_LMS7002M_Misc.SchDoc, 11_Temp1.SchDoc]
2023-09-28 Moved FPC connectors
    [05_LMS7002M_Misc.SchDoc]
2023-09-28 Connected LA I2C to LMS
    [05_LMS7002M_Misc.SchDoc]
2023-09-28 Changed Remove regions
    [06_LMS7002M_RF.SchDoc]
2023-09-28 Added GPIOs nets
    [11_Temp1.SchDoc]
2023-09-28 OVDD 1.8V info
    [11_Temp1.SchDoc]
2023-09-28 Connected LA_I2C level converter 1.8V to 3.3V
    [11_Temp1.SchDoc, 12_Temp2.SchDoc]
2023-09-28 Renamed FPGA_LEDn to LA_LEDn
    [09_Misc.SchDoc]
2023-09-28 Connected JTAG
    [11_Temp1.SchDoc]
2023-10-04 Added RF swithes control voltages
    [06_LMS7002M_RF.SchDoc]
2023-10-04 Connecting GPIOs
    [11_Temp1.SchDoc]
2023-10-04 TX_DET NC
    [11_Temp1.SchDoc]
2023-10-04 NC and GND for Lightweight LVDS communication protocol (LLCP) interface
    [11_Temp1.SchDoc]
2023-10-04 Changed some ADF resistors from 0402 to 0201
    [12_Temp2.SchDoc]
2023-10-04 Added LA_CFGs
    [11_Temp1.SchDoc]
2023-10-05 Added new temp3 sheet
    [13_Temp3.SchDoc, LimeSDR-Micro_1v0.PrjPcb]
2023-10-05 Changed files order
    [LimeSDR-Micro_1v0.PrjPcb]
2023-10-05 Added _LS for LA nets
    [11_Temp1.SchDoc]
2023-10-05 Converter lines
    [13_Temp3.SchDoc]
2023-10-05 Disconnected second PCIE lane (TX1 and RX1)
    [09_Misc.SchDoc]
2023-10-05 Disconnected USB from mPCIE
    [09_Misc.SchDoc]
2023-10-05 Changed TX BB circuit
    [05_LMS7002M_Misc.SchDoc]
2023-10-05 Removed LMS TX2 circuit and prepared for HAM RX
    [06_LMS7002M_RF.SchDoc]
2023-10-05 Deleted some FPGA banks
    [08_FPGA.SchDoc]
2023-10-05 Changed I2C interface for XO DAC
    [12_Temp2.SchDoc]
2023-10-05 Removed old clock
    [09_Misc.SchDoc]
2023-10-05 Removedsome XOs, connected to buff
    [12_Temp2.SchDoc]
2023-10-05 Moced level convertes from temp2
    [13_Temp3.SchDoc]
2023-10-11 LMS VDIO note
    [10_Power.SchDoc]
2023-10-11 Port expander pins
    [13_Temp3.SchDoc]
2023-10-11 Moved pins
    [11_Temp1.SchDoc]
2023-10-11 Changed 10K to 0201 package
    [13_Temp3.SchDoc]
2023-10-11 Connected LA_I2C to temperature sensor
    [09_Misc.SchDoc]
2023-10-11 Removed config flash
    [09_Misc.SchDoc]
2023-10-11 Moved LA EEPROM
    [11_Temp1.SchDoc]
2023-10-11 Movel LA EEPROM
    [11_Temp1.SchDoc]
2023-10-11 Reconected VCC1P8
    [11_Temp1.SchDoc]
2023-10-11 LA EEPROM
    [09_Misc.SchDoc]
2023-10-11 EEPROM info
    [09_Misc.SchDoc]
2023-10-11 Connected voltage regulators to LA_I2C
    [10_Power.SchDoc]
2023-10-11 Swveral power sources?
    [10_Power.SchDoc]
2023-10-11 Remove area
    [08_FPGA.SchDoc]
2023-10-12 Connected I2C I/O expander (MCP23017)
    [13_Temp3.SchDoc]
2023-10-12 Removed pass trhru cap
    [11_Temp1.SchDoc]
2023-10-12 Removed clk buff
    [12_Temp2.SchDoc]
2023-10-12 SMB_CLK switch
    [12_Temp2.SchDoc]
2023-10-12 Clock swirches controls
    [13_Temp3.SchDoc]
2023-10-12 Removed SMB switch
    [09_Misc.SchDoc]
2023-10-12 Renamed mPCIe TDD pins
    [09_Misc.SchDoc]
2023-10-12 Cnnected LA pins
    [11_Temp1.SchDoc]
2023-10-12 Added TDD pins sources
    [13_Temp3.SchDoc]
2023-10-16 Renamed SD_XVdd to VCC1P35
    [11_Temp1.SchDoc]
2023-10-16 Disconnected old power raild from switching regulator and connnected VCC1P8, VCC0P9, VCC1P35
    [10_Power.SchDoc]
2023-10-16 Added tespoints for I2C
    [13_Temp3.SchDoc]
2023-10-16 Removed USB connector
    [09_Misc.SchDoc]
2023-10-16 Removed VCC3P3_MPCIE and VCC5P0_USB or diodes
    [10_Power.SchDoc]
2023-10-16 NF info
    [10_Power.SchDoc]
2023-10-16 Marked FPC GPIOs
    [09_Misc.SchDoc]
2023-10-16 Connected external LA RX BB
    [11_Temp1.SchDoc]
2023-10-17 ADC FPC info removed
    [05_LMS7002M_Misc.SchDoc]
2023-10-17 Connected LA RX1
    [11_Temp1.SchDoc]
2023-10-17 Connected LA RX to FPC
    [05_LMS7002M_Misc.SchDoc]
2023-10-17 Connected LA_I2C to PCIE SMB via 0R NF
    [09_Misc.SchDoc]
2023-10-17 Added termination resistors 0R to GND
    [05_LMS7002M_Misc.SchDoc]
2023-10-17 Connected LA_HRESET circuit
    [11_Temp1.SchDoc]
2023-10-17 Moved ADF_REF_IN
    [12_Temp2.SchDoc]
2023-10-17 Connected MCP23017 GPIOS
    [13_Temp3.SchDoc]
2023-10-17 Connected level converters
    [13_Temp3.SchDoc]
2023-10-17 Moved JTAG and BOM_VER
    [08_FPGA.SchDoc]
2023-10-17 Moved power circuit
    [11_Temp1.SchDoc]
2023-10-17 LA configuration
    [09_Misc.SchDoc]
2023-10-17 Baseband Processor sheet
    [11_Temp1.SchDoc]
2023-10-18 For LA RX FPC connector GPIO13 replaced with VCC3P3
    [05_LMS7002M_Misc.SchDoc]
2023-10-18 Removed FPGA sheet and Temp1 renamed to 08_BB_Processor
    [08_BB_Processor.SchDoc]
2023-10-18 Deleted 08_FPGA and 11_Temp1 sheets
    [08_FPGA.SchDoc, 11_Temp1.SchDoc]
2023-10-18 VCC1P8_OVDD connected directly to VCC1P8
    [08_BB_Processor.SchDoc]
2023-10-18 VCC0P9_VDD connected directly to VCC0P9
    [08_BB_Processor.SchDoc]
2023-10-18 Moved JTAG connector from Misc
    [08_BB_Processor.SchDoc]
2023-10-18 Moved schematic blocks
    [09_Misc.SchDoc]
2023-10-18 Moved level converters from Temp sheet
    [09_Misc.SchDoc]
2023-10-18 Moved Level converters to misc and added ADC drivers
    [13_Temp3.SchDoc]
2023-10-18 Added ADC drivers
    [13_Temp3.SchDoc]
2023-10-19 Changed VCC_LMS_BB_ADCDRV power rail
    [13_Temp3.SchDoc]
2023-10-19 Added bypass for ADC drivers
    [13_Temp3.SchDoc]
2023-10-19 Connected ADC VCM
    [13_Temp3.SchDoc]
2023-10-19 LMS2_ renamed to LMS_
    [05_LMS7002M_Misc.SchDoc]
2023-10-19 Renamed nets
    [13_Temp3.SchDoc]
2023-10-19 Added notes, arrows
    [13_Temp3.SchDoc]
2023-10-19 Added RX2 BB driver
    [13_Temp3.SchDoc]
2023-10-19 Changed LPF filter output resistors to 47R
    [13_Temp3.SchDoc]
2023-10-19 Connected LA_RO ADC inputs
    [08_BB_Processor.SchDoc]
2023-10-19 Fixed ADC Q_P names
    [08_BB_Processor.SchDoc]
2023-10-23 Cosmetic (moved I2C devices)
    [09_Misc.SchDoc]
2023-10-23 Swapped LA_RX and LA_RO channels
    [13_Temp3.SchDoc]
2023-10-23 PCIE_W_DISABLE2# connected direcltly and added pull up
    [09_Misc.SchDoc]
2023-10-23 Connected PCIE_W_DISABLE2# via level converter
    [09_Misc.SchDoc]
2023-10-23 Connected PCIE_W_DISABLE2#_LS to GPIO_19/ASLEEP via 0R
    [08_BB_Processor.SchDoc]
2023-10-23 Added 0R to GND for LMS_CORE_LDO_EN
    [05_LMS7002M_Misc.SchDoc]
2023-10-23 Disconnected LMS_TXEN, RXEN and CORE_LEDO_EN from port expander. Connected LED_W to port expander.
    [09_Misc.SchDoc]
2023-10-23 Cosmetic changes
    [09_Misc.SchDoc]
2023-10-23 0201 note
    [13_Temp3.SchDoc]
2023-10-24 Removed BOM_VER, HW_VER
    [09_Misc.SchDoc]
2023-10-24 Changed project structure
    [LimeSDR-Micro_1v0.PrjPcb]
2023-10-24 Renamed sheets
    [09_ADC_Drivers.SchDoc, 10_Misc.SchDoc, 11_Clock.SchDoc, 12_Power.SchDoc]
2023-10-24 Removed old sheets
    [09_Misc.SchDoc, 10_Power.SchDoc, 12_Temp2.SchDoc, 13_Temp3.SchDoc]
2023-10-24 X8 FPGC connectr's GPIO13 changed to VCC3P3
    [05_LMS7002M_Misc.SchDoc]
2023-10-24 Connected TRST_B to LA_HRESET via 0R
    [08_BB_Processor.SchDoc]
2023-10-24 LVDS buffer directly connected to LA
    [08_BB_Processor.SchDoc]
2023-10-24 Changed JTAG voltage
    [08_BB_Processor.SchDoc]
2023-10-24 Added tespoint for VCC3P3 (I2C)
    [10_Misc.SchDoc]
2023-10-24 Added GND testpoint
    [10_Misc.SchDoc]
2023-10-24 Changed LVDS drivers caps to 0201
    [08_BB_Processor.SchDoc]
2023-10-24 Changed VCC_LMS_BB_ADCDRV caps to smaller packages
    [09_ADC_Drivers.SchDoc]
2023-10-25 Removed LMS testpoint
    [05_LMS7002M_Misc.SchDoc]
2023-10-25 Changing ADF capas and resistors to 0201 packages
    [11_Clock.SchDoc]
2023-10-25 reannotated and pushed to PCB
    [01_Block_Diagram.SchDoc, 02_Power_Diagram.SchDoc, 03_Clock_Diagram.SchDoc, 04_RF_Diagram.SchDoc, 05_LMS7002M_Misc.SchDoc, 06_LMS7002M_RF.SchDoc, 07_LMS7002M_Power.SchDoc, 08_BB_Processor.SchDoc]
2023-10-25 PCB updated
2023-10-25 Schematic updated, pushed to PCB
    feedthrough cap footprint changed, I2C transistors changed
    [08_BB_Processor.SchDoc, 10_Misc.SchDoc]
2023-10-27 Layout and schematic changes
    Processor decoupling (packages reduced in schematic) layed out, unconnected nets marked, net lables fixed
    [05_LMS7002M_Misc.SchDoc, 06_LMS7002M_RF.SchDoc, 08_BB_Processor.SchDoc, 10_Misc.SchDoc]
2023-10-30 level shifter connections swapped
    [10_Misc.SchDoc]
2023-10-30 IC17 schematic connections changed
    [10_Misc.SchDoc]
2023-10-30 IC23 possible error, PCB updated
    [10_Misc.SchDoc]
2023-11-10 PCB updaed
    [11_Clock.SchDoc]
2023-11-14 Added capacitors for LA_DCS
    [08_BB_Processor.SchDoc]
2023-11-14 Moved mechanical components from sheet 5 to sheet 7
    [07_LMS7002M_Power.SchDoc]
2023-11-14 Added LMS RX BB filters
    [05_LMS7002M_Misc.SchDoc]
2023-11-14 Removed sheet "09_ADC_Drivers.SchDoc"
    [09_ADC_Drivers.SchDoc, LimeSDR-Micro_1v0.PrjPcb]
2023-11-14 Changed sheets numbering
    [LimeSDR-Micro_1v0.PrjPcb]
2023-11-14 Connected RF switches controls
    [09_Misc.SchDoc]
2023-11-14 PCIE_RESERVED connected to I2C expander
    [09_Misc.SchDoc]
2023-11-14 Changed I2C connector pinout
    [09_Misc.SchDoc]
2023-11-15 ADF RF connected to buffer (fix)
    [10_Clock.SchDoc]
2023-11-16 I/O expander pins swapped
    [09_Misc.SchDoc]
2023-11-16 PCB updated schematic notes added
    [06_LMS7002M_RF.SchDoc, 11_Power.SchDoc]
2023-11-16 Added level translators for clock
    [10_Clock.SchDoc]
2023-11-16 Connected LMS xoscin_tx directly to xoscin_rx and removed R1. Renamed LMS_TX_CLK to LMS_CLK.
    [05_LMS7002M_Misc.SchDoc]
2023-11-16 Connected level converter to clk mux
    [10_Clock.SchDoc]
2023-11-16 Changed clk mux power from VCC_CLK to VCC3P3_CLK
    [10_Clock.SchDoc]
2023-11-16 Removed VCC_CLK_BUF power rail and created VCCIO_CLK_BIAS power rail
    [10_Clock.SchDoc]
2023-11-16 Added VCCIO_CLK rail selection circuit
    [11_Power.SchDoc]
2023-11-16 Created VCC1P8_CLK power rail from VCC1P8 using LC filter
    [11_Power.SchDoc]
2023-11-16 Added bypass for clk mux B0-A path
    [10_Clock.SchDoc]
2023-11-17 clk sheet note added
    [10_Clock.SchDoc]
2023-11-17 Fixed DIR control power domain
    [10_Clock.SchDoc]
2023-11-17 Fixed level translators GNDs
    [10_Clock.SchDoc]
2023-11-17 Changed FR50 to 0201
    [11_Power.SchDoc]
2023-11-17 Changed IC22 power rail
    [10_Clock.SchDoc]
2023-11-17 Renamed power rails:
    +1.5V -> VCC1P5
    +1.75V -> VCC1P75
    +2.05V -> VCC2P05
    [11_Power.SchDoc]
2023-11-17 Connected R127 to VCC1P8
    [09_Misc.SchDoc]
2023-11-17 Changed power nets
    [06_LMS7002M_RF.SchDoc]
2023-11-20 Added pull up for TCK line
    [08_BB_Processor.SchDoc]
2023-11-20 Connected thermal diode pins to GND
    [08_BB_Processor.SchDoc]
2023-11-20 Changed EEPROM PN, fit
    [09_Misc.SchDoc]
2023-11-20 Connected HW_VER and BOM_VER
    [09_Misc.SchDoc]
2023-11-20 XO1 fit
    [10_Clock.SchDoc]
2023-11-20 Filled 01005 parts fields
    [05_LMS7002M_Misc.SchDoc]
2023-11-20 Swapped BOM_VER and HW_VER
    [09_Misc.SchDoc]
2023-11-20 Filled 01005 components fields
    [08_BB_Processor.SchDoc]
2023-11-20 Cosmetic change
    [11_Power.SchDoc]
2023-11-21 LA_PPS_OUT_LS and LA_SPI_MOSI_LS connected to bootstrap resistors (fix).
    [09_Misc.SchDoc]
2023-11-21 Changed LA config pulldown resistor values to 3,3k from 10k
    [09_Misc.SchDoc]
2023-11-21 Set LA configration
    [09_Misc.SchDoc]
2023-11-21 Connected LA_CFG_BOOT_SRC0 to pogo
    [09_Misc.SchDoc]
2023-11-21 C248 unique ID updated
    [11_Power.SchDoc]
2023-11-21 PCB cosmetics
2023-11-21 LMS I2C 0R NF
    [05_LMS7002M_Misc.SchDoc]
2023-11-21 Connected unused level converters inouts to GND
    [09_Misc.SchDoc]
2023-11-21 Removed unconnected labels
    [06_LMS7002M_RF.SchDoc]
2023-11-21 NC for pogo
    [09_Misc.SchDoc]
2023-11-22 Removed ADC BB connections
    [05_LMS7002M_Misc.SchDoc]
2023-11-22 Connected LMS_TX2_BB to FPC
    [05_LMS7002M_Misc.SchDoc]
2023-11-22 Connected EN_REG to pogo
    [09_Misc.SchDoc]
2023-11-22 LMS_TX2_BB fpc fix
    [05_LMS7002M_Misc.SchDoc]
2023-11-22 Moved LA_RO0_EXT FPC connector from sheet 5 to sheet 8
    [05_LMS7002M_Misc.SchDoc]
2023-11-22 Changed required parts to 01005 size
    [05_LMS7002M_Misc.SchDoc]
2023-11-22 Renamed PCIE_TX and PCIE_RX, added capacitor for RX.
    [08_BB_Processor.SchDoc]
2023-11-22 Renamed PCIE_TX and PCIE_RX.
    [09_Misc.SchDoc]
2023-11-22 Added PCIE_REF_CLK capacitors.
    [08_BB_Processor.SchDoc]
2023-11-23 220nF for PCIe decoupling?
    [08_BB_Processor.SchDoc]
2023-11-23 Filled resistor fields info
    [08_BB_Processor.SchDoc]
2023-11-23 Filled 0402 10uF capacitors PN
    [08_BB_Processor.SchDoc]
2023-11-23 IC10 DIR2 fix
    [09_Misc.SchDoc]
2023-11-23 NF for TDD
    [09_Misc.SchDoc]
2023-11-23 RX BB info
    [05_LMS7002M_Misc.SchDoc]
2023-11-23 Connected XO_VC_ADF to XO_VC
    [10_Clock.SchDoc]
2023-11-24 Added bias circuits for RX BB
    [05_LMS7002M_Misc.SchDoc]
2023-11-24 Updated RX BB filter PN
    [05_LMS7002M_Misc.SchDoc]
2023-11-24 Updated NF for TX BB
    [05_LMS7002M_Misc.SchDoc]
2023-11-24 Updated IREF_TX PN
    [08_BB_Processor.SchDoc]
2023-11-24 Filling PN
    [08_BB_Processor.SchDoc]
2023-11-24 Updated PPS NF
    [10_Clock.SchDoc]
2023-11-24 Filling PNs
    [08_BB_Processor.SchDoc]
2023-11-24 2.2uF 6.3V PN
    [08_BB_Processor.SchDoc]
2023-11-24 4.7uF 0201 PN
    [08_BB_Processor.SchDoc]
2023-11-24 Updated Feed Through Capacitor PN
    [08_BB_Processor.SchDoc]
2023-11-24 Bypaased (0R fit) mux buffers
    [10_Clock.SchDoc]
2023-11-24 Filled PN
    [10_Clock.SchDoc]
2023-11-24 New block diagram
    [01_Block_Diagram.SchDoc]
2023-11-24 New power diagram
    [02_Power_Diagram.SchDoc]
2023-11-24 New clock diagram
    [03_Clock_Diagram.SchDoc]
2023-11-24 New RF diagram
    [04_RF_Diagram.SchDoc]
2023-11-24 Changed document version to v1.0
    [05_LMS7002M_Misc.SchDoc]
2023-11-27 Added LP8758-E3 output voltages
    [11_Power.SchDoc]
2023-11-27 Swapped IC25 channels to match IC25 LP8758-E3 new defaults
    [11_Power.SchDoc]
2023-11-27 Swapped IC28 channels to match IC25 LP8758-E3 new defaults. Updated LP8758 default parameters note.
    [11_Power.SchDoc]
2023-11-27 Updated IC25 and IC28 PN
    [11_Power.SchDoc]
2023-11-27 Connected AP7330 LDO
    [11_Power.SchDoc]
2023-11-27 Added VCC1P35 voltage selection Cosmetic
    [11_Power.SchDoc]
2023-11-27 Moved mechanical components from sheet 7 to sheet 11.
    [11_Power.SchDoc]
2023-11-27 reannotated, layout updated
    [01_Block_Diagram.SchDoc, 02_Power_Diagram.SchDoc, 03_Clock_Diagram.SchDoc, 04_RF_Diagram.SchDoc, 05_LMS7002M_Misc.SchDoc, 06_LMS7002M_RF.SchDoc, 07_LMS7002M_Power.SchDoc, 08_BB_Processor.SchDoc]
2023-11-28 Marked pcie caps
    [08_BB_Processor.SchDoc]
2023-11-28 Change uFL designators X to J
    [10_Clock.SchDoc]
2023-11-28 nged PCIE from 100nF to 220nF
    [08_BB_Processor.SchDoc]
2023-11-28 Removed designers notes
    [08_BB_Processor.SchDoc]
2023-11-28 Updated sheet total value
    [01_Block_Diagram.SchDoc]
2023-11-28 Annotated cloc ufl connectors
    [10_Clock.SchDoc]
2023-11-28 Updated diagram
    [01_Block_Diagram.SchDoc]
2023-11-28 Updated bias note
    [10_Clock.SchDoc]
2023-11-29 XO_VC_ADF renamed to XO_VC (fix)
    [10_Clock.SchDoc]
2023-11-29 Updated clock diagram
    [03_Clock_Diagram.SchDoc]
2023-11-29 Added No ERC violation for VCC3P3_CLK
    [11_Power.SchDoc]
2023-11-29 Removed PERST# net and R130, R131 NF
    [09_Misc.SchDoc]
2023-11-29 Updated power diagram (removed VCC1P8_CLK)
    [02_Power_Diagram.SchDoc]
2023-12-05 Changed BB tx structure
    [05_LMS7002M_Misc.SchDoc]
2023-12-06 Change RX BB structure
    [05_LMS7002M_Misc.SchDoc]
2023-12-06 RX BB parts values
    [05_LMS7002M_Misc.SchDoc]
2023-12-06 Moved BB blocks to the right
    [05_LMS7002M_Misc.SchDoc]
2023-12-07 Changed TX BB values
    [05_LMS7002M_Misc.SchDoc]
2023-12-12 Added pullups fot SPI SS lines
    [09_Misc.SchDoc]
2023-12-12 TH_VDD connected directly to VCC1P8
    [08_BB_Processor.SchDoc]
2023-12-12 PROG_VDD connected directly to GND
    [08_BB_Processor.SchDoc]
2023-12-12 AFE_OMVDD powered through OTVDD filter
    [08_BB_Processor.SchDoc]
2023-12-12 Added common mode filter capacitors
    [05_LMS7002M_Misc.SchDoc]
2023-12-12 BB filter PN
    [05_LMS7002M_Misc.SchDoc]
2023-12-12 PCB DRC pass
    SN74AVC4T774 footprint updated to high-density, duplicate unique IDs reset, pushed to PCB
    [08_BB_Processor.SchDoc, 09_Misc.SchDoc]
2023-12-13 Changed reset circuit Connected HRESET to molex connector instead GND
    [08_BB_Processor.SchDoc]
2023-12-13 Added 0R to HRESET
    [08_BB_Processor.SchDoc]
2023-12-13 Added bypass option
    [08_BB_Processor.SchDoc]
2023-12-13 Added bypass option with divider
    [08_BB_Processor.SchDoc]
2023-12-13 shottkey diode footprint added, JTAG TDI fixed
    [08_BB_Processor.SchDoc]
2023-12-18 Added series resistor
    [08_BB_Processor.SchDoc]
2023-12-18 Reannotated, PCB DRC pass
    [05_LMS7002M_Misc.SchDoc, 06_LMS7002M_RF.SchDoc, 07_LMS7002M_Power.SchDoc, 08_BB_Processor.SchDoc, 09_Misc.SchDoc, 10_Clock.SchDoc, 11_Power.SchDoc]
2023-12-18 Changed DCS_CLK series resistors from 10R to 6.8R
    [08_BB_Processor.SchDoc]
2023-12-19 Net classes added, BB lengths matched
    [05_LMS7002M_Misc.SchDoc, 08_BB_Processor.SchDoc]
2023-12-19 NFs and BOM formatted
    [05_LMS7002M_Misc.SchDoc, 06_LMS7002M_RF.SchDoc, 08_BB_Processor.SchDoc, 09_Misc.SchDoc, 10_Clock.SchDoc, 11_Power.SchDoc]
2023-12-27 CL03A104MP3NNNC part description fixed
    description was 100pF although part is 100nF
    [06_LMS7002M_RF.SchDoc, 08_BB_Processor.SchDoc, 09_Misc.SchDoc, 10_Clock.SchDoc, 11_Power.SchDoc]
2023-12-27 R6,R9 P/N fixed
    was left 01005 although footprint is 0201
    [05_LMS7002M_Misc.SchDoc]
2023-12-27 DFM DB generated
    [08_BB_Processor.SchDoc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]
2024-05-06 Initial altium project commit
    [01_Block_Diagram.SchDoc, 02_Power_Diagram.SchDoc, 03_Clock_Diagram.SchDoc, 04_RF_Diagram.SchDoc, 05_LMS7002M_Misc.SchDoc, 06_LMS7002M_RF.SchDoc, 07_LMS7002M_Power.SchDoc, 08_BB_Processor.SchDoc]
2024-05-06 PCB updated to M.2 formfactor
2024-05-06 Added temp sheet
    [12_Temp.SchDoc, LimeSDR-Micro_M.2_1v0.PrjPcb]
2024-05-07 Added M.2
    [12_Temp.SchDoc]
2024-05-08 AUX name for HAM
    [06_LMS7002M_RF.SchDoc]
2024-05-08 UFL footprint changed to XFL
    [06_LMS7002M_RF.SchDoc, 09_Misc.SchDoc, 10_Clock.SchDoc, 12_Temp.SchDoc]
2024-05-08 Schematic notes added, layout updated
    [06_LMS7002M_RF.SchDoc, 09_Misc.SchDoc, 10_Clock.SchDoc, 12_Temp.SchDoc]
2024-05-09 Connected M.2 power and GND
    [12_Temp.SchDoc]
2024-05-09 Connected PCIe to M.2
    [12_Temp.SchDoc]
2024-05-09 Connecting M.2
    [12_Temp.SchDoc]
2024-05-09 Marked R15
    [05_LMS7002M_Misc.SchDoc]
2024-05-09 Removed 6 pin pogo JTAG
    [08_BB_Processor.SchDoc]
2024-05-09 M.2 notes
    [12_Temp.SchDoc]
2024-05-09 Removed 6 pin pogo MISC
    [09_Misc.SchDoc]
2024-05-09 Added PCIe caps info
    [12_Temp.SchDoc]
2024-05-09 M.2 power note
    [11_Power.SchDoc]
2024-05-09 Resistor note
    [08_BB_Processor.SchDoc]
2024-05-09 Directions note
    [12_Temp.SchDoc]
2024-05-13 IC22 B0, B1 marked
    [10_Clock.SchDoc]
2024-05-13 M.2 GPIO signals
    [12_Temp.SchDoc]
2024-05-13 Connected LED_WWAN# to M.2 pin 10 (LED1#)
    [12_Temp.SchDoc]
2024-05-13 Connecting M.2 GPIO
    [12_Temp.SchDoc]
2024-05-13 CLK_OUT info
    [12_Temp.SchDoc]
2024-05-13 CLK_OUT switch notes
    [10_Clock.SchDoc]
2024-05-13 VCCIO_CLK note
    [11_Power.SchDoc]
2024-05-14 Connecting header
    [12_Temp.SchDoc]
2024-05-14 Added 0R resistor for LMS_MCLK1
    [08_BB_Processor.SchDoc]
2024-05-14 LED_WWAN# renamed to M.2_LED1#
    [09_Misc.SchDoc]
2024-05-14 Changed VCCIO_CLK voltage to VCC1P8 (FR49 fir, FR51 NF)
    [11_Power.SchDoc]
2024-05-14 Changed PCIE_W_DISABLE2# pull up voltage to 3.3V
    [12_Temp.SchDoc]
2024-05-14 VCC3P3_MPCIE renamed to VCC3P3_M.2
    [09_Misc.SchDoc]
2024-05-14 Added alterrnative source (VCC1P8) for M.2 PPS_IN and PPS_OUT
    [09_Misc.SchDoc]
2024-05-14 Added M.2_PPS_IN and M.2_PPS_OUT note
    [10_Clock.SchDoc]
2024-05-14 RX_HAM renamed to RX_AUX
    [06_LMS7002M_RF.SchDoc]
2024-05-14 Removed mPCIe
    [12_Temp.SchDoc]
2024-05-14 Moved M.2 2280 B+M key from sheet 12 (temp) to sheet 09 (Misc)
    [12_Temp.SchDoc]
2024-05-14 Moved JTAG connector from sheet 12 (temp) to sheet 08 (BB)
    [08_BB_Processor.SchDoc]
2024-05-14 Moved SYS header from sheet 12 (temp) to sheet 09 (Misc)
    [09_Misc.SchDoc]
2024-05-15 X.FL mark
    [10_Clock.SchDoc]
2024-05-15 Added VCCIO_PPS voltage selection
    [11_Power.SchDoc]
2024-05-15 Connected VCCIO_PPS instead resistors
    [09_Misc.SchDoc]
2024-05-15 Connected PCIE_W_DISABLE1# to IO EXP GPB7 and M.2 pin 8
    [09_Misc.SchDoc]
2024-05-15 Added SMB_CLK bypass option
    [10_Clock.SchDoc]
2024-05-15 Added SMB_CLK_CTRL pullup
    [10_Clock.SchDoc]
2024-05-15 Startded adding separate convertes for PPS
    [12_Temp.SchDoc]
2024-05-15 Added separate level converters for LA_PPS_IN and LA_PPS_OUT
    [10_Clock.SchDoc]
2024-05-15 Removed LA_PPS_IN and LA_PPS_OUT buffer
    [09_Misc.SchDoc]
2024-05-15 Disconnected TDD0_GPIO and TDD0_GPI1 from level converter Disconnected PCIE_W_DISABLE2# from level converter
    [09_Misc.SchDoc]
2024-05-15 Connected PCIE_W_DISABLE2# directly to M.2 pin 26
    [08_BB_Processor.SchDoc]
2024-05-16 Renamed LED_WPAN# to A1, LED_WLAN# to A2
    [09_Misc.SchDoc]
2024-05-16 Renamed SMB_CLK to M.2_CLK_OUT
    [09_Misc.SchDoc]
2024-05-16 Added 0R for CLK_IN and named new net to M.2_CLK_IN
    [10_Clock.SchDoc]
2024-05-16 Connected M.2_CLK_IN to M.2 pin 28
    [09_Misc.SchDoc]
2024-05-16 Moved M.2_CLK_OUT 0R resistor to sheet 10 (Clock)
    [10_Clock.SchDoc]
2024-05-16 Connected M.2 pin to 1
    [09_Misc.SchDoc]
2024-05-16 Updated M.2 note
    [09_Misc.SchDoc]
2024-05-16 J1 NF
    [08_BB_Processor.SchDoc]
2024-05-16 J2 NF
    [09_Misc.SchDoc]
2024-05-16 Updated sys header note
    [09_Misc.SchDoc]
2024-05-16 Swapped PER with PET
    [08_BB_Processor.SchDoc]
2024-05-17 UFL/XFL changed to MHF4
    [06_LMS7002M_RF.SchDoc, 09_Misc.SchDoc, 10_Clock.SchDoc]
2024-05-20 R165 fit
    [10_Clock.SchDoc]
2024-05-20 Added A1 And A2 nets note
    [09_Misc.SchDoc]
2024-05-20 R15 NF
    [05_LMS7002M_Misc.SchDoc]
2024-05-20 Removed 12_Temp sheet
    [12_Temp.SchDoc, LimeSDR-Micro_M.2_1v0.PrjPcb]
2024-05-20 Renamed project files from LimeSDR-Micro_M.2_1v0 to LimeSDR-Micro_M.2_2280_1v0
    [LimeSDR-Micro_M.2_2280_1v0.PrjPcb]
2024-05-20 Renamed project
    [LimeSDR-Micro_M.2_2280_1v0.PrjPcb]
2024-05-20 Added J2 part
    [09_Misc.SchDoc]
2024-05-20 Addded J1 PN
    [08_BB_Processor.SchDoc]
2024-05-20 Updated block diagram
    [01_Block_Diagram.SchDoc]
2024-05-20 Updated power diagram
    [02_Power_Diagram.SchDoc]
2024-05-20 Updated RF diagram
    [04_RF_Diagram.SchDoc]
2024-05-20 Cleaned schematic
    [05_LMS7002M_Misc.SchDoc, 06_LMS7002M_RF.SchDoc, 08_BB_Processor.SchDoc, 09_Misc.SchDoc, 10_Clock.SchDoc, 11_Power.SchDoc]
2024-05-21 NFs and output jobs updated
    [05_LMS7002M_Misc.SchDoc, 08_BB_Processor.SchDoc, 09_Misc.SchDoc, 10_Clock.SchDoc, 11_Power.SchDoc]
2024-05-21 BOM generated, NFs checked
    [05_LMS7002M_Misc.SchDoc, 06_LMS7002M_RF.SchDoc, 08_BB_Processor.SchDoc, 09_Misc.SchDoc, 10_Clock.SchDoc, 11_Power.SchDoc, LimeSDR-Micro_M.2_2280_1v0_BOMr0.xls]
2024-05-22 DFM generated
    [06_LMS7002M_RF.SchDoc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]
2024-05-31 DFMr1 generated with minor fixes
    - C123 changed P/N fixed from 33nF to 3.3 nF;
    - R86 value changed from 5R to 5R1 to match P/N;
    - R2, R4, R16, R18, R27, R33, R36, R41, R43, R48, R50, R57 part description updated;
    - Stackup updated to match 0.8mm thickness;
    - Output jobs updated;
    - New PCB specs PDF generated;
    - New schematic generated;
    - BOM updated with fixes;
    - New mechanical gerber LimeSDR-Micro_M.2_2280_1v0.GM1 generated;
    [05_LMS7002M_Misc.SchDoc, 08_BB_Processor.SchDoc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]
2024-05-31 DFMr1 created with minor fixes
    - R80 value changed from 5R to 5R1 to match P/N;
    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
    [05_LMS7002M_Misc.SchDoc, 08_BB_Processor.SchDoc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]
2024-06-25 Initial 1v1 commit based on 1v0
    [01_Block_Diagram.SchDoc, 02_Power_Diagram.SchDoc, 03_Clock_Diagram.SchDoc, 04_RF_Diagram.SchDoc, 05_LMS7002M_Misc.SchDoc, 06_LMS7002M_RF.SchDoc, 07_LMS7002M_Power.SchDoc, 08_BB_Processor.SchDoc]
2024-06-25 ID changed
    [LimeSDR-Micro_1v1.PrjPcb]
2024-06-25 Renamed switrching regulators LA_I2C_SDA to LA_I2C_SDA0 and LA_I2C_SDA1. Connedted analog mux for LA_I2C_SDA0 and LA_I2C_SDA1.
    [11_Power.SchDoc]
2024-06-26 Added 0R for GNSS_RXD
    [09_Misc.SchDoc]
2024-06-26 Moved R133 from MISC sheet (PCIE_CLK_IN CLK IN resistor)
    [10_Clock.SchDoc]
2024-06-26 Renamed SMB_CLK to PCIE_CLK_OUT. Added SMB_CLK_CTRL pullup resistor.
    [10_Clock.SchDoc]
2024-06-26 Renamed SMB_CLK to PCIE_CLK_OUT.
    [09_Misc.SchDoc]
2024-06-26 RX_HAM connector renamed to RX_AUX
    [06_LMS7002M_RF.SchDoc]
2024-06-26 Added pull up for I2C_SDA_SEL
    [11_Power.SchDoc]
2024-06-26 BOM_VER0 connected to I2C_SDA_SEL.
    [09_Misc.SchDoc]
2024-06-26 Renamed BOM_VER1 to BOM_VER0. Removed BOM_VER1 resistor R144.
    [09_Misc.SchDoc]
2024-06-26 Annotated, PCB and output jobs updated
    [01_Block_Diagram.SchDoc, 02_Power_Diagram.SchDoc, 03_Clock_Diagram.SchDoc, 04_RF_Diagram.SchDoc, 05_LMS7002M_Misc.SchDoc, 06_LMS7002M_RF.SchDoc, 07_LMS7002M_Power.SchDoc, 08_BB_Processor.SchDoc]
2024-06-26 Added truth table for analog mux
    [11_Power.SchDoc]
2024-06-26 R197, R211 NF
    [11_Power.SchDoc]
2024-06-26 Changed I2C pull ups to 3.3k for BOM optimization and faster I2C speeds
    [09_Misc.SchDoc]
2024-06-26 Changed I2C pull ups to 3.3k for BOM optimization
    [05_LMS7002M_Misc.SchDoc]
2024-06-26 Changed LA_I2C_SDA0 and LA_I2C_SDA1 pull ups to 100k
    [11_Power.SchDoc]
2024-06-26 Pull-up resistor values changed
    [05_LMS7002M_Misc.SchDoc, 09_Misc.SchDoc, 11_Power.SchDoc]
2024-06-26 R162 fit
    [10_Clock.SchDoc]
2024-06-26 Added PCIE_CLK_OUT analog switch bypass option (0R NF)
    [10_Clock.SchDoc]
2024-06-26 Removed R134 (was two series pulldowns)
    [09_Misc.SchDoc]
2024-06-26 Adde GNSS_RXD, GNSS_TXD notes
    [09_Misc.SchDoc]
2024-06-26 Annotated, pushed to PCB
    [10_Clock.SchDoc]
2024-06-26 NF list updated
    [05_LMS7002M_Misc.SchDoc, 10_Clock.SchDoc, 11_Power.SchDoc]
2024-06-27 NF checks, PCB cosmetics, change log updated
    [09_Misc.SchDoc, 11_Power.SchDoc]
2024-06-27 DB DFM generated final project archive not done
    To be done - diagrams, remove change markings, generate schematic
    [LimeSDR-Micro_1v1_BOMr0.xls]
2024-06-27 Gerbers generated
    [LimeSDR-Micro_1v1.GBL, LimeSDR-Micro_1v1.GBO, LimeSDR-Micro_1v1.GBP, LimeSDR-Micro_1v1.GBS, LimeSDR-Micro_1v1.GM1, LimeSDR-Micro_1v1.GTL, LimeSDR-Micro_1v1.GTO, LimeSDR-Micro_1v1.GTP]
2024-07-01 Clean schematic
    [05_LMS7002M_Misc.SchDoc, 06_LMS7002M_RF.SchDoc, 08_BB_Processor.SchDoc, 09_Misc.SchDoc, 10_Clock.SchDoc, 11_Power.SchDoc]
2024-07-01 Updated ID
    [LimeSDR-Micro_1v1.PrjPcb]
2024-07-01 DFM schematic generated. DFM database added
2024-11-05 Initial 1v1 commit based on 1v0 project
    [01_Block_Diagram.SchDoc, 02_Power_Diagram.SchDoc, 03_Clock_Diagram.SchDoc, 04_RF_Diagram.SchDoc, 05_LMS7002M_Misc.SchDoc, 06_LMS7002M_RF.SchDoc, 07_LMS7002M_Power.SchDoc, 08_BB_Processor.SchDoc]
2024-11-05 Added LimeMicroAltiumLib submodule
    [LimeSDR-Micro_M.2_2280_1v1.PrjPcb]
2024-11-05 Attention marks
    [10_Clock.SchDoc]
2024-11-05 BOM_VER0 connected to I2C_SDA_SEL. Renamed BOM_VER1 to BOM_VER0. Removed BOM_VER1 resistor R144. HW_VER was not changed.
    [09_Misc.SchDoc]
2024-11-05 Renamed switching regulators LA_I2C_SDA to LA_I2C_SDA0 and LA_I2C_SDA1
    [11_Power.SchDoc]
2024-11-05 R207, R221 NF. Changed LA_I2C_SDA0 and LA_I2C_SDA1 pull ups to 100k.
    [11_Power.SchDoc]
2024-11-05 Connected analog mux for LA_I2C_SDA0 and LA_I2C_SDA1.
    [11_Power.SchDoc]
2024-11-05 Removed BOM_VER1
    [09_Misc.SchDoc]
2024-11-06 Renamed switching regulators LA_I2C_SDA to LA_I2C_SDA0 and LA_I2C_SDA1. R207, R221 NF. Changed LA_I2C_SDA0 and LA_I2C_SDA1 pull ups to 100k. Connected analog mux for LA_I2C_SDA0 and LA_I2C_SDA1.
    [11_Power.SchDoc]
2024-11-06 Added designer notes
    [10_Clock.SchDoc]
2024-11-06 Added RFCTL info
    [09_Misc.SchDoc]
2024-11-06 Changed RFCTL pins, added LNA1_EN, diconnected LA_GPIO_05, LA_GPIO_06
    [09_Misc.SchDoc]
2024-11-06 Diconnected LA_GPIO_05, LA_GPIO_06 from RFCTL
    [08_BB_Processor.SchDoc]
2024-11-06 Connected M.2 RFCTL
    [09_Misc.SchDoc]
2024-11-06 Added testpoints for LA_I2C
    [09_Misc.SchDoc]
2024-11-06 Disconnected LA_CFG_BOOT_SRC0, LA_I2C_SDA, LA_I2C_SCL from SYS header
    [09_Misc.SchDoc]
2024-11-06 Disconnected LA_CFG_BOOT_SRC0, LA_I2C_SDA, LA_I2C_SCL from SYS header and connected LA_PA_EN, LA_LNA1_EN, LA_TRX0
    [09_Misc.SchDoc]
2024-11-06 Changed IC8 ch4 dirrection, and connected LA_TRX0, LA_LNA1_EN, LA_PA_EN to levels converters (1.8V to 3.3V).
    [09_Misc.SchDoc]
2024-11-07 Marked I2C_SDA_SEL
    [11_Power.SchDoc]
2024-11-07 Connecting LMK
    [12_Temp.SchDoc]
2024-11-07 Connected RC filters for LMS_PLL
    [12_Temp.SchDoc]
2024-11-07 Connected LMK clkouts
    [12_Temp.SchDoc]
2024-11-07 Connected analog mux for LMK clkin
    [12_Temp.SchDoc]
2024-11-07 Connected XOs
    [12_Temp.SchDoc]
2024-11-07 Moved XO DAC to temp sheet
    [10_Clock.SchDoc]
2024-11-07 Connected M.2 clk mux
    [12_Temp.SchDoc]
2024-11-07 Moved M.2 clk mux to temp sheet
    [10_Clock.SchDoc]
2024-11-07 Connected LMK_CLKOUT1 intead CLKOUT to MHF4 connector
    [10_Clock.SchDoc]
2024-11-07 Removed level converters and other unnecessary stuff
    [10_Clock.SchDoc]
2024-11-07 Moved clk buff, analog mux and XOs from temp sheet
    [10_Clock.SchDoc]
2024-11-07 Connected CLK_IN to analo mux
    [10_Clock.SchDoc]
2024-11-07 Replaced single LMS_CLK by two speperate LMS_TxPLL_CLK and LMS_RxPLL_CLK clocks
    [05_LMS7002M_Misc.SchDoc]
2024-11-07 Moved XO DAC from temp sheet
    [10_Clock.SchDoc]
2024-11-07 Moved M.2 CLK OUT Switch from temp sheet
    [10_Clock.SchDoc]
2024-11-07 Removed temp sheet from project
    [12_Temp.SchDoc, LimeSDR-Micro_M.2_2280_1v0.PrjPcb]
2024-11-07 Changed reset circuit
    [08_BB_Processor.SchDoc]
2024-11-07 Added net class for LMK outputs
    [10_Clock.SchDoc]
2024-11-07 BOM_VER0 connected to I2C_SDA_SEL. Renamed BOM_VER1 to BOM_VER0. Removed BOM_VER1 resistor R146. HW_VER was not changed.
    [09_Misc.SchDoc]
2024-11-07 Connected LA_GPIO_05, LA_GPIO_06 to M.2 GPIOs
    [09_Misc.SchDoc]
2024-11-07 partially reannotated, PCB updated
    [08_BB_Processor.SchDoc, 09_Misc.SchDoc, 10_Clock.SchDoc, 11_Power.SchDoc]
2024-11-07 Added pull up resistor (NF) for PCIE_PERST#
    [08_BB_Processor.SchDoc]
2024-11-07 Changed LMK passive parts to existing BOM components
    [10_Clock.SchDoc]
2024-11-07 Changed LMK power inductor to smaller form factor
    [10_Clock.SchDoc]
2024-11-08 layout updated, schematic errors found
    [10_Clock.SchDoc, 11_Power.SchDoc]
2024-11-11 Removed VCC1P8_CLK power net and LC filter
    [11_Power.SchDoc]
2024-11-11 Renamed REF_ADF to ADF_RF_IN
    [10_Clock.SchDoc]
2024-11-11 Removed LC
    [11_Power.SchDoc]
2024-11-11 Removed unfinished v1.1 project
    [01_Block_Diagram.SchDoc, 02_Power_Diagram.SchDoc, 03_Clock_Diagram.SchDoc, 04_RF_Diagram.SchDoc, 05_LMS7002M_Misc.SchDoc, 06_LMS7002M_RF.SchDoc, 07_LMS7002M_Power.SchDoc, 08_BB_Processor.SchDoc]
2024-11-11 IC9 pin 1 and 2, 12 and 11 swapped
    [09_Misc.SchDoc]
2024-11-12 Changed XO DAC from AD5693RACPZ-1RL7 (A grade, INL +-8LSB, internal reference, VLOGIC) to AD5693BCPZ-RL7 (B grade, INL +-3LSB, no internal reference, LDAC).
    Changed R164 to NF, R163 to fit to tie LDAC pin low and DAC updates when new data is written to the input register.
    [10_Clock.SchDoc]
2024-11-12 Changed Voltage reference from LM4040C30FTADICT-ND (3.0V) to AS431ANTR-G1DICT-ND (2.5V).lsco changed resistors accordingly.
    [11_Power.SchDoc]
2024-11-12 Connected XO DAC VREF directly to external 2.5V refernce source (R170 changed to 0R, R174 to NF)
    [10_Clock.SchDoc]
2024-11-12 Added power rails selection for VCC3P3 and VCC_CLK (directly connection option to VCC_EXT).
    [11_Power.SchDoc]
2024-11-13 Reannotated, pushed to PCB
    [05_LMS7002M_Misc.SchDoc, 06_LMS7002M_RF.SchDoc, 07_LMS7002M_Power.SchDoc, 08_BB_Processor.SchDoc, 09_Misc.SchDoc, 10_Clock.SchDoc, 11_Power.SchDoc, LimeSDR-Micro_M.2_2280_1v0.PrjPcb]
2024-11-13 Renamed PCIE_PPS_OUT and PCIE_PPS_IN to M.2_PPS_OUT and M.2_PPS_IN accordingly.
    [09_Misc.SchDoc]
2024-11-14 Removed LimeSDR-Micro_M.2_2280_1v0_DB_DFMr1 folder
    [LimeSDR-Micro_M.2_2280_1v0.GBL, LimeSDR-Micro_M.2_2280_1v0.GBO, LimeSDR-Micro_M.2_2280_1v0.GBP, LimeSDR-Micro_M.2_2280_1v0.GBS, LimeSDR-Micro_M.2_2280_1v0.GM1, LimeSDR-Micro_M.2_2280_1v0.GTL, LimeSDR-Micro_M.2_2280_1v0.GTO, LimeSDR-Micro_M.2_2280_1v0.GTP]
2024-11-14 Initial LimeSDR-Micro v1.2 commit made from v1.1
    [01_Block_Diagram.SchDoc, 02_Power_Diagram.SchDoc, 03_Clock_Diagram.SchDoc, 04_RF_Diagram.SchDoc, 05_LMS7002M_Misc.SchDoc, 06_LMS7002M_RF.SchDoc, 07_LMS7002M_Power.SchDoc, 08_BB_Processor.SchDoc]
2024-11-14 Replaced single LMS_CLK by two seperate LMS_TxPLL_CLK and LMS_RxPLL_CLK clocks
    [05_LMS7002M_Misc.SchDoc]
2024-11-14 Changed XO DAC from AD5693RACPZ-1RL7 (A grade, INL +-8LSB, internal reference, VLOGIC) to AD5693BCPZ-RL7 (B grade, INL +-3LSB, no internal reference, LDAC).
    Connected XO DAC VREF directly to external 2.5V reference source (R170 changed to 0R, R174 to NF)
    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
    [10_Clock.SchDoc]
2024-11-15 NFs updated
    [05_LMS7002M_Misc.SchDoc, 06_LMS7002M_RF.SchDoc, 08_BB_Processor.SchDoc, 09_Misc.SchDoc, 10_Clock.SchDoc, 11_Power.SchDoc]
2024-11-18 Removed marked changes
    [05_LMS7002M_Misc.SchDoc, 08_BB_Processor.SchDoc, 09_Misc.SchDoc, 10_Clock.SchDoc, 11_Power.SchDoc]
2024-11-18 DFMr2 generated
    [LimeSDR-Micro_M.2_2280_1v0.GBL, LimeSDR-Micro_M.2_2280_1v0.GBO, LimeSDR-Micro_M.2_2280_1v0.GBP, LimeSDR-Micro_M.2_2280_1v0.GBS, LimeSDR-Micro_M.2_2280_1v0.GM1, LimeSDR-Micro_M.2_2280_1v0.GTL, LimeSDR-Micro_M.2_2280_1v0.GTO, LimeSDR-Micro_M.2_2280_1v0.GTP]
2024-11-18 Replaced old buufers with LMK buffer
    [10_Clock.SchDoc]
2024-11-18 Removed bias circuit
    [10_Clock.SchDoc]
2024-11-18 Removed VCCIO_CLK power rail
    [11_Power.SchDoc]
2024-11-18 Removed VCC1P8_CLK power rail
    [11_Power.SchDoc]
2024-11-18 Renamed switching regulators outputs nets VCC3P3 and VCC_CLK to VCC3P3_SW and VCC_CLK_SW accordingly.
    [11_Power.SchDoc]
2024-11-18 Disconnected LA_GPIO_05 and LA_CFG_RST_HNDSHK from TDD0_GPIO_LS sources
    [09_Misc.SchDoc]
2024-11-18 Disconnected LA_GPIO_05 and LA_CFG_RST_HNDSHK from TDD0_GPIO_LS sources
    Connected LA_CFG_RST_HNDSHK as TDD0_GPIO_LS source
    [09_Misc.SchDoc]
2024-11-18 Connecected LNA1_EN_LS to level converter (1.8V to 3.3V).
    [09_Misc.SchDoc]
2024-11-18 Connected LA_CFG_TEST_PORT_DIS as LNA1_EN_LS source.
    [09_Misc.SchDoc]
2024-11-18 Diconnected LA_GPIO_05, LA_GPIO_06 and LA_CFG_BOOT_SRC1 from TDD control signals.
    [09_Misc.SchDoc]
2024-11-18 Diconnected PCIE_RESERVED from mPCIe 45 and connected LNA1_EN to mPCIe pin 45.
    [09_Misc.SchDoc]
2024-11-18 Disconencted LA_I2C_SCL, LA_I2C_SDA from and EN_REG from X6. Connected TDD0_GPIO, TDD1_GPIO and LNA1_EN to X6.
    [09_Misc.SchDoc]
2024-11-18 Added testpoints
    [08_BB_Processor.SchDoc, 09_Misc.SchDoc]
2024-11-18 anootated, PCB updated
    [08_BB_Processor.SchDoc, 09_Misc.SchDoc, 10_Clock.SchDoc, 11_Power.SchDoc]
2024-11-19 Renamed VCC3P3_M.2 to VCC3P3_MPCIE
    [08_BB_Processor.SchDoc]
2024-11-19 Renamed PCIE_RESERVED to EXP_GPB7 and connected to X12 pin 12
    [09_Misc.SchDoc]
2024-11-20 Fixed VCC3P3_LMK power net
    [10_Clock.SchDoc]
2024-11-20 Changed VCC_EXT power voltages note
    [11_Power.SchDoc]
2024-11-20 Added CLK_PATH netclasses
    [10_Clock.SchDoc]
2024-11-20 Added CLK_PATH net class
    [10_Clock.SchDoc]
2024-11-20 Removed TP4 from EXP_GPB7 line
    [09_Misc.SchDoc]
2024-11-20 Reannotated, output jobs updated, DRC clean
    [01_Block_Diagram.SchDoc, 02_Power_Diagram.SchDoc, 03_Clock_Diagram.SchDoc, 04_RF_Diagram.SchDoc, 05_LMS7002M_Misc.SchDoc, 06_LMS7002M_RF.SchDoc, 07_LMS7002M_Power.SchDoc, 08_BB_Processor.SchDoc]
2024-11-20 Unlocked some components designators
    [05_LMS7002M_Misc.SchDoc, 08_BB_Processor.SchDoc, 09_Misc.SchDoc]
2024-11-20 Changed designator from J3 to X?
    [09_Misc.SchDoc]
2024-11-20 Unlocked X10 designator
    [09_Misc.SchDoc]
2024-11-20 reannotated after unlocking designators
    [05_LMS7002M_Misc.SchDoc, 06_LMS7002M_RF.SchDoc, 07_LMS7002M_Power.SchDoc, 08_BB_Processor.SchDoc, 09_Misc.SchDoc, 10_Clock.SchDoc, 11_Power.SchDoc]
2024-11-20 assembly and cosmetics
2024-11-21 Revert "PCB updated"
    This reverts commit a6804a6d26c2787c8c3772bd96cb831c347db2bc.
2024-11-21 X8 connector position rechecked, silkscreen updated
2024-11-21 Replaced 0.05" 8x1 header with 8 pin FPC connector. Renamed A2 to EXP_GPA2 and connected to FPC connector pin 8.
    [09_Misc.SchDoc]
2024-11-21 Added testpoint for GNSS_TXD and GNSS_RXD
    [09_Misc.SchDoc]
2024-11-21 Connected LA_PA_EN to FPC pin 4
    [09_Misc.SchDoc]
2024-11-21 PCB updated, DFMr2 files deleted
    [LimeSDR-Micro_M.2_2280_1v0.GBL, LimeSDR-Micro_M.2_2280_1v0.GBO, LimeSDR-Micro_M.2_2280_1v0.GBP, LimeSDR-Micro_M.2_2280_1v0.GBS, LimeSDR-Micro_M.2_2280_1v0.GM1, LimeSDR-Micro_M.2_2280_1v0.GTL, LimeSDR-Micro_M.2_2280_1v0.GTO, LimeSDR-Micro_M.2_2280_1v0.GTP]
2024-11-25 Unlocked X8 designator
    [05_LMS7002M_Misc.SchDoc]
2024-11-25 Unlocked X13 designator
    [08_BB_Processor.SchDoc]
2024-11-25 Changed J2 designator to X?
    [09_Misc.SchDoc]
2024-11-25 Reannotated whole schematic
    [05_LMS7002M_Misc.SchDoc, 06_LMS7002M_RF.SchDoc, 07_LMS7002M_Power.SchDoc, 08_BB_Processor.SchDoc, 09_Misc.SchDoc, 10_Clock.SchDoc, 11_Power.SchDoc]
2024-11-25 PCB updated with new changes
2024-11-26 Updated XO note
    [10_Clock.SchDoc]
2024-11-27 Deleted changemarks
    [05_LMS7002M_Misc.SchDoc, 08_BB_Processor.SchDoc, 09_Misc.SchDoc, 10_Clock.SchDoc, 11_Power.SchDoc]
2024-11-27 Removed floating GNSS_TXD and GNSS_RXD nets
    [09_Misc.SchDoc]
2024-11-27 NFs checked, BOM generated
    [09_Misc.SchDoc, 11_Power.SchDoc, LimeSDR-Micro_M.2_2280_1v0.PrjPcb, LimeSDR-Micro_M.2_2280_1v0_BOMr2.xls, LimeSDR-Micro_M.2_2280_1v0_BOMr3.xls]
2024-11-27 DFMr3 generated
    [LimeSDR-Micro_M.2_2280_1v0.GBL, LimeSDR-Micro_M.2_2280_1v0.GBO, LimeSDR-Micro_M.2_2280_1v0.GBP, LimeSDR-Micro_M.2_2280_1v0.GBS, LimeSDR-Micro_M.2_2280_1v0.GM1, LimeSDR-Micro_M.2_2280_1v0.GTL, LimeSDR-Micro_M.2_2280_1v0.GTO, LimeSDR-Micro_M.2_2280_1v0.GTP]
2024-11-27 NF lists updated, PCB cosmetics
    [09_Misc.SchDoc, 10_Clock.SchDoc, 11_Power.SchDoc]
2024-11-27 LimeSDR-Micro_1v2_DFMr0 generated
    [LimeSDR-Micro_1v2.GBL, LimeSDR-Micro_1v2.GBO, LimeSDR-Micro_1v2.GBP, LimeSDR-Micro_1v2.GBS, LimeSDR-Micro_1v2.GM1, LimeSDR-Micro_1v2.GTL, LimeSDR-Micro_1v2.GTO, LimeSDR-Micro_1v2.GTP]
2025-09-10 Updated Project to include new draftsman
    [LimeSDR-Micro_M.2_2280_1v0.PrjPcb]
2025-09-11 Added draftsman
    [LimeSDR-Micro_1v1.PrjPcb]
2025-10-06 added M.2 board folder
    [01_Block_Diagram.SchDoc, 02_Power_Diagram.SchDoc, 03_Clock_Diagram.SchDoc, 04_RF_Diagram.SchDoc, 05_LMS7002M_Misc.SchDoc, 06_LMS7002M_RF.SchDoc, 07_LMS7002M_Power.SchDoc, 08_BB_Processor.SchDoc]
2025-10-06 Revert "added M.2 board folder"
    This reverts commit 7e181af8d5b81d8b5166d771dbc90f99e38c78e3.
    [01_Block_Diagram.SchDoc, 02_Power_Diagram.SchDoc, 03_Clock_Diagram.SchDoc, 04_RF_Diagram.SchDoc, 05_LMS7002M_Misc.SchDoc, 06_LMS7002M_RF.SchDoc, 07_LMS7002M_Power.SchDoc, 08_BB_Processor.SchDoc]
2025-10-06 Added M.2 boards folder (Submodule fix)
    [01_Block_Diagram.SchDoc, 02_Power_Diagram.SchDoc, 03_Clock_Diagram.SchDoc, 04_RF_Diagram.SchDoc, 05_LMS7002M_Misc.SchDoc, 06_LMS7002M_RF.SchDoc, 07_LMS7002M_Power.SchDoc, 08_BB_Processor.SchDoc]
2025-10-06 Added mPCIe boards folder
    [01_Block_Diagram.SchDoc, 02_Power_Diagram.SchDoc, 03_Clock_Diagram.SchDoc, 04_RF_Diagram.SchDoc, 05_LMS7002M_Misc.SchDoc, 06_LMS7002M_RF.SchDoc, 07_LMS7002M_Power.SchDoc, 08_BB_Processor.SchDoc]
2025-10-06 Revert "Merge remote-tracking branch 'LimeSDR-Micro_M.2/main'"
    This reverts commit 64724eaa361bf479c6687758ccb580e1cf4f0170, reversing
    changes made to ab6a2dd284b5dbcbb0a9e3ad104bdbe7f5bb3124.
    [01_Block_Diagram.SchDoc, 02_Power_Diagram.SchDoc, 03_Clock_Diagram.SchDoc, 04_RF_Diagram.SchDoc, 05_LMS7002M_Misc.SchDoc, 06_LMS7002M_RF.SchDoc, 07_LMS7002M_Power.SchDoc, 08_BB_Processor.SchDoc]
2025-10-06 Reapply "Merge remote-tracking branch 'LimeSDR-Micro_M.2/main'"
    This reverts commit fb2651e3d1c012d9ffb0095f9c2b863f1019f3d8.
    [01_Block_Diagram.SchDoc, 02_Power_Diagram.SchDoc, 03_Clock_Diagram.SchDoc, 04_RF_Diagram.SchDoc, 05_LMS7002M_Misc.SchDoc, 06_LMS7002M_RF.SchDoc, 07_LMS7002M_Power.SchDoc, 08_BB_Processor.SchDoc]
2025-10-06 Added docs
    [LimeSDR-Micro v1.1 doc tables.xlsx, LimeSDR-Micro v1.2 doc tables.xlsx, LimeSDR-Micro_M.2_v1.0 doc tables.xlsx]
2025-11-20 Initial commit based on v1.0
    [01_Block_Diagram.SchDoc, 02_Power_Diagram.SchDoc, 03_Clock_Diagram.SchDoc, 04_RF_Diagram.SchDoc, 05_LMS7002M_Misc.SchDoc, 06_LMS7002M_RF.SchDoc, 07_LMS7002M_Power.SchDoc, 08_BB_Processor.SchDoc]
2025-11-20 Changed GNSS power rail from VCC3P3_CLK to VCC3P3 to minimize GNSS module spurs in RF TX.
    [09_Misc.SchDoc]
2025-11-20 Removed temp sheet
    [12_temp.SchDoc, LimeSDR-Micro_M.2_2280_1v1.PrjPcb]
2025-11-20 Replaced LMK00105 IC16 clock buffer with LMK00101
    Removed IC16 74LVC1G3157FZ4 analog mux for CLK_XO/XLK_IN clock mux.
    Replaced LMK00105 IC16 clock buffer with LMK00101. No external mux is required because LMK00101 has two inputs.
    [10_Clock.SchDoc]
2025-11-25 Added tespoint for LA_CFG_BOOT_SRC0 to easier change boot mode to I2C EEPROM
    [09_Misc.SchDoc]
2025-11-25 Changed LA_CFG_PCIE_GEN configuration to 1: PCIe interface will allow negotiation to PCIe Gen3 (8 Gbit/s) frequencies
    [09_Misc.SchDoc]
2025-11-25 Place on top for TP6
    [09_Misc.SchDoc]
2025-11-25 Changed level converter LA_CFG_BOOT_SRC0 -> LA_TRX0 connections to LA_CFG_BOOT_SRC1 -> LA_TRX1 and connected LA_TRX1 TX switch control to instead TX_SW.
    [06_LMS7002M_RF.SchDoc, 09_Misc.SchDoc]
2025-11-25 Renamed LMK_CLKOUT4 to LMK_CLKOUT7 respectively
    [10_Clock.SchDoc]
2025-11-25 Renamed TX_SW to CLK_EXT_SEL and connected to CLK_EXT_SEL clock mux control
    [09_Misc.SchDoc]
2025-11-25 Added analog mux for CLK_EXT line to select between LMK_CLKOUT1 and CLK_IN
    [10_Clock.SchDoc]
2025-11-26 Updated voltage dividers output voltages
    [06_LMS7002M_RF.SchDoc]
2025-11-26 Added secure key option (NF due to I2C address conflict with switching regulator)
    [09_Misc.SchDoc, 11_Power.SchDoc]
2025-11-27 Conencted J3 directly to LMK_CLKOUT1
    [10_Clock.SchDoc]
2025-11-27 Connected MHF4 connector J2 directly to LMK CLKin1
    [10_Clock.SchDoc]
2025-11-27 Connected MHF4 connector J5 to EXT_PPS mux for EXT_PPS_IN/EXT_PPS_OUT.
    Disconnected MHF4 connector J3 from EXT_PPS_IN.
    Disconnected MHF4 connector J5 from EXT_PPS_OUT.
    Connected MHF4 connector J5 to EXT_PPS mux for EXT_PPS_IN/EXT_PPS_OUT.
    [09_Misc.SchDoc, 10_Clock.SchDoc]
2025-11-27 Removed secure key IC32 SOIC8 package
    [09_Misc.SchDoc]
2025-11-27 PCB routed
2025-11-27 Added MHF4 connector for LA_PA_EN
    [09_Misc.SchDoc]
2025-11-27 Connected LA_I2C to FPC connector instead GND pins
    [09_Misc.SchDoc]
2025-11-28 Added ESD (NF) for ADF_REF_IN and LMK_CLKOUT1
    [10_Clock.SchDoc]
2025-11-28 Added PROJECT_VERSION and SHEET_TOTAL parameters
    [LimeSDR-Micro_M.2_2280_1v1.PrjPcb]
2025-11-28 Added =PROJECT_VERSION and =SHEET_TOTAL to sheet parameters
    [01_Block_Diagram.SchDoc, 02_Power_Diagram.SchDoc, 03_Clock_Diagram.SchDoc, 04_RF_Diagram.SchDoc, 05_LMS7002M_Misc.SchDoc, 06_LMS7002M_RF.SchDoc, 07_LMS7002M_Power.SchDoc, 08_BB_Processor.SchDoc]
2025-11-28 Changed M.2 LA_CFG_BOOT_SRC0 net to LA_CFG_BOOT_SRC1 and M.2_TRX0 to M.2_TRX1
    [09_Misc.SchDoc]
2025-11-28 DRC clean, templates updated
    [01_Block_Diagram.SchDoc, 02_Power_Diagram.SchDoc, 03_Clock_Diagram.SchDoc, 04_RF_Diagram.SchDoc, 05_LMS7002M_Misc.SchDoc, 06_LMS7002M_RF.SchDoc, 07_LMS7002M_Power.SchDoc, 08_BB_Processor.SchDoc]
2025-11-28 Reannotated whole project
    [05_LMS7002M_Misc.SchDoc, 06_LMS7002M_RF.SchDoc, 07_LMS7002M_Power.SchDoc, 08_BB_Processor.SchDoc, 09_Misc.SchDoc, 10_Clock.SchDoc, 11_Power.SchDoc]
2025-11-28 Added Default variant
    [LimeSDR-Micro_M.2_2280_1v1.PrjPcb]
2025-11-28 PCB synched after reannotation
2025-11-28 Updated default variant
    [LimeSDR-Micro_M.2_2280_1v1.PrjPcb]
2025-12-01 top silkscreen updated
2025-12-01 Removed NF markings
    [05_LMS7002M_Misc.SchDoc, 06_LMS7002M_RF.SchDoc, 07_LMS7002M_Power.SchDoc, 08_BB_Processor.SchDoc, 09_Misc.SchDoc, 10_Clock.SchDoc, 11_Power.SchDoc]
2025-12-01 Removed NF info from "Assembly Info" field
    [05_LMS7002M_Misc.SchDoc, 06_LMS7002M_RF.SchDoc, 08_BB_Processor.SchDoc, 09_Misc.SchDoc, 10_Clock.SchDoc, 11_Power.SchDoc]
2025-12-01 Changed HW_VER from 0 to 1
    [09_Misc.SchDoc]
2025-12-01 pcb sync
2025-12-02 ESD10 fit
    [10_Clock.SchDoc]
2025-12-02 Revert "ESD10 fit"
    This reverts commit 3daf7c2f50f855941f1b3cd4f2b6ea3d6841cd1f.
    [10_Clock.SchDoc]
2025-12-02 Reapply "ESD10 fit"
    This reverts commit 237eabe63971c8024317d1a166d09787d72dd983.
    [10_Clock.SchDoc]
2025-12-02 Disabled M.2_CLK_IN clock in path by default (0R NF)
    [LimeSDR-Micro_M.2_2280_1v1.PrjPcb]
2025-12-02 Fitted ESDs
    [06_LMS7002M_RF.SchDoc, 09_Misc.SchDoc, 10_Clock.SchDoc, LimeSDR-Micro_M.2_2280_1v1.PrjPcb]
2025-12-04 Removed changes notes and markings
    [06_LMS7002M_RF.SchDoc, 09_Misc.SchDoc, 10_Clock.SchDoc]
2025-12-04 X3 (RX AUX) circuit NF
    [LimeSDR-Micro_M.2_2280_1v1.PrjPcb]
2025-12-04 Generated schematic
2025-12-08 Initial commit based on v1.2
    [01_Block_Diagram.SchDoc, 02_Power_Diagram.SchDoc, 03_Clock_Diagram.SchDoc, 04_RF_Diagram.SchDoc, 05_LMS7002M_Misc.SchDoc, 06_LMS7002M_RF.SchDoc, 07_LMS7002M_Power.SchDoc, 08_BB_Processor.SchDoc]
2025-12-08 Implemented clock changes from LimeSDR-Micro_M.2_2280 v1.1
    Removed IC17 74LVC1G3157FZ4 analog mux for CLK_XO/XLK_IN clock mux.
    Connected MHF4 connector J2 directly to LMK CLKin1
    Connected U.FL connector J3 directly to LMK_CLKOUT1
    Disconnected U.FL connector J3 from EXT_PPS_IN.
    Disconnected U.FL connector J5 from EXT_PPS_OUT.
    Connected U.FL connector J5 to EXT_PPS mux for
    EXT_PPS_IN/EXT_PPS_OUT
    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
    [10_Clock.SchDoc]
2025-12-08 Added ESD for ADF_REF_IN
    [10_Clock.SchDoc]
2025-12-08 Renamed TX_SW to EXT_PPS_SEL and connected to EXT_PPS mux control
    [09_Misc.SchDoc]
2025-12-08 Changed LA_CFG_PCIE_GEN configuration to 1: PCIe interface will allow negotiation to PCIe Gen3 (8Gbit/s) frequencies
    [09_Misc.SchDoc]
2025-12-08 Added testpoint for LA_CFG_BOOT_SRC0 to easier change boot mode to I2C EEPROM
    [09_Misc.SchDoc]
2025-12-08 Changed mPCIe LA_CFG_BOOT_SRC0 net to LA_CFG_BOOT_SRC1 (level converter TDD0_GPIO_LS->TDD0_GPIO)
    [09_Misc.SchDoc]
2025-12-08 Changed level converter LA_CFG_BOOT_SRC0 -> TDD0_GPIO_LS -> TDD0_GPIO connections to LA_CFG_BOOT_SRC1 -> TDD0_GPIO_LS -> TDD0_GPIO and connected TDD0_GPIO to TX switch control instead TX_SW.
    [06_LMS7002M_RF.SchDoc]
2025-12-08 ESDs fitted
    [06_LMS7002M_RF.SchDoc]
2025-12-08 TP annotated
    [09_Misc.SchDoc]
2025-12-08 GNSS_ANT ESD fitted
    [09_Misc.SchDoc]
2025-12-08 Added testpoints for GNSS_TXD and GNSS_RXD
    [09_Misc.SchDoc]
2025-12-09 Added U.FL connector for TDD1_GPIO
    [09_Misc.SchDoc]
2025-12-09 X3 (RX AUX) circuit removed
    [06_LMS7002M_RF.SchDoc]
2025-12-10 Connected LMK GND
    [10_Clock.SchDoc]
2025-12-10 J2 changed to X3
    [09_Misc.SchDoc]
2025-12-10 Changed TP5 and TP6 to graphical
    [09_Misc.SchDoc]
2025-12-10 Changed X3 designator to J2
    [09_Misc.SchDoc]
2025-12-10 Update LimeSDR-Micro_mPCIe_1v3.PrjPcb
    Added PROJECT_VERSION and SHEET_TOTAL parameters
    [LimeSDR-Micro_mPCIe_1v3.PrjPcb]
2025-12-10 Added PROJECT_VERSION and SHEET_TOTAL parameters to schematic sheets
    [01_Block_Diagram.SchDoc, 02_Power_Diagram.SchDoc, 03_Clock_Diagram.SchDoc, 04_RF_Diagram.SchDoc, 05_LMS7002M_Misc.SchDoc, 06_LMS7002M_RF.SchDoc, 07_LMS7002M_Power.SchDoc, 08_BB_Processor.SchDoc]
2025-12-10 Changed X3 designator to J6
    [09_Misc.SchDoc]
2025-12-10 moved I2C secure key and I2C level converters
    [09_Misc.SchDoc, 10_Clock.SchDoc]
2025-12-10 mPCIe PCB routed
2025-12-11 Variant fix
    [LimeSDR-Micro_M.2_2280_1v1.PrjPcb]
2025-12-11 Updated IC15 footprint
    [09_Misc.SchDoc]
2025-12-11 Updated secure key footprint
    [09_Misc.SchDoc]
2025-12-11 Secure key cap designator fix
    [09_Misc.SchDoc]
2025-12-11 Added mechanical testpoint for A1
    [09_Misc.SchDoc]
2025-12-11 Changed TP5, TP6 to mechanical
    [09_Misc.SchDoc]
2025-12-11 mPCIe and M.2 boards updated with ATECC508A_UDFN8_v2
2025-12-11 Updated Rakon RAKON_RPT7050A footprint 3D body
    Libraries added to both mPCIe and M.2 boards
2025-12-11 Added tespoint for EXP_GPA2
    [09_Misc.SchDoc]
2025-12-11 M.2 PCB cosmetics. DRC clean
2025-12-11 Removed changes marks and notes
    [06_LMS7002M_RF.SchDoc, 09_Misc.SchDoc]
2025-12-11 Updated schematic PDF
2025-12-11 Created default variant
    [LimeSDR-Micro_mPCIe_1v3.PrjPcb]
2025-12-11 mPCIe template updated
    [01_Block_Diagram.SchDoc, 02_Power_Diagram.SchDoc, 03_Clock_Diagram.SchDoc, 04_RF_Diagram.SchDoc, 05_LMS7002M_Misc.SchDoc, 06_LMS7002M_RF.SchDoc, 07_LMS7002M_Power.SchDoc, 08_BB_Processor.SchDoc]
2025-12-12 Remove docs from this branch, now that they are on the dedicated docs branch.
    [LimeSDR-Micro v1.1 doc tables.xlsx, LimeSDR-Micro v1.2 doc tables.xlsx, LimeSDR-Micro_M.2_v1.0 doc tables.xlsx]
2025-12-16 JTAG_RST disconnected (0R not fitted).
    [08_BB_Processor.SchDoc, LimeSDR-Micro_mPCIe_1v3.PrjPcb]
2025-12-16 LMS_TXEN
    LA_CFG_TEST_PORT_DIS line via 1.8 -> 3.3V conversion disconnected from LA_LNA1_EN and connected to LMS_TXEN.
    Renamed A1 line to EXP_GPA1 and connected to FPC connector pin 6 instead LA_LNA1_EN.
    [05_LMS7002M_Misc.SchDoc, 09_Misc.SchDoc]
2025-12-17 Removed changes marks
    [05_LMS7002M_Misc.SchDoc, 09_Misc.SchDoc]
2025-12-17 Updated schematic
2025-12-17 LMS_TXEN connection and other mods
    LA_CFG_TEST_PORT_DIS line via 1.8 -> 3.3V conversion disconnected from LA_LNA1_EN and connected to LMS_TXEN
    LA_CFG_PCIE_GEN line via 0R (LNA2_EN_LS) and via 1.8 -> 3.3V conversion (LA_LNA2_EN) replaced LA_LNA1_EN line RFCTL FPC connector and mPCIe pin 45
    [05_LMS7002M_Misc.SchDoc, 09_Misc.SchDoc]
2025-12-17 R151 question
    [10_Clock.SchDoc]
2025-12-17 Disabled PCIE_CLK_IN clock in path by default (0R NF)
    [10_Clock.SchDoc, LimeSDR-Micro_mPCIe_1v3.PrjPcb]
2025-12-18 Micro_mPCIe_1v3 output jobs and silkscreen
2025-12-18 m.2 and mPCIe BOM output job variation changed to default
2025-12-18 Removed NF information
    [05_LMS7002M_Misc.SchDoc, 06_LMS7002M_RF.SchDoc, 07_LMS7002M_Power.SchDoc, 08_BB_Processor.SchDoc, 09_Misc.SchDoc, 10_Clock.SchDoc, 11_Power.SchDoc]
2025-12-18 Removed changes markings
    [05_LMS7002M_Misc.SchDoc, 06_LMS7002M_RF.SchDoc, 08_BB_Processor.SchDoc, 09_Misc.SchDoc, 10_Clock.SchDoc]
2025-12-19 LimeSDR-Micro_M.2_2280_1v1 DFM database generated
    [09_Misc.SchDoc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]
2025-12-19 LimeSDR-Micro_mPCIe_1v3 DFM database generated
    [09_Misc.SchDoc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]
2025-12-22 Updated schematic (clock diagram change)
2026-01-07 LimeSDR-Micro_mPCIe_1v3_DFMr0 updated
    Bottom silkscreen updated, updated schematic added to database
    [LimeSDR-Micro_mPCIe_1v3.GBO]
2026-01-07 LimeSDR-Micro_mPCIe_1v3(_DB)_DFMr0 updated
    Layer 2 gerber (.G1) updated - removed cutout under GNSS UFL. Updated PCB, and .G1 gerber file -> database and final project archive
    [LimeSDR-Micro_mPCIe_1v3.GBO]
2026-01-12 LimeSDR-Micro_mPCIe_1v3_DFMr1 created
    - Small PCB updates during manufacturer EQ;
    - Bottom silkscreen updated, R166 moved away from the edge, vias at the origin on the edge of the board moved away from the edge, GNSS UFL cut-out removed and L3 traces under it shifted.
    - All DFM files refreshed
    - change list added
    [LimeSDR-Micro_mPCIe_1v3.GBL, LimeSDR-Micro_mPCIe_1v3.GBO, LimeSDR-Micro_mPCIe_1v3.GBP, LimeSDR-Micro_mPCIe_1v3.GBS, LimeSDR-Micro_mPCIe_1v3.GM1, LimeSDR-Micro_mPCIe_1v3.GTL, LimeSDR-Micro_mPCIe_1v3.GTO, LimeSDR-Micro_mPCIe_1v3.GTP]
2026-02-18 Initial LimeSDR-Micro_mPCIe_1v4 commit based on LimeSDR-Micro_mPCIe_1v3
    [01_Block_Diagram.SchDoc, 02_Power_Diagram.SchDoc, 03_Clock_Diagram.SchDoc, 04_RF_Diagram.SchDoc, 05_LMS7002M_Misc.SchDoc, 06_LMS7002M_RF.SchDoc, 07_LMS7002M_Power.SchDoc, 08_BB_Processor.SchDoc]
2026-02-18 Changed version
    [LimeSDR-Micro_mPCIe_1v4.PrjPcb]
2026-02-18 DPDT RF switch (SKY13411-374LF)
    Changed TX RF switch 2:1 (SKY13330-397LF) to DPDT RF switch (SKY13411-374LF)
    Changed RX RF switch 3:1 (SKY13414-485LF) to DPDT RF switch (SKY13411-374LF)
    [06_LMS7002M_RF.SchDoc]
2026-02-18 Removed LMS RX1_l and RX2_L channel
    [06_LMS7002M_RF.SchDoc]
2026-03-18 Initial 1v2 commit based on 1v1
    [01_Block_Diagram.SchDoc, 02_Power_Diagram.SchDoc, 03_Clock_Diagram.SchDoc, 04_RF_Diagram.SchDoc, 05_LMS7002M_Misc.SchDoc, 06_LMS7002M_RF.SchDoc, 07_LMS7002M_Power.SchDoc, 08_BB_Processor.SchDoc]
2026-03-18 Added DIP switch for LA_CFG_BOOT_SRC0
    [09_Misc.SchDoc]
2026-03-18 M.2 pins
    Disconnected M.2_GPIO_1 from pin 42
    Connected M.2_GPIO_1 via 0R (as it was) to M.2 pin 58 (MFG_CLOCK).
    Renamed M.2_GPIO_1 to M.2_MFG.
    Disconected M.2_TRX1 from pin 40
    Connected M.2_TRX1 via 0R (as it was) to M.2 pin 56 (MFG_DATA).
    Connected LA_I2C_SDA_LS via 0R NF to M.2 pin 42 (SMB_DATA).
    Connected LA_I2C_SCL_LS via 0R NF to M.2 pin 40 (SMB_CLK).
    [09_Misc.SchDoc]
2026-03-18 Changed from HW_VER = 1 [0 1] to HW_VER = 2 [1 0]
    [09_Misc.SchDoc]
2026-03-18 Changed project version
    [LimeSDR-Micro_M.2_2280_1v2.PrjPcb]
2026-03-19 Schematic updated
    [09_Misc.SchDoc]
2026-03-19 Removed DPSW1. Added TH jumper (NF) for LA_CFG_BOOT_SRC0, removed TP6.
    [09_Misc.SchDoc]
2026-03-19 Variant update
    [09_Misc.SchDoc, LimeSDR-Micro_M.2_2280_1v2.PrjPcb]
2026-03-19 Added PNs for JMP1 and JP1
    [09_Misc.SchDoc]
2026-03-20 Silkscreen updated
2026-03-23 Change schematic pdf file name
2026-03-25 Connected LA_PA_EN via 0R fit to J2 instead direct connection. Connected LMS_TSTAO, LMS_TSTDO0, LMS_TSTDO1 via 0R NF to J2 (PA_EN).
    [05_LMS7002M_Misc.SchDoc, 09_Misc.SchDoc, LimeSDR-Micro_M.2_2280_1v2.PrjPcb]
2026-03-25 Update 09_Misc.SchDoc
    Cosmetic
    [09_Misc.SchDoc]
2026-03-25 Changed default CORE_LDO_EN level to low (R13 NF, R15fit).
    Changed default CORE_LDO_EN level to low (R13 NF, R15fit). This disables internal LDOs by default, but they can be enabled later via SPI interface.
    [05_LMS7002M_Misc.SchDoc, LimeSDR-Micro_M.2_2280_1v2.PrjPcb]
2026-03-25 Removed series 0R on RX BB path: C8, C12, C13, C17, C18, C22, C23, C27
    [05_LMS7002M_Misc.SchDoc]
2026-03-25 Removed series 0R on RX BB path: R28, R34, R37, R42, R44, R49, R51, R58
    [05_LMS7002M_Misc.SchDoc]
2026-03-25 Connected LMS RBB to ADCIN (Ch 1, 2 I/Q). This will help to utilize internal BB ADC for DC ofset and RSSI calibration.
    Connected LMS RBB to ADCIN (Ch 1, 2 I/Q). This will help to utilize internal BB ADC for DC ofset and RSSI calibration.
    Y6 -> V4
    AB2 -> U5
    AB4 -> Y2
    AA5 -> W3
    AD2-> AA1
    AC3 -> V6
    AC5 -> AA3
    AB6 ->Y4
    [05_LMS7002M_Misc.SchDoc]
2026-03-25 Changed VDD_TBB (P4) power from VCC1P25_LMS to VCC1P4_LMS.
    Changed VDD_TBB (P4) power from VCC1P25_LMS to VCC1P4_LMS. This will increase Tbb gain saturation by 1-2dB.
    [07_LMS7002M_Power.SchDoc]
2026-03-25 Changed VDD_TBB (P4) power from VCC1P25_LMS to VCC1P4_LMS. Added FR1 (NF) and VCC1P25_LMS left as optional.
    Changed VDD_TBB (P4) power from VCC1P25_LMS to VCC1P4_LMS. Added FR1 (NF) and VCC1P25_LMS left as optional.
    This will increase Tbb gain saturation by 1-2dB.
    [07_LMS7002M_Power.SchDoc, LimeSDR-Micro_M.2_2280_1v2.PrjPcb]
2026-03-26 Fixed LMS_ADCIN classess
    [05_LMS7002M_Misc.SchDoc]
2026-03-26 LMS BB and ADC length matching finished. DRC clean
2026-03-30 Updated note.
    [05_LMS7002M_Misc.SchDoc]
2026-03-30 Removed old draftsman
    [LimeSDR-Micro_M.2_2280_1v2.PrjPcb]
2026-03-30 Removed changed marks and notes
    [05_LMS7002M_Misc.SchDoc, 07_LMS7002M_Power.SchDoc, 09_Misc.SchDoc]
2026-03-31 LimeSDR-Micro_M.2_2280_1v2(_DB)_DFMr0 generated
    [LimeSDR-Micro_M.2_2280_1v2.GBL, LimeSDR-Micro_M.2_2280_1v2.GBO, LimeSDR-Micro_M.2_2280_1v2.GBP, LimeSDR-Micro_M.2_2280_1v2.GBS, LimeSDR-Micro_M.2_2280_1v2.GM1, LimeSDR-Micro_M.2_2280_1v2.GTL, LimeSDR-Micro_M.2_2280_1v2.GTO, LimeSDR-Micro_M.2_2280_1v2.GTP]
2026-05-13 Fixed schematic pdf file name
2026-06-01 Removed all unfinished v1.4 project files (with RF loopback)
    [01_Block_Diagram.SchDoc, 02_Power_Diagram.SchDoc, 03_Clock_Diagram.SchDoc, 04_RF_Diagram.SchDoc, 05_LMS7002M_Misc.SchDoc, 06_LMS7002M_RF.SchDoc, 07_LMS7002M_Power.SchDoc, 08_BB_Processor.SchDoc]
2026-06-01 Initial commit based on v1.3
    [01_Block_Diagram.SchDoc, 02_Power_Diagram.SchDoc, 03_Clock_Diagram.SchDoc, 04_RF_Diagram.SchDoc, 05_LMS7002M_Misc.SchDoc, 06_LMS7002M_RF.SchDoc, 07_LMS7002M_Power.SchDoc, 08_BB_Processor.SchDoc]
2026-06-02 Changes project version variable
    [LimeSDR-Micro_mPCIe_1v4.PrjPcb]
2026-06-02 Changed default CORE_LDO_EN level to low (R13 NF, R15 fit). This disables internal LDOs by default, but they can be enabled later via SPI interface.
    [05_LMS7002M_Misc.SchDoc, LimeSDR-Micro_mPCIe_1v4.PrjPcb]
2026-06-02 Connected LMS RX BB to ADCIN (Ch 1, 2 I/Q). Removed series 0R on RX BB path.
    [05_LMS7002M_Misc.SchDoc, LimeSDR-Micro_mPCIe_1v4.PrjPcb]
2026-06-02 PCB synced
    [LimeSDR-Micro_mPCIe_1v4.PcbDoc]
2026-06-02 Changed VDD_TBB (P4) power from VCC1P25_LMS to VCC1P4_LMS. Added FR1 (NF) and VCC1P25_LMS left as optional. This will increase Tbb gain saturation by 1-2dB.
    [07_LMS7002M_Power.SchDoc, LimeSDR-Micro_mPCIe_1v4.PrjPcb]
2026-06-02 Changed default BOOT_SRC to EEPROM (R112 NF, R122 fit)
    [09_Misc.SchDoc, LimeSDR-Micro_mPCIe_1v4.PrjPcb]
2026-06-02 Connected LMS_TSTAO, LMS_TSTDO0, LMS_TSTDO1 via 0R NF to J2 (TDD1_GPIO) for test signals measurement as option (PLL optimization etc.).
    [05_LMS7002M_Misc.SchDoc, 09_Misc.SchDoc, LimeSDR-Micro_mPCIe_1v4.PrjPcb]
2026-06-03 Added TH jumper (NF) for LA_CFG_BOOT_SRC0, removed TP6. TP6 for LA_CFG_BOOT_SRC0 line was removed.
    [09_Misc.SchDoc]
2026-06-03 Swapped mPCIe 17 and 20 pins (TDD0_GPIO and TDD0_GPI1)
    This fixes TDD0_GPIO control LimeFEA control, because TDD0_GPIO also controls TX band selection (LA_CFG_BOOT_SRC1).
    Now LimeFEA will be controlled from dedicated TDD0_GPI1 (mPCIe pin 17).
    [09_Misc.SchDoc]
2026-06-03 JMP1 and JP1 NF
    [LimeSDR-Micro_mPCIe_1v4.PrjPcb]
2026-06-03 PCB synced, DRC clean
    [LimeSDR-Micro_mPCIe_1v4.PcbDoc]
2026-06-11 Fixed all 0201 100nF 1276-1321-1-ND capacitors wrong voltage value (comment) visible in schematic from 6.3V to 10V.
    [06_LMS7002M_RF.SchDoc, 08_BB_Processor.SchDoc, 09_Misc.SchDoc, 10_Clock.SchDoc, 11_Power.SchDoc]
2026-06-12 All terminating 0R resistors on RX observation external BB FPC connector changed to NF (unpopulated). This is required for connecting LimeFEA-HF board or other BB source.
    [08_BB_Processor.SchDoc, LimeSDR-Micro_mPCIe_1v4.PrjPcb]
2026-06-15 Updated schematic pdf file name
